bytecod3/Project-Shadow-Flight/payload/README.md

## References 
- https://stm32-base.org/boards/STM32F407VGT6-STM32F4XX-M.html
- https://blog.shirtec.com/2019/12/ov5640-with-stm32f427.html
