bytecod3/Project-Shadow-Flight/documentation/plant-uml-diagrams/README.md

## To generate UML diagram 
Go to downloads folder, then run:
``` java -jar plantuml.jar -gui```

It will open a GUI with a button to change directory:
CLick and open this directory. 

Now if you make any change to a uml.md file, a corresponding png file will be generated
