bytecod3/Project-Shadow-Flight/documentation/Project Shadow Flight Technical Report .docx

## Project Shadow Flight - A 1U Amateur CubeSat Built from the Ground Up

## Technical Report

## Edwin Mwiti

Table of Contents

Executive Summary

Introduction

1.1. Mission Statement & Objectives

1.2. Project Motivation

1.3. System Overview

Mission Architecture

3.1. Mission Design

3.2. Payload Requirements & Specifications

3.3. Operational Concept

System Design

4.1. Onboard Computer (OBC)

4.1.1. Functional Requirements

4.1.2. Hardware Architecture

4.1.3. Software Architecture

4.2. Sensor System

4.2.1. Sensor Requirements

4.2.2. Communication Protocol

4.2.3. PC/104 ISA Bus Interface

4.2.4. Pin Definition & Interface

4.3. Attitude Determination and Control System (ADCS)

4.4. Electrical Power System (EPS)

4.4.1. Power Generation (Solar Arrays)

4.4.2. Energy Storage (Battery System)

4.4.3. Power Distribution & Regulation

4.4.4. Mission Power Analysis

4.4.5. EPS Schematic & Design

4.4.6. System Testing & Integration

4.5. Communication System

4.5.1. CCSDS Telemetry Protocol Implementation

4.5.2. Ground Station Interface

4.5.3. Data Handling & Limitations

Integration & Testing

5.1. Component-Level Testing

5.2. System Integration

5.3. Environmental Testing

5.4. Operational Testing

Mission Operations

6.1. Command & Data Handling

6.2. Telemetry & Telecommand

6.3. Contingency Procedures

Project Documentation

7.1. Design Documentation

7.2. Visual Media & Resources

7.3. Web Documentation

Appendices

A. Component Specifications

B. Test Procedures & Results

C. Communication Protocol Details

D. Schematics & PCB Layouts

E. 3D Models & Mechanical Drawings

References

Acknowledgements

10.1. Contributors

10.2. Supporting Organizations

Onboard Computer (OBC)

Attitude Determination and Control Unit (ADCU)

Communication Board

Payload

Electrical Power Supply System (EPS)

The EPS system is responsible for supplying power to itself and all other subsystems in the cubesat. This section will describe the features of the EPS design, design decisions, design tradeoffs, strengths, and areas of improvement. Code snippets of the EPS subsystem are also provided for quick reference and explanation. The full firmware explanation is included in sections below for completeness.

Firmware Design

Architecture Diagram

Firmware requirements

OBC

COMMS

ADCU

Payload

EPS

References

1. https://ww1.microchip.com/downloads/aemDocuments/documents/OTH/ApplicationNotes/ApplicationNotes/00001521A.pdf
