bytecod3/Project-Shadow-Flight/datasheets/black-pill-pinout.png

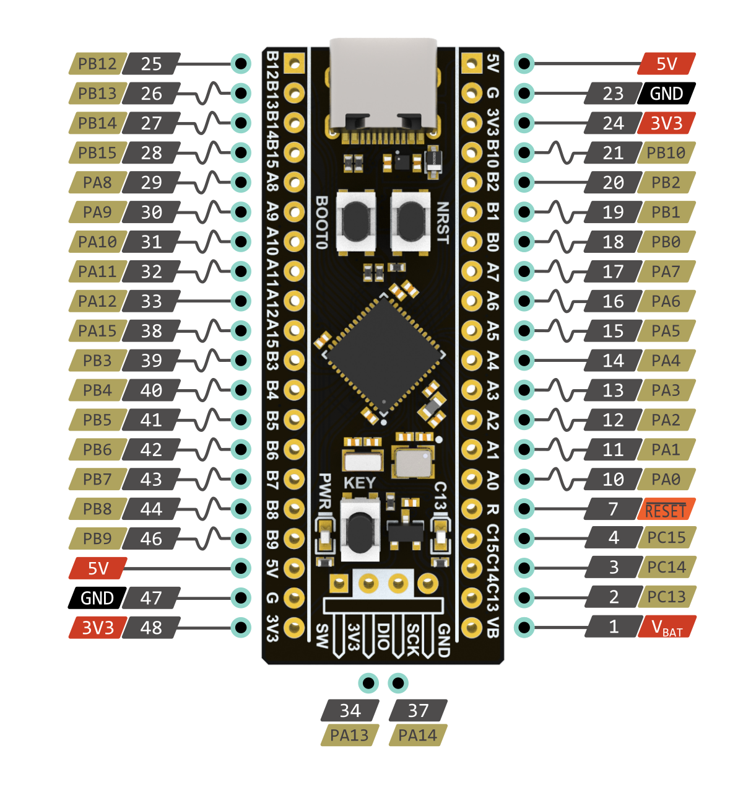
datasheets/black-pill-pinout.png
