bytecod3/Project-Shadow-Flight/datasheets/Pinout-Diagram-blackpill-nerokas.png

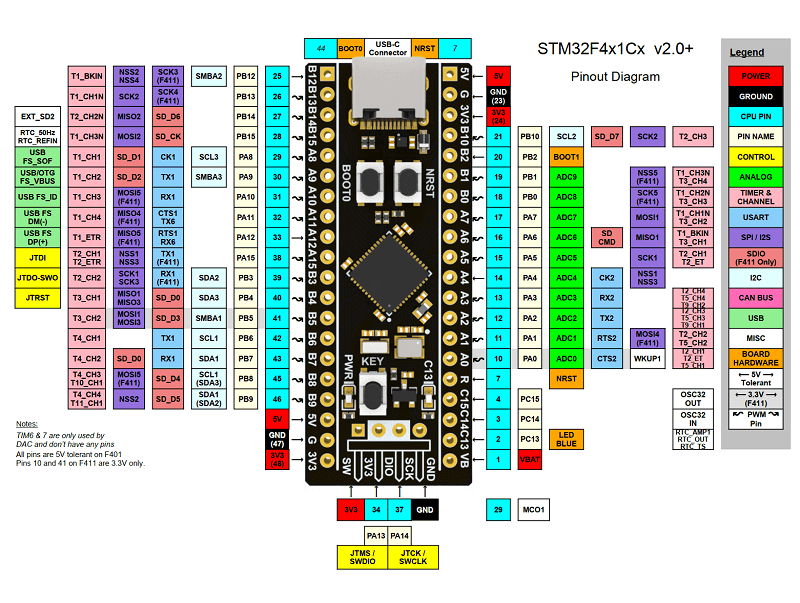
datasheets/Pinout-Diagram-blackpill-nerokas.png
