bytecod3/Project-Shadow-Flight/datasheets/STLINK-V2-JTAG-HEADER-PINOUT.png

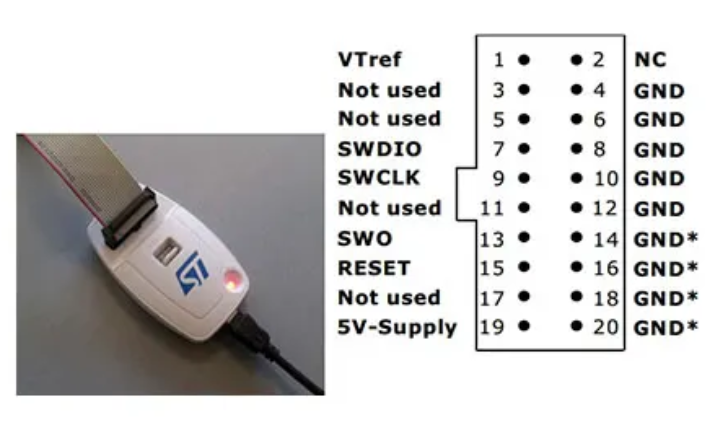
datasheets/STLINK-V2-JTAG-HEADER-PINOUT.png
