bytecod3/Project-Shadow-Flight/documentation/firmware-docs/html/user-docs/images/payload-1.png

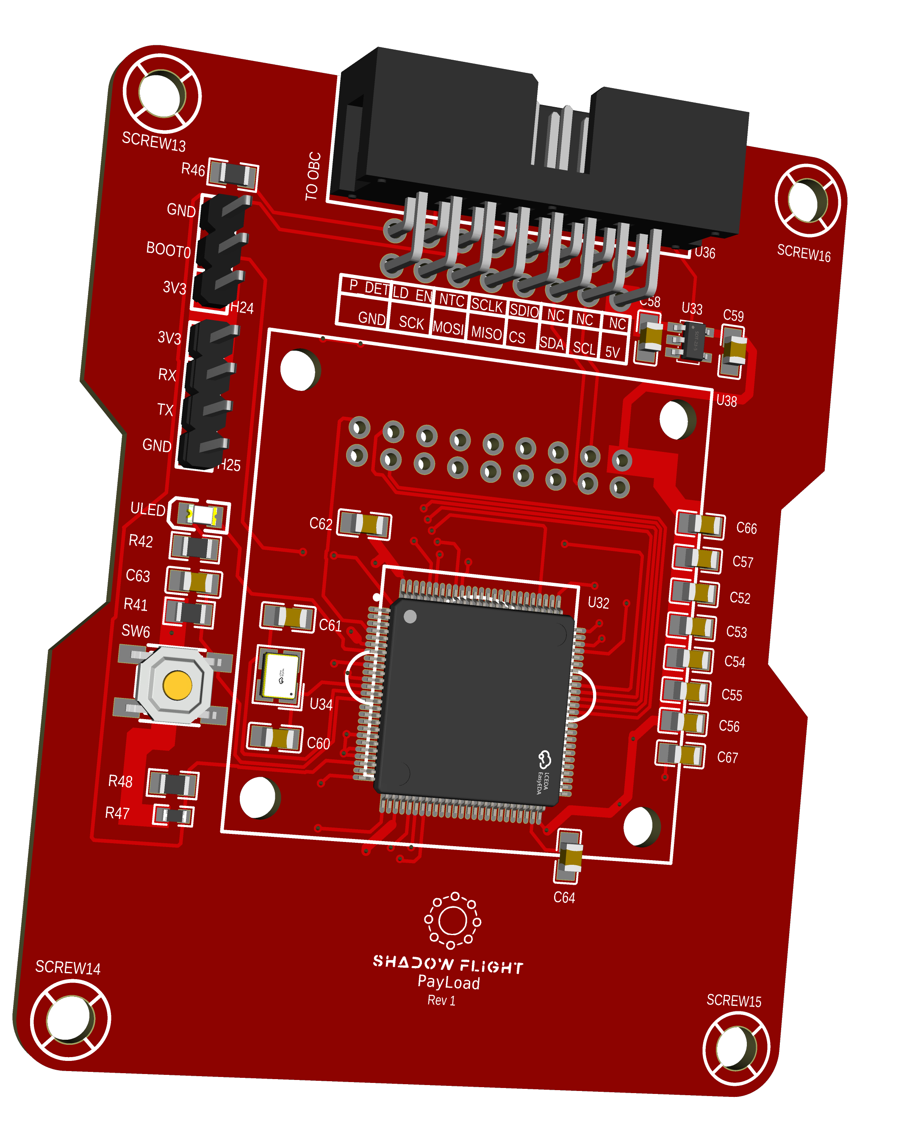
documentation/firmware-docs/html/user-docs/images/payload-1.png
