bytecod3/Project-Shadow-Flight/documentation/firmware-docs/html/user-docs/images/payload-2.png

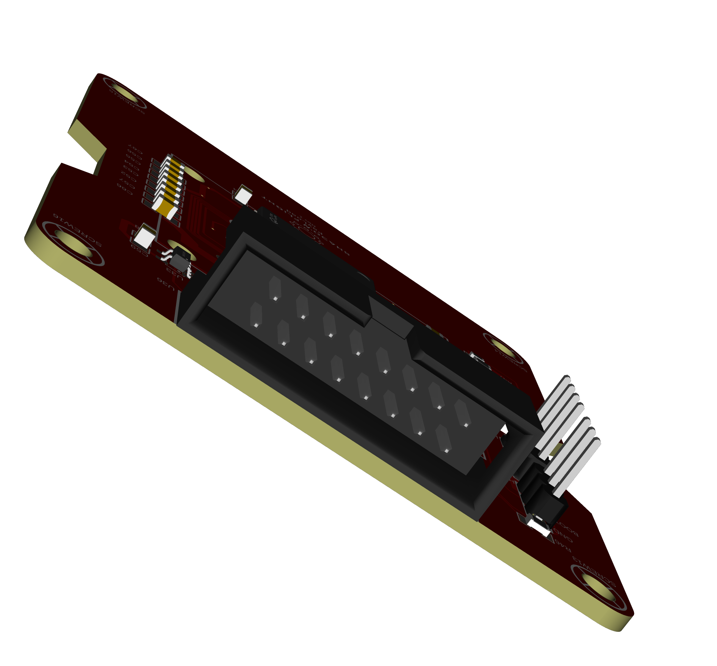
documentation/firmware-docs/html/user-docs/images/payload-2.png
