bytecod3/Project-Shadow-Flight/documentation/firmware-docs/html/user-docs/images/payload-3.png

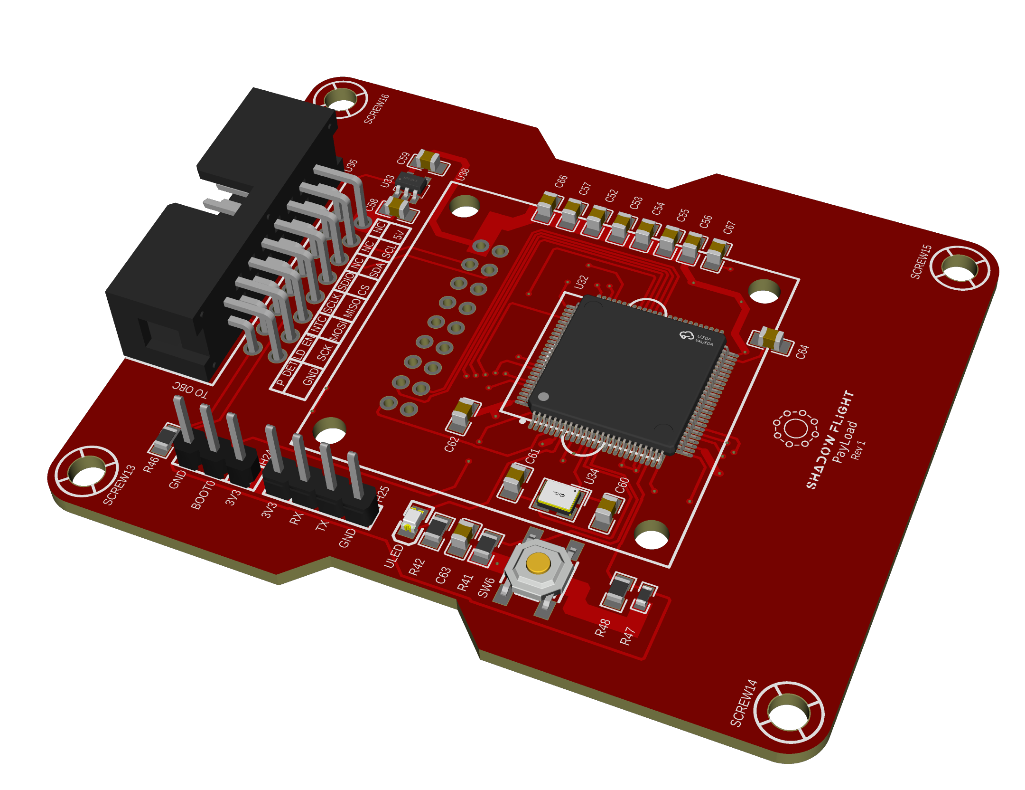
documentation/firmware-docs/html/user-docs/images/payload-3.png
