bytecod3/Project-Shadow-Flight/documentation/firmware-docs/html/user-docs/images/payload-black.png

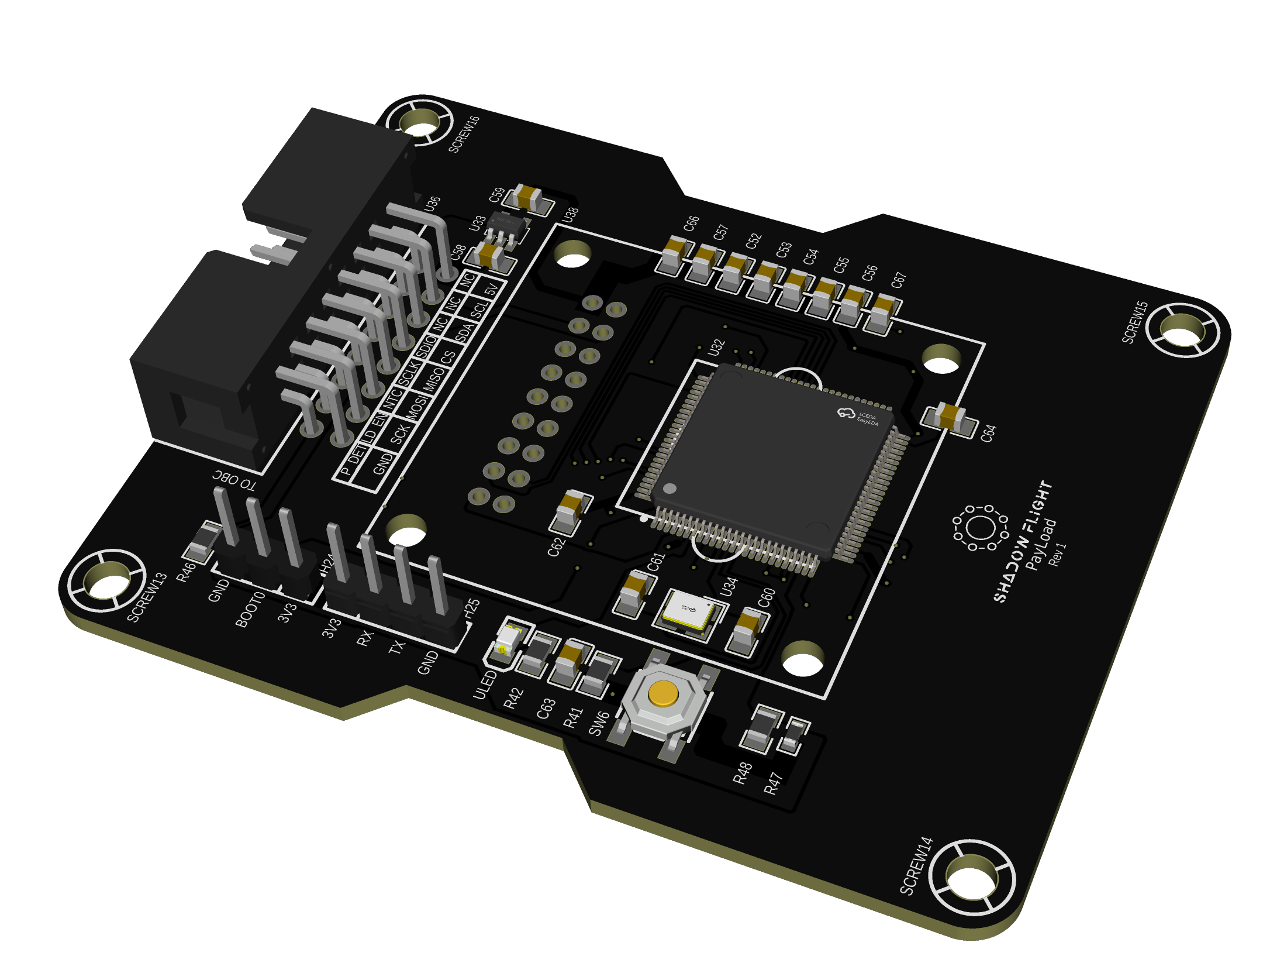
documentation/firmware-docs/html/user-docs/images/payload-black.png
