bytecod3/Project-Shadow-Flight/documentation/firmware-docs/html/user-docs/images/sensors-21-07361-g001.webp

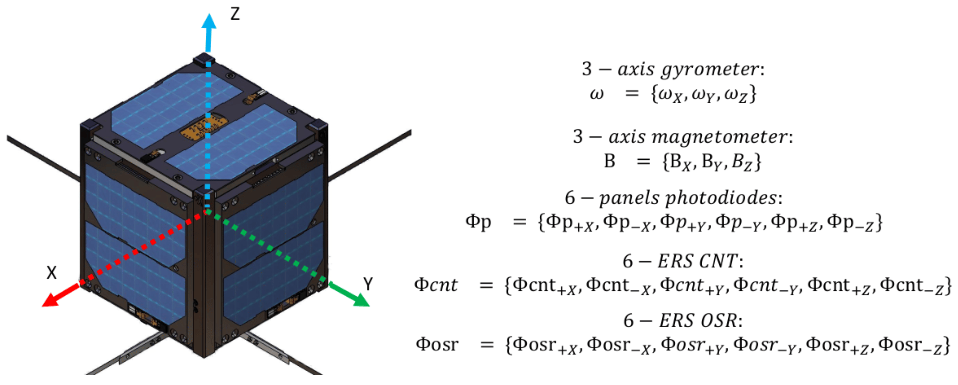
documentation/firmware-docs/html/user-docs/images/sensors-21-07361-g001.webp
