bytecod3/Project-Shadow-Flight/documentation/plant-uml-diagrams/payload-state.png

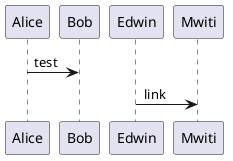
documentation/plant-uml-diagrams/payload-state.png
