bytecod3/Project-Shadow-Flight/EPS-design/references/bq25703.png

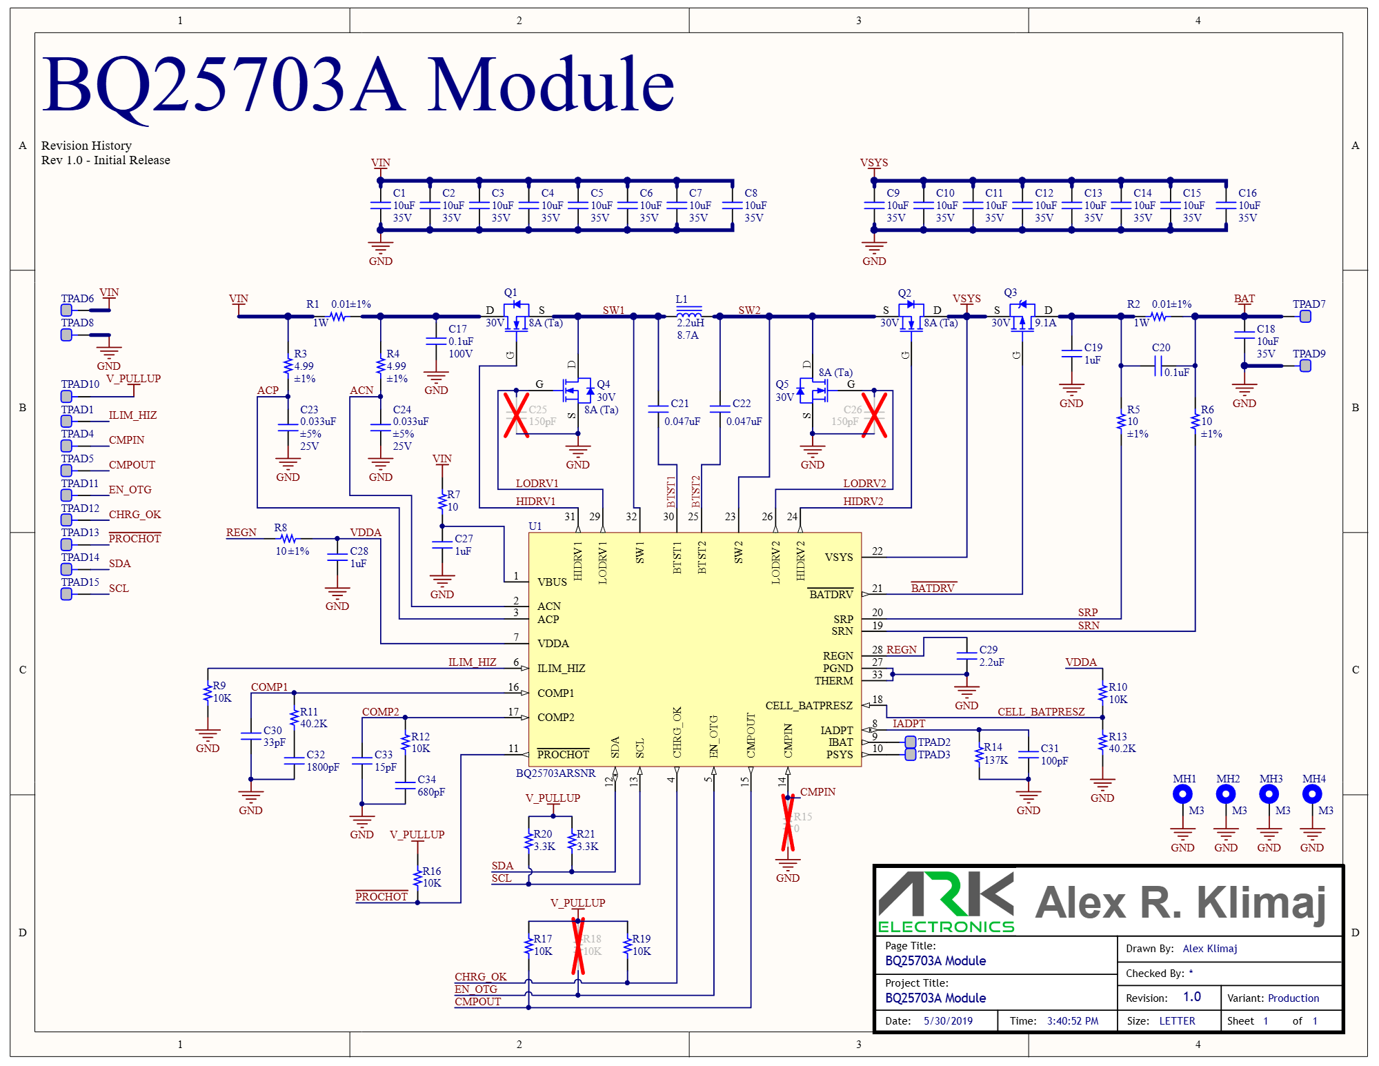
EPS-design/references/bq25703.png
