bytecod3/Project-Shadow-Flight/ground-testing/orange-pi-3/docs/Zero3-pinout.png

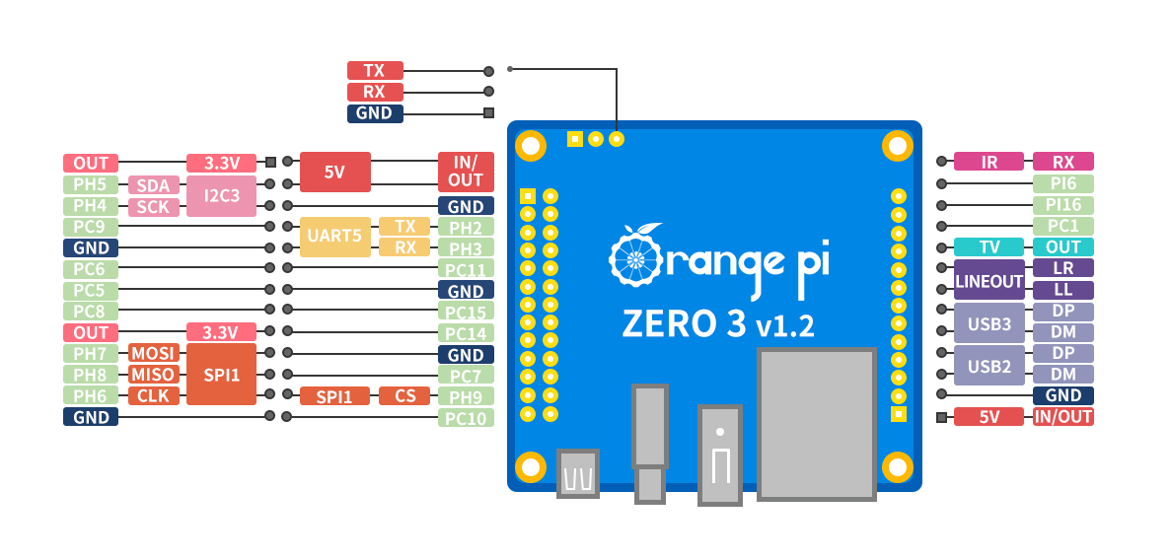
ground-testing/orange-pi-3/docs/Zero3-pinout.png
