bytecod3/Project-Shadow-Flight/payload/docs/images/clock_config.png

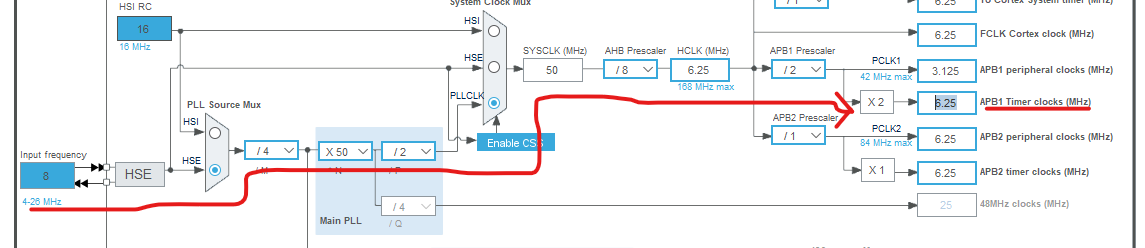
payload/docs/images/clock_config.png
