bytecod3/Project-Shadow-Flight/payload/docs/images/temp_channel_config.png

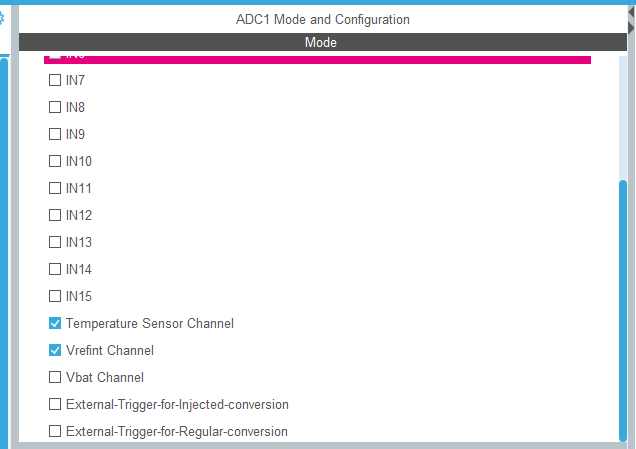
payload/docs/images/temp_channel_config.png
