bytecod3/Project-Shadow-Flight/payload/first-images/genesis_img_9192026.png

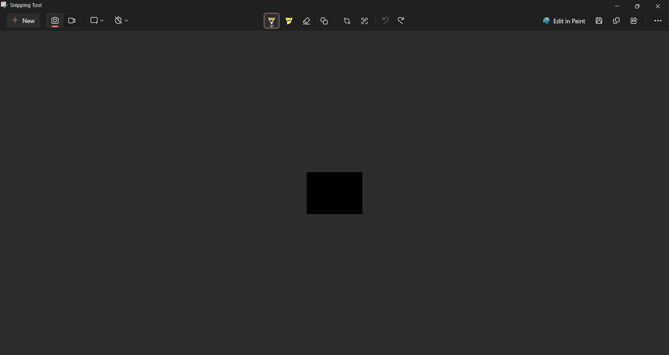
payload/first-images/genesis_img_9192026.png
