bytecod3/Project-Shadow-Flight/references/CubeSat_Design_Specification_rev._12_-_1U_dimensions_-_main.png

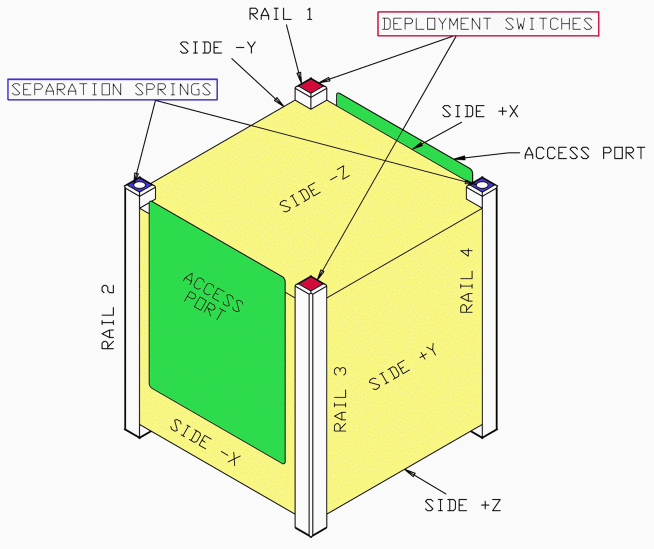
references/CubeSat_Design_Specification_rev._12_-_1U_dimensions_-_main.png
