bytecod3/Project-Shadow-Flight/references/image003.jpg

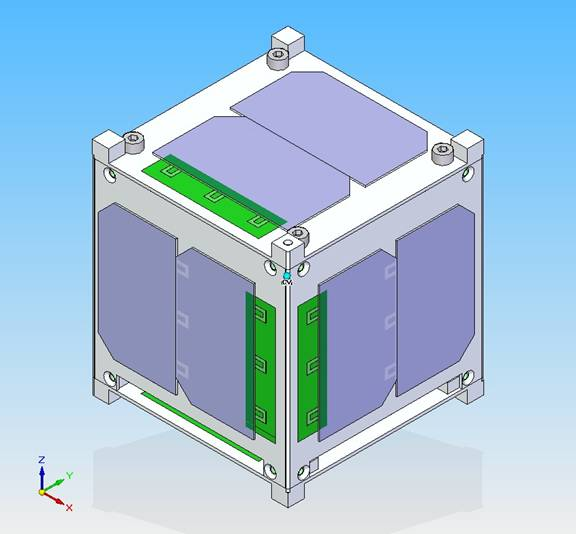
references/image003.jpg
