bytecod3/Project-Shadow-Flight/references/structure/images/corner.png

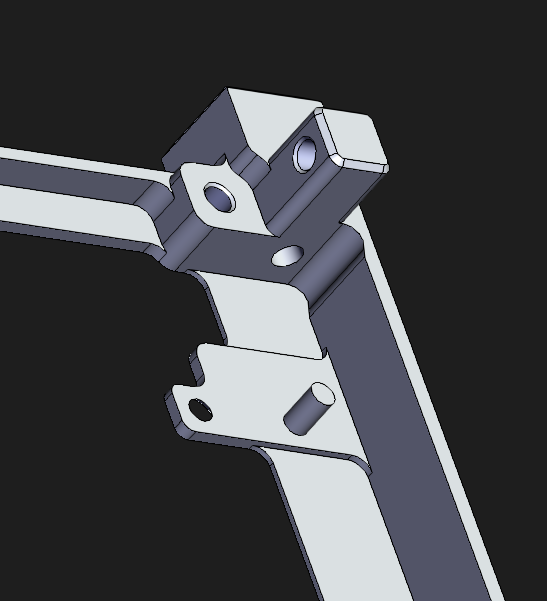
references/structure/images/corner.png
