bytecod3/Project-Shadow-Flight/references/structure/images/cubesat-image02.jpg

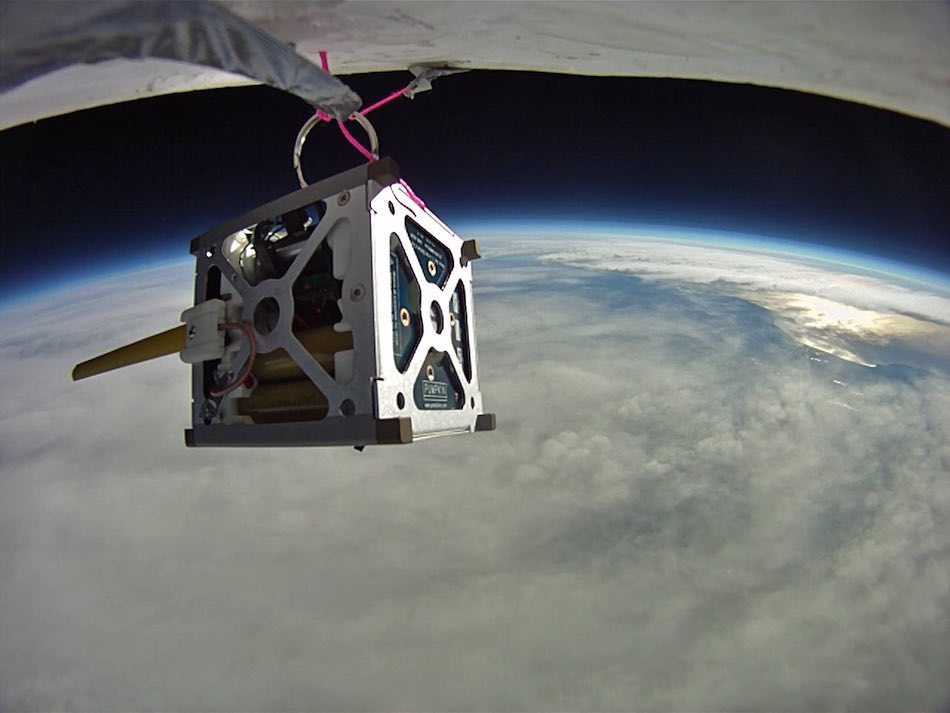
references/structure/images/cubesat-image02.jpg
