bytecod3/Project-Shadow-Flight/references/structure/images/empty-shelf-2.png

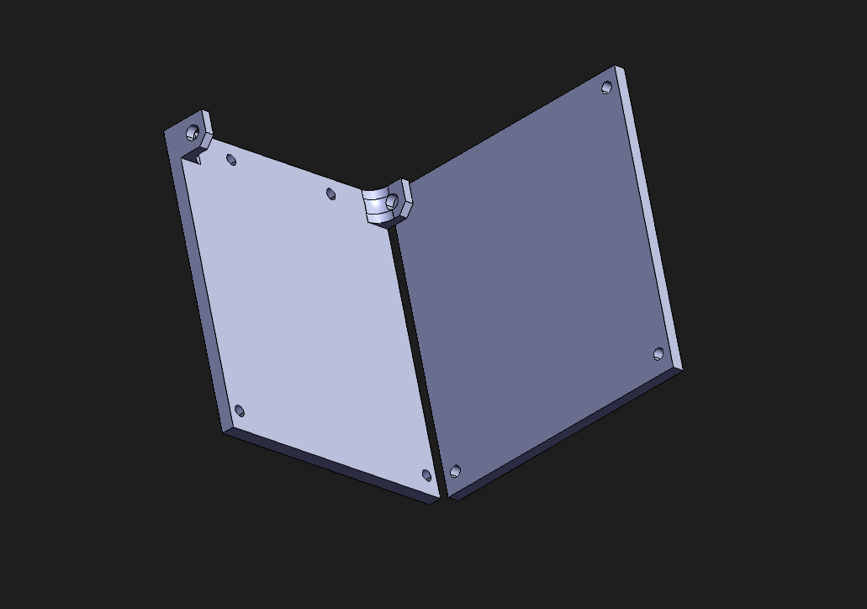
references/structure/images/empty-shelf-2.png
