bytecod3/Project-Shadow-Flight/references/structure/images/empty-shelf.png

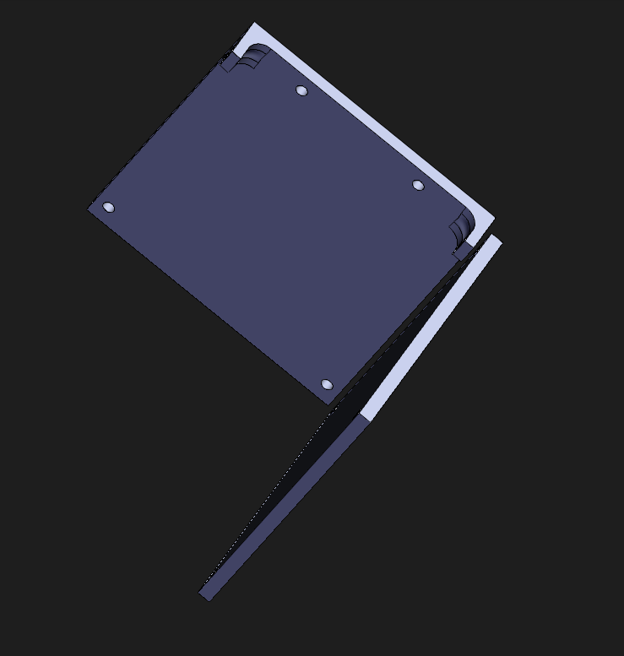
references/structure/images/empty-shelf.png
