bytecod3/Project-Shadow-Flight/references/structure/images/full-structure.png

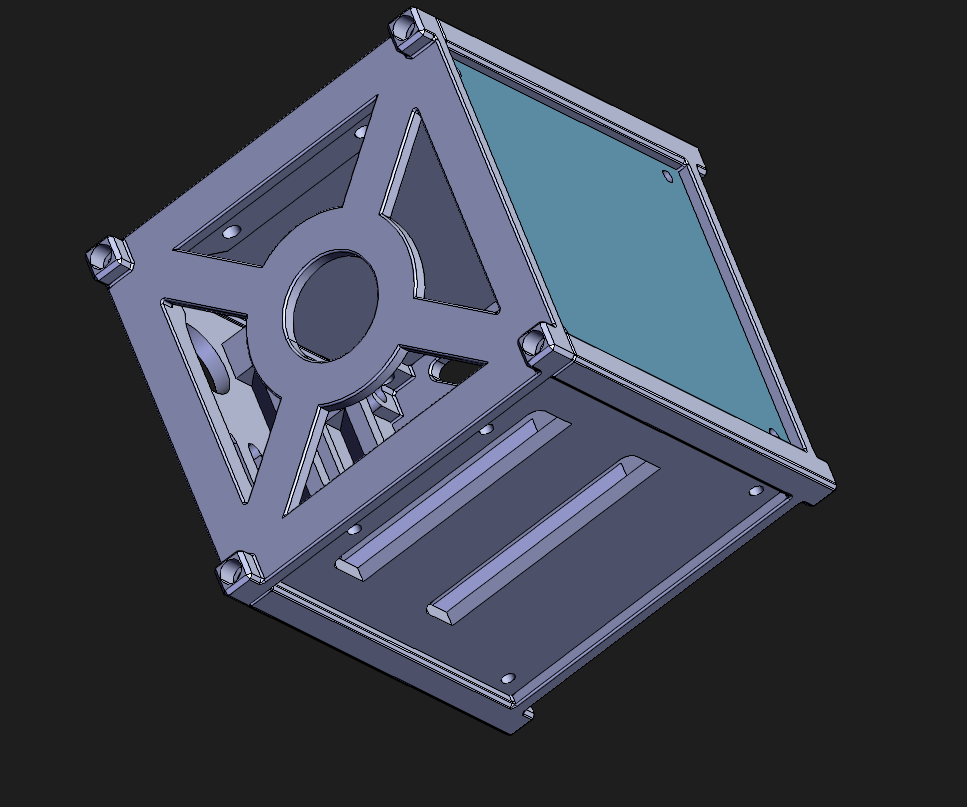
references/structure/images/full-structure.png
