bytecod3/Project-Shadow-Flight/references/structure/images/isometric.png

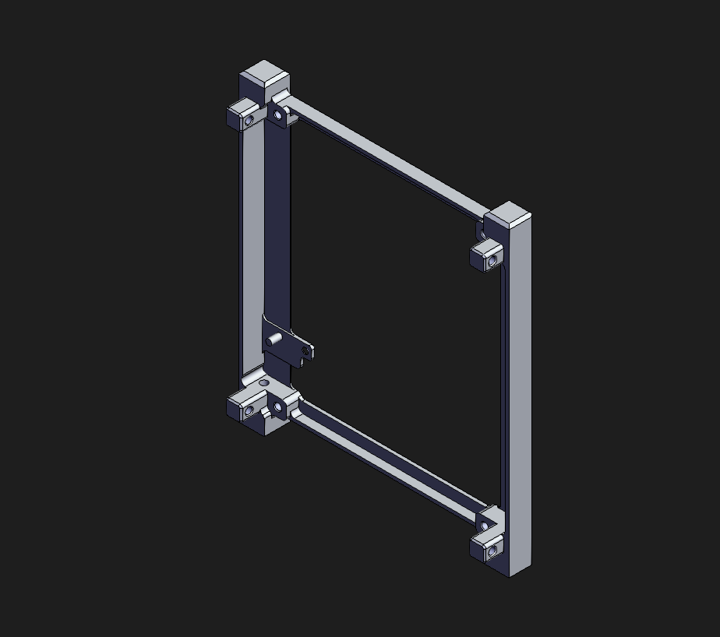
references/structure/images/isometric.png
