bytecod3/Project-Shadow-Flight/references/structure/images/large.png

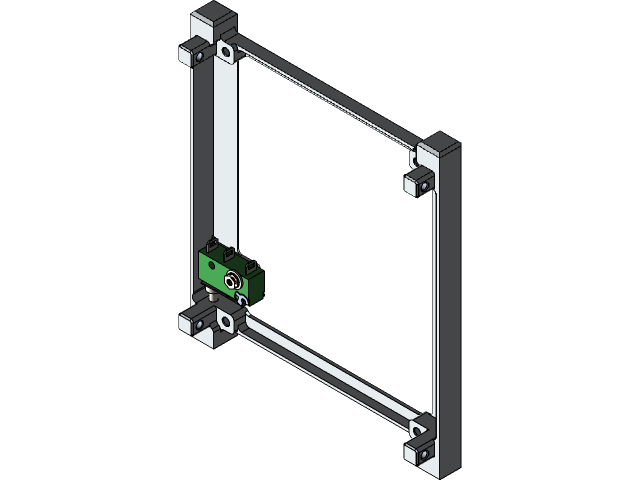
references/structure/images/large.png
