bytecod3/Project-Shadow-Flight/references/structure/images/poles+empty-shelf.png

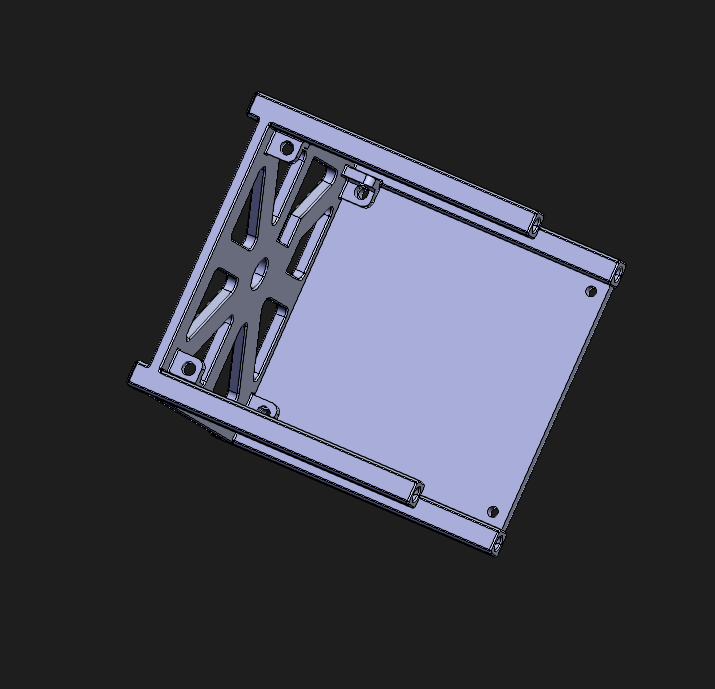
references/structure/images/poles+empty-shelf.png
