bytecod3/Project-Shadow-Flight/references/structure/images/poles+shelf+top.png

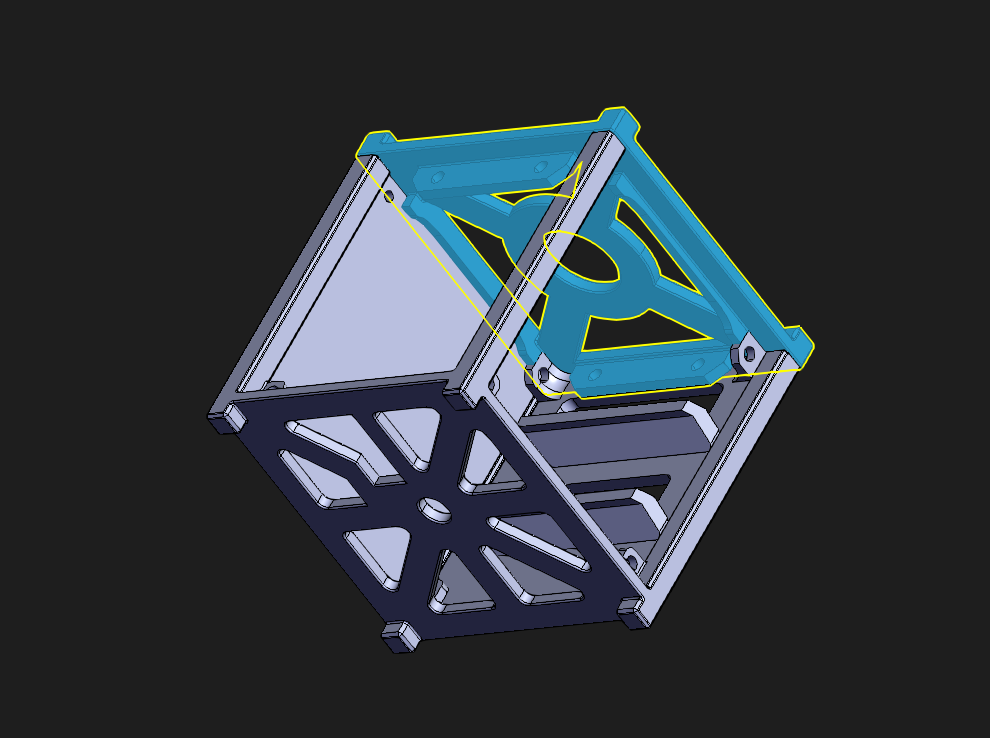
references/structure/images/poles+shelf+top.png
