bytecod3/Project-Shadow-Flight/references/structure/images/poles-bottom.png

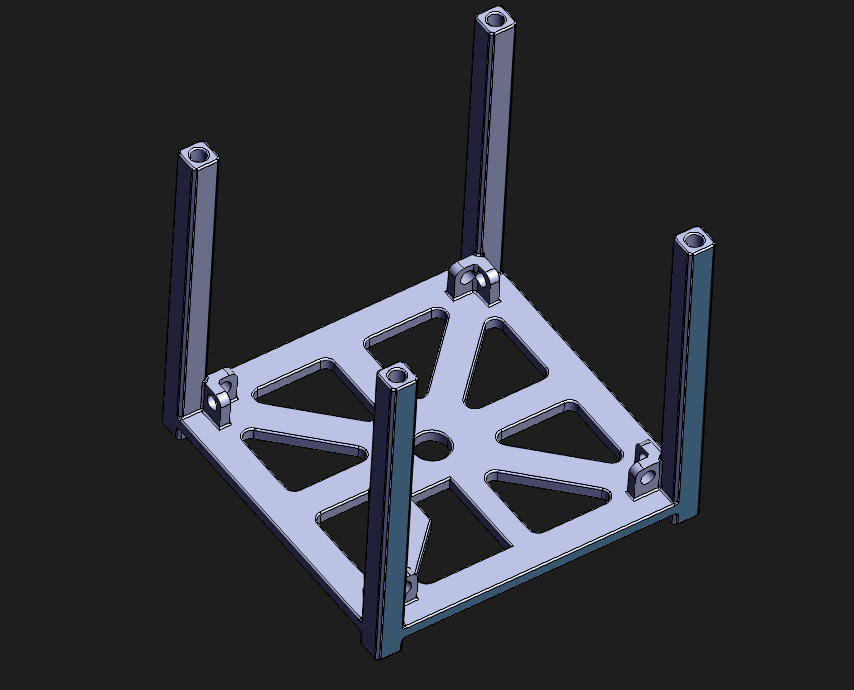
references/structure/images/poles-bottom.png
