bytecod3/Project-Shadow-Flight/references/structure/images/rbf-3.png

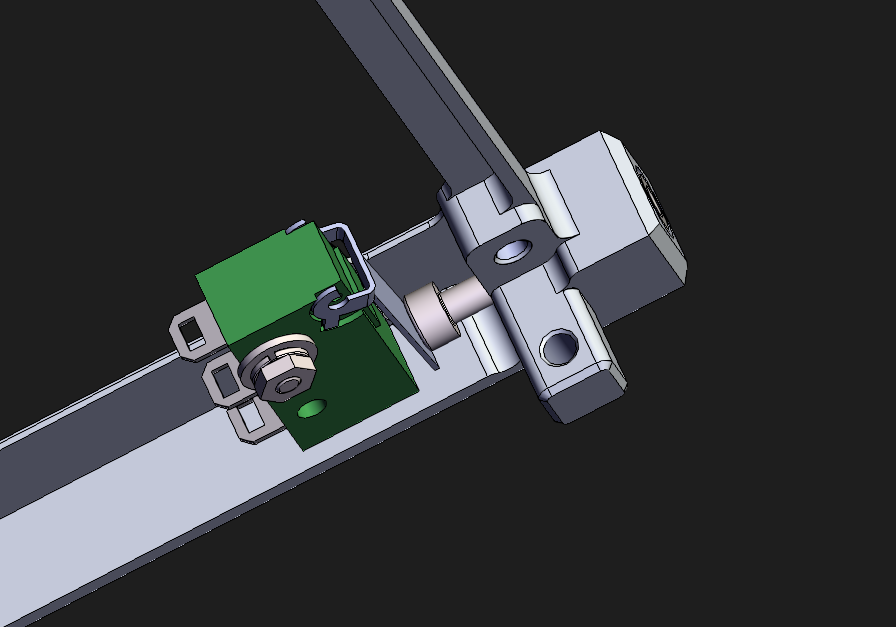
references/structure/images/rbf-3.png
