bytecod3/Project-Shadow-Flight/references/structure/images/rbf-mount-2.png

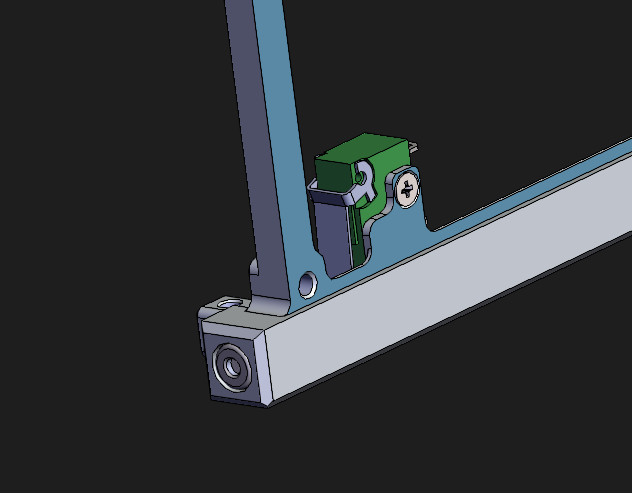
references/structure/images/rbf-mount-2.png
