bytecod3/Project-Shadow-Flight/references/structure/images/RBF-MOUNT.png

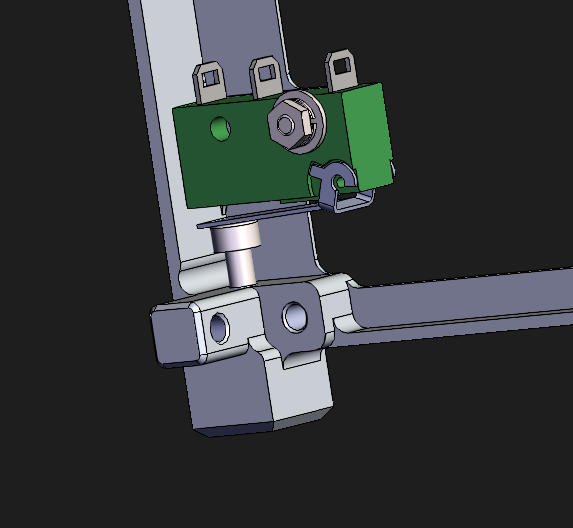
references/structure/images/RBF-MOUNT.png
