bytecod3/Project-Shadow-Flight/references/structure/images/self-side.png

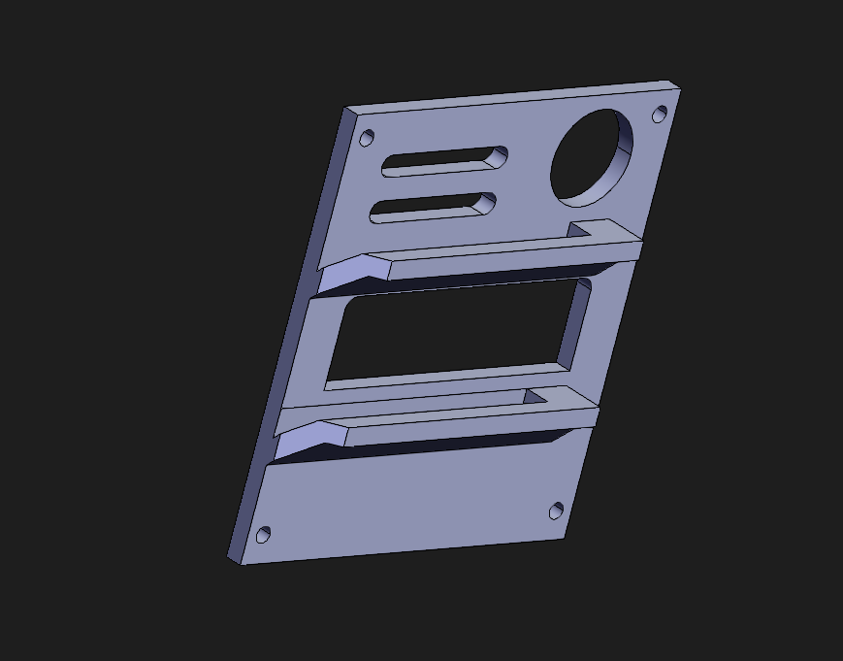
references/structure/images/self-side.png
