bytecod3/Project-Shadow-Flight/references/structure/images/shelf-front.png

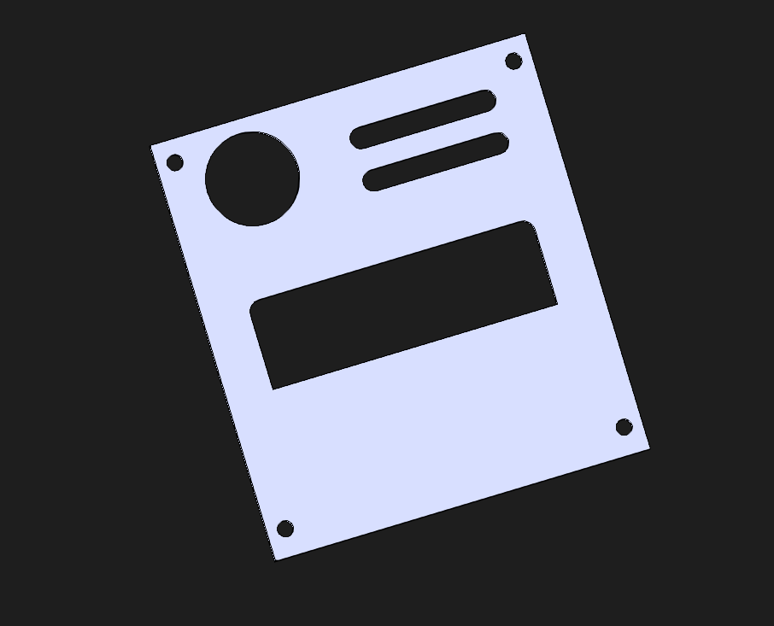
references/structure/images/shelf-front.png
