bytecod3/Project-Shadow-Flight/references/structure/images/shelf-joint.png

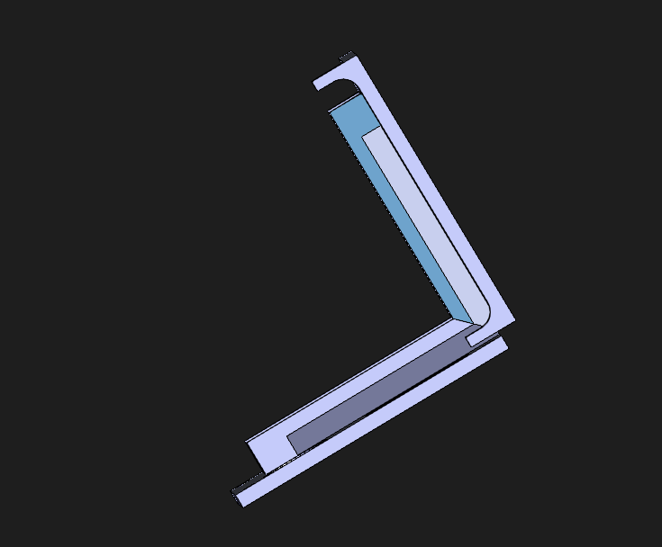
references/structure/images/shelf-joint.png
