bytecod3/Project-Shadow-Flight/references/structure/images/shelf-side-2.png

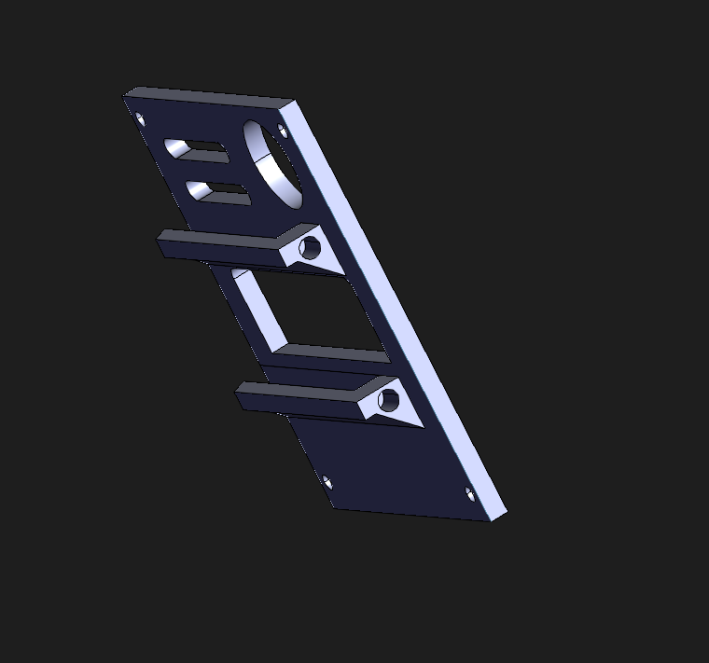
references/structure/images/shelf-side-2.png
