bytecod3/Project-Shadow-Flight/references/structure/images/side-view.png

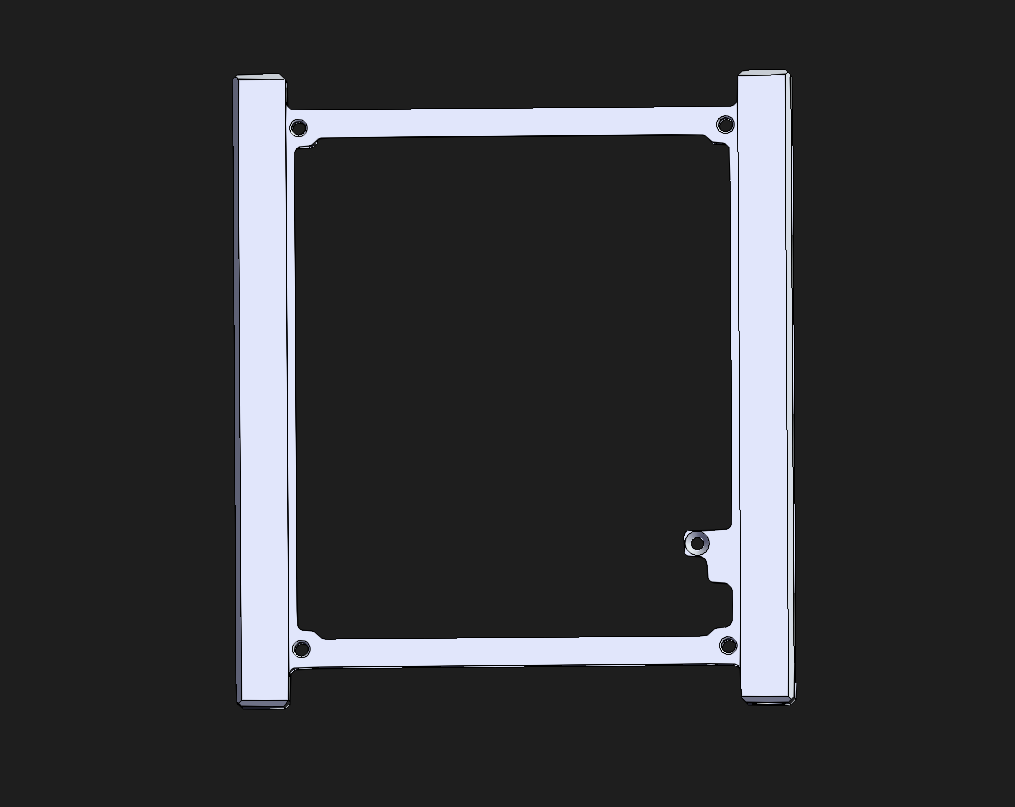
references/structure/images/side-view.png
