bytecod3/Project-Shadow-Flight/references/structure/images/top-panel.png

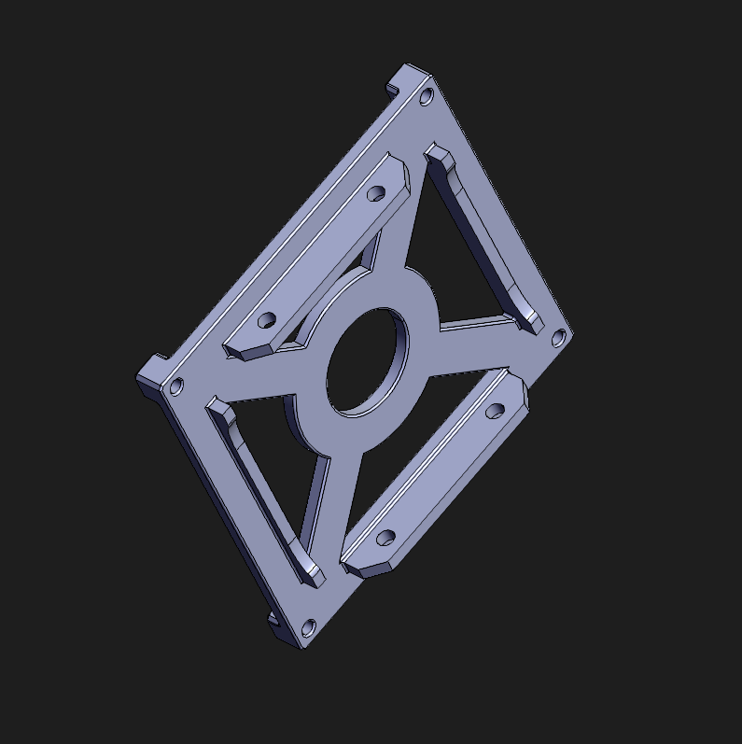
references/structure/images/top-panel.png
