bytecod3/Project-Shadow-Flight/references/structure/images/without-top.png

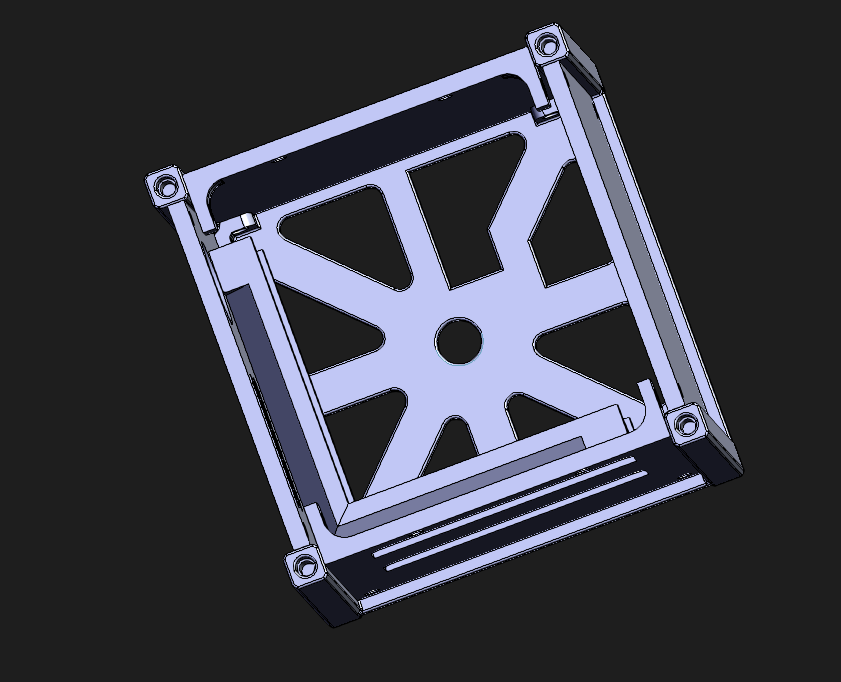
references/structure/images/without-top.png
