bytecod3/Project-Shadow-Flight/references/TEMT6000X01.png

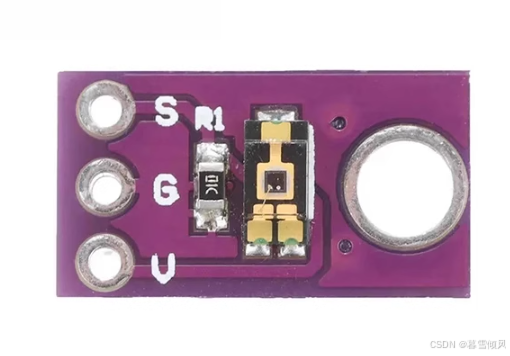
references/TEMT6000X01.png
