bytecod3/Project-Shadow-Flight/structure/structure-teaser.png

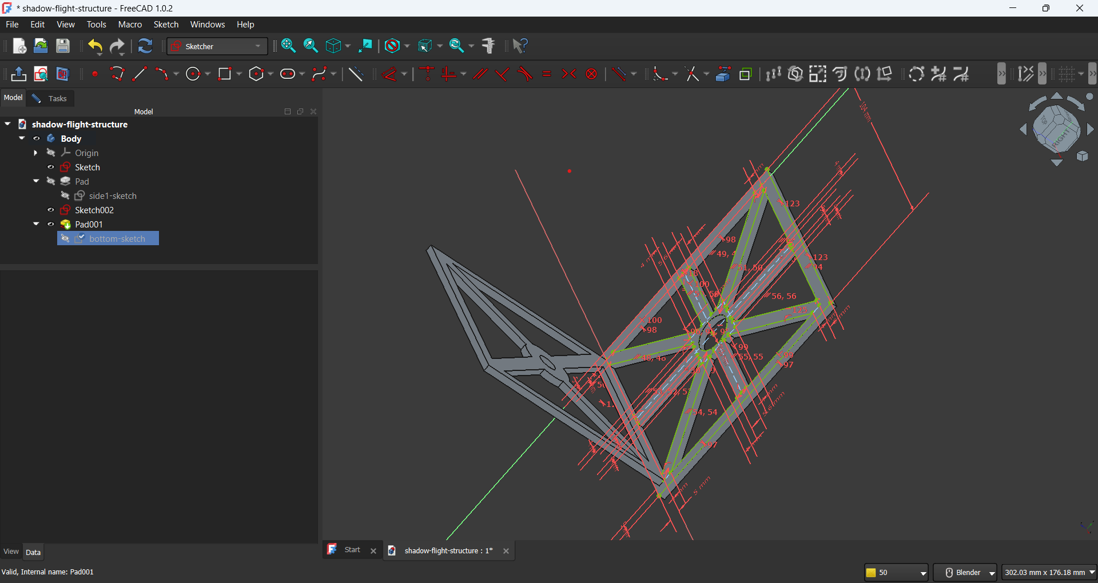
structure/structure-teaser.png
