bytecod3/Project-Shadow-Flight/user-docs/images/camera-module.png

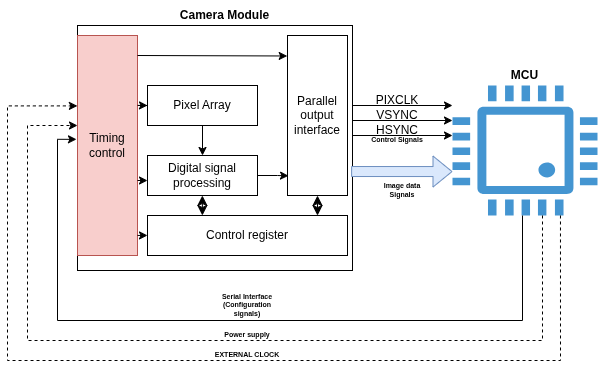
user-docs/images/camera-module.png
