bytecod3/Project-Shadow-Flight/user-docs/images/camera-ov7670.jpg

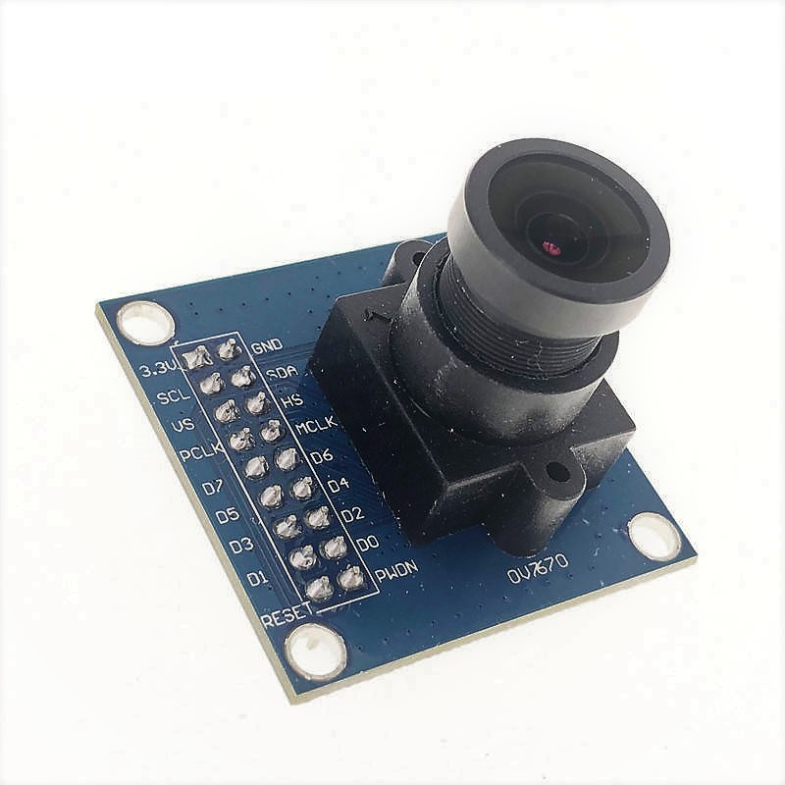
user-docs/images/camera-ov7670.jpg
