bytecod3/Project-Shadow-Flight/prod-files/v1/project_shadow_flight_BOM_Combined.xlsx

No. | Quantity | Comment | Designator | Footprint | Value | Manufacturer Part | Manufacturer | Supplier Part | Supplier | LCSC Price | JLCPCB Stock
1 | 1 | 2.7kHz | BUZZER1 | BUZ-SMD_4P-L8.5-W8.5-P8.50-BR | 2.7kHz | MLT-8530 | 华能 | C94599 | LCSC |  | 102098
2 | 49 | 100nF | C1,C2,C3,C4,C5,C9,C10,C11,C12,C13,C14,C15,C16,C17,C25,C26,C27,C28,C29,C33,C34,C35,C36,C39,C40,C42,C43,C48,C52,C53,C54,C55,C56,C63,C66,C68,C74,C75,C76,C77,C78,C80,C91,C95,C114,C116,C117,C135,C136 | C0805 | 100nF | CC0805KRX7R9BB104 | YAGEO(国巨) | C49678 | LCSC |  | 15027749
3 | 21 | 10uF | C6,C30,C57,C79,C96,C97,C98,C99,C101,C102,C103,C104,C105,C106,C107,C108,C109,C110,C111,C112,C113 | C0805 | 10uF | CL21A106KAYNNNE | SAMSUNG(三星) | C15850 | LCSC |  | 4227544
4 | 8 | 6pF | C7,C8,C31,C32,C60,C61,C81,C82 | C0805 | 6pF | 0805CG6R0C500NT | FH(风华) | C67560 | LCSC |  | 18864
5 | 18 | 1uF | C18,C19,C21,C22,C44,C45,C46,C47,C58,C59,C118,C119,C120,C122,C124,C127,C129,C130 | C0805 | 1uF | CL21B105KAFNNNE | SAMSUNG(三星) | C116352 | LCSC |  | 556965
6 | 1 | 2.2nF | C37 | C0805 | 2.2nF | ECHU1H222GX5 | PANASONIC(松下) | C569854 | LCSC |  | 2810
7 | 2 | 10nF | C38,C62 | C0805 | 10nF | GCJ21BR72E103KXJ3L | muRata(村田) | C417148 | LCSC |  | 1738
8 | 2 | 100nF | C49,C69 | C0603 | 100nF | CC0603KRX7R9BB104 | YAGEO(国巨) | C14663 | LCSC |  | 43866013
9 | 1 | 10uF | C50 | C0603 | 10uF | CL10A106KP8NNNC | SAMSUNG(三星) | C19702 | LCSC |  | 9791300
10 | 1 | 470pF | C51 | C0603 | 470pF | CC0603JRNPO9BN471 | YAGEO(国巨) | C106211 | LCSC |  | 224541
11 | 4 | 2.2uF | C64,C67,C132,C133 | C0805 | 2.2uF | CL21B225KAFNNNE | SAMSUNG(三星) | C19110 | LCSC |  | 775294
12 | 1 | 680uF | C70 | CAP-SMD_BD10.0-L10.3-W10.3-FD-LS11.0_H12.0 | 680uF | MA35V680M10X13 | JIERR(捷而瑞) | C48971043 | LCSC |  | 13414
13 | 1 | 22uF | C72 | C0805 | 22uF | CL21A226MAYNNNE | SAMSUNG(三星) | C602037 | LCSC |  | 844669
14 | 1 | 47uF | C73 | C0805 | 47uF | CL21A476MQYNNNE | SAMSUNG(三星) | C16780 | LCSC |  | 583317
15 | 3 | 1uF | C84,C85,C92 | C0805 | 1uF | CL21B105KBFNNNE | SAMSUNG(三星) | C28323 | LCSC |  | 3089579
16 | 2 | 33nF | C86,C87 | C0805 | 33nF | CC0805KRX7R9BB333 | YAGEO(国巨) | C107150 | LCSC |  | 372064
17 | 1 | 100pF | C88 | C0805 | 100pF | CL21C101JBANNNC | SAMSUNG(三星) | C1790 | LCSC |  | 1599234
18 | 1 | 15pF | C89 | C0805 | 15pF | TCC0805COG150J500BT | CCTC(三环) | C376865 | LCSC |  | 12239
19 | 1 | 680pF | C90 | C0805 | 680pF | 0805B681K500NT | FH(风华) | C1754 | LCSC |  | 35386
20 | 2 | 47nF | C93,C94 | C0805 | 47nF | CC0805KRX7R9BB473 | YAGEO(国巨) | C107154 | LCSC |  | 114765
21 | 2 | 4.7nF | C123,C128 | C0805 | 4.7nF | CC0805KRX7R9BB472 | YAGEO(国巨) | C107153 | LCSC |  | 154913
22 | 1 | 1nF | C126 | C0805 | 1nF | CC0805KRX7R9BB102 | YAGEO(国巨) | C94121 | LCSC |  | 2308830
23 | 1 | 4.7uF | C131 | C0805 | 4.7uF | CL21A475KBQNNNE | SAMSUNG(三星) | C98192 | LCSC |  | 1081605
24 | 1 | 10nF | C134 | C0805 | 10nF | CL21B103KBANNNC | SAMSUNG(三星) | C1710 | LCSC |  | 3782096
25 | 1 | DM3AT-SF-PEJM5 | CARD1 | SD-SMD_DM3AT-SF-PEJM5 |  | DM3AT-SF-PEJM5 | HRS(广濑) | C114218 | LCSC |  | 11930
26 | 1 | SS14 | D2 | SMA_L4.3-W2.6-LS5.2-RD |  | SS14 | onsemi(安森美) | C83852 | LCSC |  | 69053
27 | 9 | SS54 | D3,D5,D6,D9,D10,D11,D12,D13,D14 | SMA_L4.4-W2.8-LS5.4-R-RD |  | SS54 | MDD(辰达半导体) | C22452 | LCSC |  | 1000100
28 | 1 | DC-005-5A-2.0 | DC1 | DC-IN-TH_DC-005-5A-2.0 |  | DC-005-5A-2.0 | XKB Connection(中国星坤) | C381116 | LCSC |  | 8673
29 | 4 | HDR-M_2.54_1x4P | H1,H23,H25,H30 | HDR-TH_4P-P2.54-V-M |  |  |  |  |  | 42.7115
30 | 10 | HDR-M_2.54_1x3P | H2,H5,H9,H10,H11,H12,H13,H14,H24,H29 | HDR-TH_3P-P2.54-V-M |  |  |  |  |  | 42.7115
31 | 5 | PZ254V-11-02P | H4,H15,H16,H17,H18 | HDR-TH_2P-P2.54-V-M |  | PZ254V-11-02P | XFCN(兴飞) | C492401 | LCSC |  | 1155992
32 | 1 | PZ254V-11-04P | H6 | HDR-TH_4P-P2.54-V-M |  | PZ254V-11-04P | XFCN(兴飞) | C2691448 | LCSC |  | 1083719
33 | 4 | PC104-2*20 | H8,H21,H22,H31 | HDR-TH_40P-P2.54-V-F-R2-C20-S2.54-2 |  | PC104-2*20 | ZHOURI(洲日) | C5307344 | LCSC |  | 12
34 | 2 | HDR-F_2.54_1x3P | H27,H28 | HDR-TH_3P-P2.54-V-F |  |  |  |  |  | 42.7115
35 | 1 | EN_2P_Z_P | H32 | HDR-TH_2P-P2.54-V-M |  | EN_2P_Z_P | XFCN(兴飞) | C492401 | LCSC |  | 1155992
36 | 1 | EN_2P_Z_M | H33 | HDR-TH_2P-P2.54-V-M |  | EN_2P_Z_M | XFCN(兴飞) | C492401 | LCSC |  | 1155992
37 | 1 | EN_2P_X_P | H34 | HDR-TH_2P-P2.54-V-M |  | EN_2P_X_P | XFCN(兴飞) | C492401 | LCSC |  | 1155992
38 | 1 | EN_2P_X_M | H35 | HDR-TH_2P-P2.54-V-M |  | EN_2P_X_M | XFCN(兴飞) | C492401 | LCSC |  | 1155992
39 | 1 | U.FL-R-SMT-1(80) | JP1 | RF-SMD_FRF05002-JSS103M |  | U.FL-R-SMT-1(80) | HRS(广濑) | C88374 | LCSC |  | 254330
40 | 1 | 6.8nH | L3 | L0603 | 6.8nH | LQW18AN6N8C00D | muRata(村田) | C86136 | LCSC |  | 41766
41 | 1 | 33uH | L4 | IND-SMD_L12.3-W12.3 | 33uH | SMDRI127-330MT | SXN(顺翔诺) | C9400 | LCSC |  | 45915
42 | 1 | ULED1 | LED1 | LED0805-R-RD |  | ULED1 | TOGIALED(统佳) | C601703 | LCSC |  | 1773
43 | 4 | WS2812B-2020 | LED2,LED3,LED4,LED5 | LED-SMD_4P-L2.0-W2.0-TL_WS2812B-2020 |  | WS2812B-2020 | worldsemi | C965555 | LCSC |  | 493764
44 | 1 | LED1 | LED6 | LED0805-R-RD |  | LED1 | TOGIALED(统佳) | C601703 | LCSC |  | 1773
45 | 1 | LED2 | LED7 | LED0805-R-RD |  | LED2 | TOGIALED(统佳) | C601703 | LCSC |  | 1773
46 | 3 | LED3 | LED8,LED17,LED18 | LED0805-R-RD |  | LED3 | TOGIALED(统佳) | C601703 | LCSC |  | 1773
47 | 3 | ADCS_POW | LED9,LED11,LED13 | LED0805-R-RD |  | ADCS_POW | TOGIALED(统佳) | C601703 | LCSC |  | 1773
48 | 2 | XL-1608SURC-06 | LED10,LED12 | LED0603-RD_RED |  | XL-1608SURC-06 | XINGLIGHT(成兴光) | C965799 | LCSC |  | 6466315
49 | 1 | RED | LED14 | LED0805-RD_RED |  | RED | XINGLIGHT(成兴光) | C965812 | LCSC |  | 1704579
50 | 1 | 12V_DC_OK | LED15 | LED0805-R-RD |  | 12V_DC_OK | TOGIALED(统佳) | C601703 | LCSC |  | 1773
51 | 1 | INHIBIT_OFF | LED16 | LED0805-R-RD |  | INHIBIT_OFF | TOGIALED(统佳) | C601703 | LCSC |  | 1773
52 | 2 | 2N2222AU | Q1,Q2 | SOT-89-3_L4.5-W2.4-P1.50-LS4.0-BR |  | 2N2222AU | CBI(创基) | C21714170 | LCSC |  | 11063
53 | 1 | AO3401A | Q4 | SOT-23_L2.9-W1.3-P1.90-LS2.4-BR |  | AO3401A | AOS | C15127 | LCSC |  | 2448432
54 | 1 | NCE4435 | Q6 | SOP-8_L5.0-W4.0-P1.27-LS6.2-BL |  | NCE4435 | NCE(无锡新洁能) | C95275 | LCSC |  | 0
55 | 4 | AO4468 | Q7,Q8,Q9,Q10 | SOP-8_L4.9-W3.9-P1.27-LS6.0-BL |  | AO4468 | AOS | C87410 | LCSC |  | 9
56 | 1 | AO3404 | Q11 | SOT-23-3_L2.9-W1.3-P1.90-LS2.4-BR |  | AO3404 | Hottech(合科泰) | C192925 | LCSC |  | 47550
57 | 24 | 10kΩ | R1,R11,R12,R21,R32,R36,R40,R41,R46,R48,R58,R59,R66,R68,R69,R70,R71,R78,R79,R83,R84,R88,R89,R105 | R0805 | 10kΩ | RC0805FR-0710KL | YAGEO(国巨) | C84376 | LCSC |  | 1344084
58 | 14 | 200Ω | R2,R17,R18,R19,R30,R31,R33,R34,R35,R42,R51,R52,R56,R57 | R0805 | 200Ω | FRC0805J201 TS | FOJAN(富捷) | C2933534 | LCSC |  | 1384271
59 | 4 | 3.3kΩ | R3,R4,R5,R6 | R0805 | 3.3kΩ | RC0805FR-073K3L | YAGEO(国巨) | C114531 | LCSC |  | 130122
60 | 5 | 0Ω | R9,R10,R15,R16,R20 | R0805 | 0Ω | RC0805JR-070RL | YAGEO(国巨) | C96345 | LCSC |  | 1055619
61 | 4 | 22Ω | R22,R37,R38,R39 | R0603 | 22Ω | RC0603FR-0722RL | YAGEO(国巨) | C107701 | LCSC |  | 530426
62 | 1 | 10kΩ | R24 | R0805 | 10kΩ | 0805W8F1002T5E | UNI-ROYAL(厚声) | C17414 | LCSC |  | 15940364
63 | 5 | 4.7kΩ | R25,R49,R50,R60,R61 | R0805 | 4.7kΩ | RC0805FR-074K7L | YAGEO(国巨) | C60816 | LCSC |  | 615875
64 | 1 | NCP18XH103F03RB | R47 | R0603 |  | NCP18XH103F03RB | muRata(村田) | C13564 | LCSC |  | 398548
65 | 2 | 500Ω | R54,R55 | R0805 | 500Ω | ARG05FTC5000 | Viking(光颉) | C2828857 | LCSC |  | 53813
66 | 7 | 10Ω | R62,R63,R73,R74,R75,R110,R111 | R0805_NEW | 10Ω | 0805W8F100JT5E | UNI-ROYAL(厚声) | C17415 | LCSC |  | 3727121
67 | 2 | 4.99Ω | R64,R65 | R0805 | 4.99Ω | FRC0805F4R99TS | FOJAN(富捷) | C5121542 | LCSC |  | 49760
68 | 1 | 137kΩ | R67 | R0805 | 137kΩ | CR0805-FX-1373ELF | BOURNS | C203741 | LCSC |  | 22176
69 | 1 | 40.2kΩ | R72 | R0805 | 40.2kΩ | FRC0805F4022TS | FOJAN(富捷) | C2933438 | LCSC |  | 94859
70 | 1 | 10mΩ | R76 | R0805 | 10mΩ | ERJ6CWDR010V | PANASONIC(松下) | C236284 | LCSC |  | 8069
71 | 13 | 0Ω | R77,R80,R82,R85,R87,R90,R95,R96,R97,R98,R99,R107,R108 | R0805 | 0Ω | 0805W8F0000T5E | UNI-ROYAL(厚声) | C17477 | LCSC |  | 3654738
72 | 4 | 2mΩ | R92,R93,R94,R112 | R2512 | 2mΩ | JER2512F3R002 | JIERR(捷而瑞) | C46634447 | LCSC |  | 41006
73 | 5 | 1MΩ | R101,R102,R103,R104,R109 | R0805 | 1MΩ | RC0805FR-071ML | YAGEO(国巨) | C107700 | LCSC |  | 196167
74 | 1 | 1kΩ | R106 | R0805 | 1kΩ | RC0805FR-071KL | YAGEO(国巨) | C95781 | LCSC |  | 1328678
75 | 24 | Screw-Hole-M3 | SCREW1,SCREW2,SCREW3,SCREW4,SCREW5,SCREW6,SCREW7,SCREW8,SCREW9,SCREW10,SCREW11,SCREW12,SCREW13,SCREW14,SCREW15,SCREW16,SCREW17,SCREW18,SCREW19,SCREW20,SCREW21,SCREW22,SCREW23,SCREW24 | Screw-Hole-M3 |  |  |  |  |  | 42.7115
76 | 4 | RESET | SW1,SW3,SW6,SW7 | KEY-SMD_4P-L5.2-W5.2-P3.70-LS6.4 |  | RESET | G-Switch(品赞) | C963236 | LCSC |  | 31078
77 | 1 | KEY1 | SW2 | KEY-SMD_4P-L5.2-W5.2-P3.70-LS6.4 |  | KEY1 | G-Switch(品赞) | C963236 | LCSC |  | 31078
78 | 1 | D2F-01L | SW4 | SW-TH_D2F-01L |  | D2F-01L | OMRON(欧姆龙) | C231335 | LCSC |  | 5
79 | 1 | Test-Point | TP1 | Test-Point-0.5mm |  |  |  |  |  | 42.7115
80 | 1 | STM32F401CCU6 | U1 | UFQFPN-48_L7.0-W7.0-P0.50-BL-EP |  | STM32F401CCU6 | ST(意法半导体) | C79861 | LCSC |  | 942
81 | 4 | 16MHz | U2,U15,U34,U70 | CRYSTAL-SMD_4P-L3.2-W2.5-BL | 16MHz | S3216000081080B5 | JGHC(晶光华) | C5380505 | LCSC |  | 2273
82 | 2 | W25Q128JVSIQ | U3,U17 | SOIC-8_L5.3-W5.3-P1.27-LS8.0-BL |  | W25Q128JVSIQ | WINBOND(华邦) | C97521 | LCSC |  | 199038
83 | 1 | CAT24C256WI-GT3 | U4 | SOIC-8_L4.9-W3.9-P1.27-LS6.0-BL |  | CAT24C256WI-GT3 | onsemi(安森美) | C79987 | LCSC |  | 35880
84 | 1 | PCF8563T/5,518 | U5 | SOIC-8_L5.0-W4.0-P1.27-LS6.0-BL |  | PCF8563T/5,518 | NXP(恩智浦) | C7440 | LCSC |  | 118420
85 | 1 | 15pF | U6 | C0805 | 15pF | HGC0805G0150J500NTGJ | Chinocera(华瓷) | C5186731 | LCSC |  | 9586
86 | 1 | SN74LVC125APWR | U7 | TSSOP-14_L5.0-W4.4-P0.65-LS6.4-BL |  | SN74LVC125APWR | TI(德州仪器) | C7813 | LCSC |  | 25518
87 | 2 | APX809S-29SA-7 | U9,U18 | SOT-23-3_L2.9-W1.3-P1.90-LS2.4-BR |  | APX809S-29SA-7 | DIODES(美台) | C460664 | LCSC |  | 1359
88 | 6 | LP5907MFX-3.3/NOPB | U10,U12,U27,U28,U33,U87 | SOT-23-5_L3.0-W1.7-P0.95-LS2.8-BR |  | LP5907MFX-3.3/NOPB | TI(德州仪器) | C80670 | LCSC |  | 5786
89 | 2 | STM32F103C8T6 | U13,U69 | LQFP-48_L7.0-W7.0-P0.50-LS9.0-BL |  | STM32F103C8T6 | ST(意法半导体) | C8734 | LCSC |  | 178249
90 | 1 | E22-400M22S | U16 | WIRELM-SMD_E22-400M22S |  | E22-400M22S | EBYTE(亿佰特) | C411291 | LCSC |  | 825
91 | 1 | ADXL345BCCZ-RL | U19 | LGA-14_L5.0-W3.0-P0.80-BL-1 |  | ADXL345BCCZ-RL | ADI(亚德诺) | C579457 | LCSC |  | 734
92 | 1 | DS18B20 | U20 | TO-92-3_L4.9-W3.7-P1.27-L |  | DS18B20 | MSKSEMI(美森科) | C5379069 | LCSC |  | 17210
93 | 1 | MPU-6050 | U21 | QFN-24_L4.0-W4.0-P0.50-BL-EP2.7 |  | MPU-6050 | TDK InvenSense(应美盛) | C24112 | LCSC |  | 13841
94 | 1 | MLX90393ELW-ABA-011-RE | U22 | QFN-16_L3.0-W3.0-P0.50-TR-EP1.7 |  | MLX90393ELW-ABA-011-RE | Melexis(比利时迈来芯) | C2654971 | LCSC |  | 759
95 | 3 | ADS1015IDGSR | U25,U26,U94 | VSSOP-10_L3.0-W3.0-P0.50-LS4.9-BL |  | ADS1015IDGSR | TI(德州仪器) | C193969 | LCSC |  | 0
96 | 1 | ATGM336H-5N31 | U29 | GPSM-SMD_ATGM336H-TR |  | ATGM336H-5N31 | 杭州中科微 | C90770 | LCSC |  | 5249
97 | 1 | TPAP2112K-3.0TRG1 | U30 | SOT-23-5_L2.9-W1.6-P0.95-LS2.8-BR |  | TPAP2112K-3.0TRG1 | TECH PUBLIC(台舟) | C23380903 | LCSC |  | 5470
98 | 1 | AT2659 | U31 | DFN-6_L1.6-W1.0-P0.55-BL |  | AT2659 | 杭州中科微 | C92450 | LCSC |  | 239
99 | 1 | STM32F407VGT6 | U32 | LQFP-100_L14.0-W14.0-P0.50-LS16.0-BL |  | STM32F407VGT6 | ST(意法半导体) | C12345 | LCSC |  | 4378
100 | 1 | ZX-IDC2.54-2-8PWZ | U36 | IDC-TH_16P-P2.54_300R-16P |  | ZX-IDC2.54-2-8PWZ | Megastar(兆星) | C7501252 | LCSC |  | 1312
101 | 1 | OV7670-SYMBOL | U38 | 0v7670-camera |  |  |  |  |  | 42.7115
102 | 1 | STWD100YNYWY3F | U40 | SOT-23-5_L3.0-W1.7-P0.95-LS2.8-BR |  | STWD100YNYWY3F | ST(意法半导体) | C155551 | LCSC |  | 860
103 | 19 | mouse-bite | U41,U42,U43,U44,U45,U47,U48,U49,U50,U51,U52,U53,U54,U55,U56,U57,U58,U59,U60 | mouse-bite |  |  |  |  |  | 42.7115
104 | 1 | Inhibit switch 1 connection | U61 | HDR-TH_2P-P2.54-V-M-3 |  | Inhibit switch 1 connection | hanxia(韩下) | C32713268 | LCSC |  | 71313
105 | 1 | DC EN | U62 | HDR-TH_2P-P2.54-V-M-3 |  | DC EN | hanxia(韩下) | C32713268 | LCSC |  | 71313
106 | 1 | LM2596SX-5.0/NOPB | U64 | TO-263-5_L10.2-W8.9-P1.70-TL |  | LM2596SX-5.0/NOPB | TI(德州仪器) | C10002 | LCSC |  | 10134
107 | 1 | 220uF | U65 | CAP-SMD_BD6.3-L6.6-W6.6-FD | 220uF | VT220UF25V167RV160 | KNSCHA(科尼盛) | C5250961 | LCSC |  | 5236
108 | 1 | AMS1117-3.3 | U66 | SOT-223-3_L6.5-W3.4-P2.30-LS7.0-BR |  | AMS1117-3.3 | AMS | C6186 | LCSC |  | 1305634
109 | 1 | BATT EN | U67 | HDR-TH_2P-P2.54-V-M-3 |  | BATT EN | hanxia(韩下) | C32713268 | LCSC |  | 71313
110 | 1 | BQ25703ARSNR | U68 | VQFN-32_L4.0-W4.0-P0.40-TL-EP |  | BQ25703ARSNR | TI(德州仪器) | C188229 | LCSC |  | 5338
111 | 2 | TP-黄色测试点 | U71,U72 | TESTPOINT-TH_BD1.0 |  | TP-黄色测试点 |  | C9900007422 | LCSC |  | 0
112 | 1 | 10mΩ | U73 | R1206 | 10mΩ | FRM121WFR010TM | FOJAN(富捷) | C7467248 | LCSC |  | 379418
113 | 1 | 2.2uH | U74 | IND-SMD_L7.0-W6.6_MCW-0650-220 | 2.2uH | APH0630T2R2M | APV(爱普微) | C5349701 | LCSC |  | 29270
114 | 1 | BATTERY CONNECTOR | U75 | CONN-TH_XY308-2.54-2P |  | BATTERY CONNECTOR | XINLAIYA(新莱亚) | C557685 | LCSC |  | 4864
115 | 3 | INA226AIDGSR | U76,U77,U78 | MSOP-10_L3.0-W3.0-P0.50-LS5.0-BL |  | INA226AIDGSR | TI(德州仪器) | C49851 | LCSC |  | 6046
116 | 3 | TPS22810DBVR | U81,U82,U83 | SOT-23-6_L2.9-W1.6-P0.95-LS2.8-BL |  | TPS22810DBVR | TI(德州仪器) | C205990 | LCSC |  | 2841
117 | 1 | 74AUP1G08SE-7 | U84 | SOT-353_L2.0-W1.2-P0.65-LS2.1-BL |  | 74AUP1G08SE-7 | DIODES(美台) | C526331 | LCSC |  | 1185
118 | 1 | 3V3_TP | U85 | TEST-TH_BD2.54-P1.4_RED |  | 3V3_TP | 荣和 | C5277086 | LCSC |  | 167168
119 | 1 | 5V_TP | U86 | TEST-TH_BD2.54-P1.4_RED |  | 5V_TP | 荣和 | C5277086 | LCSC |  | 167168
120 | 1 | 12V_JACK__TP | U88 | TEST-TH_BD2.54-P1.4_RED |  | 12V_JACK__TP | 荣和 | C5277086 | LCSC |  | 167168
121 | 1 | 5V_EPS_TP | U89 | TEST-TH_BD2.54-P1.4_RED |  | 5V_EPS_TP | 荣和 | C5277086 | LCSC |  | 167168
122 | 1 | 3V3_EPS_TP | U90 | TEST-TH_BD2.54-P1.4_RED |  | 3V3_EPS_TP | 荣和 | C5277086 | LCSC |  | 167168
123 | 1 | 7.4V_BATT_TP | U91 | TEST-TH_BD2.54-P1.4_RED |  | 7.4V_BATT_TP | 荣和 | C5277086 | LCSC |  | 167168
124 | 1 | TPS60150DRVR | U92 | QFN-6_L2.0-W2.0-P0.65-TL-EP |  | TPS60150DRVR | TI(德州仪器) | C182429 | LCSC |  | 7075
125 | 1 | INA219AIDR | U93 | SOIC-8_L4.9-W3.9-P1.27-LS6.0-BL |  | INA219AIDR | TI(德州仪器) | C138706 | LCSC |  | 4885
126 | 1 | 6GHz | U95 | IPEX-SMD_BWIPX-1-001E | 6GHz | BWU.FL-IPEX1 | BAT WIRELESS(蝙蝠无线) | C5137195 | LCSC |  | 152918
127 | 2 | USER_LED_GREEN | ULED1,ULED2 | LED0805-R-RD |  | USER_LED_GREEN | TOGIALED(统佳) | C601703 | LCSC |  | 1773
128 | 1 | 32.768kHz | X1 | FC-135R_L3.2-W1.5 | 32.768kHz | Q13FC13500004 | EPSON(爱普生) | C32346 | LCSC |  | 570308
