bytecod3/Project-Shadow-Flight/ground-testing/test-jig/hardware/production-files/test_jig_bom.xlsx

No. | Quantity | Comment | Designator | Footprint | Value | Manufacturer Part | Manufacturer | Supplier Part | Supplier | LCSC Price | JLCPCB Stock
1 | 1 | 2.7kHz | BUZZER1 | BUZ-SMD_4P-L7.5-W7.5-P7.59-TL | 2.7kHz | MLT-7525 | 华能 | C95299 | LCSC |  | 46446
2 | 1 | 220uF | C9 | CAP-SMD_BD8.0-L8.3-W8.3-LS9.3-FD | 220uF | RVT220UF35V67RV0024 | KNSCHA(科尼盛) | C2836441 | LCSC |  | 26352
3 | 1 | 470uF | C10 | CAP-SMD_BD10.0-L10.3-W10.3-LS11.0-R-RD | 470uF | VZH471M1ETR-1010 | Lelon(立隆) | C249933 | LCSC |  | 28416
4 | 2 | 1uF | C11,C12 | C0805 | 1uF | CL21B105KBFNNNE | SAMSUNG(三星) | C28323 | LCSC |  | 1985316
5 | 1 | SS34A | D1 | SMA_L4.4-W2.6-LS5.1-RD |  | SS34A | Hottech(合科泰) | C2886580 | LCSC |  | 96381
6 | 1 | PSBD1DF40V2L | D2 | SOD-123FL_L2.8-W1.8-LS3.8-RD |  | PSBD1DF40V2L | TECH PUBLIC(台舟) | C23380879 | LCSC |  | 1199
7 | 1 | PTVS24VS1UTR,115 | D3 | SOD-123_L2.6-W1.7-LS3.5-RD |  | PTVS24VS1UTR,115 | Nexperia(安世) | C553399 | LCSC |  | 48
8 | 1 | HDGCPH254-PZ02-10 | H1 | HDR-TH_HDGCPH254-PZ02-10 |  | HDGCPH254-PZ02-10 | HDGC(华德共创) | C20607069 | LCSC |  | 57
9 | 1 | 68uH | L1 | IND-SMD_L11.5-W10.0_104CDMCCDS | 68uH | FXL1040-680-M | cjiang(长江微电) | C475920 | LCSC |  | 34567
10 | 8 | NCD0805G1 | LED1,LED2,LED3,LED4,LED5,LED6,LED7,LED8 | LED0805-R-RD |  | NCD0805G1 | 国星光电 | C84260 | LCSC |  | 683911
11 | 1 | 24V Supply | P1 | CONN-TH_2P-P5.00_WJ500V-5.08-2P |  | 24V Supply | KANGNEX(康奈克斯电气) | C8465 | LCSC |  | 143550
12 | 2 | AO3404 | Q1,Q2 | SOT-23-3_L2.9-W1.3-P1.90-LS2.4-BR |  | AO3404 | Hottech(合科泰) | C192925 | LCSC |  | 46876
13 | 1 | AMS1117-3.3V | Q3 | SOT-89-3_L4.5-W2.5-P1.50-LS4.2-BR |  | AMS1117-3.3V | MSKSEMI(美森科) | C5120796 | LCSC |  | 226618
14 | 8 | 1kΩ | R1,R2,R3,R4,R5,R6,R7,R8 | R0805 | 1kΩ | RC0805FR-071KL | YAGEO(国巨) | C95781 | LCSC |  | 999837
15 | 3 | 10kΩ | R10,R11,R12 | R0805 | 10kΩ | RC0805FR-0710KL | YAGEO(国巨) | C84376 | LCSC |  | 37497
16 | 2 | 200Ω | R14,R15 | R0805 | 200Ω | 0805W8F2000T5E | UNI-ROYAL(厚声) | C17540 | LCSC |  | 926534
17 | 3 | GPIO MUX | SW1,SW4,SW5 | SW-SMD_8P-L10.2-W6.2-P2.54-LS9.4 |  | GPIO MUX | SHOU HAN(首韩) | C6331176 | LCSC |  | 22114
18 | 1 | ON/OFF | SW2 | SW-TH_KCD11-BL |  | ON/OFF | hanxia(韩下) | C6917329 | LCSC |  | 3757
19 | 1 | 2.54-4P TPGT | SW3 | SW-SMD_8P-L10.2-W6.2-P2.54-LS9.4 |  | 2.54-4P TPGT | SHOU HAN(首韩) | C6331176 | LCSC |  | 22114
20 | 1 | MCP23017T-E/ML | U1 | QFN-28_L6.0-W6.0-P0.65-BL-EP3.7 |  | MCP23017T-E/ML | MICROCHIP(美国微芯) | C629439 | LCSC |  | 8637
21 | 18 | 2.54-3P | U3,U4,U5,U6,U7,U8,U9,U10,U12,U13,U14,U15,U16,U17,U18,U19,U21,U22 | CONN-TH_2.54-3P |  | 2.54-3P | BOOMELE(博穆精密) | C68305 | LCSC |  | 2807
22 | 1 | LM2596SX-5.0/NOPB | U11 | TO-263-5_L10.2-W8.9-P1.70-TL |  | LM2596SX-5.0/NOPB | TI(德州仪器) | C10002 | LCSC |  | 12632
23 | 1 | HDGCPH254-PZ02-05 | U20 | HDR-TH_10P-P2.54-V-M-R2-C5-S2.54 |  | HDGCPH254-PZ02-05 | HDGC(华德共创) | C20607068 | LCSC |  | 330
24 | 1 | 902-131A1011D10100 | USB1 | USB-A-TH__USB-AF-90 |  | 902-131A1011D10100 | 精拓金 | C2345 | LCSC |  | 33725
