bytecod3/Project-Shadow-Flight/references/structure/images/Installing a kill switch with additional parts #1.SLDASM

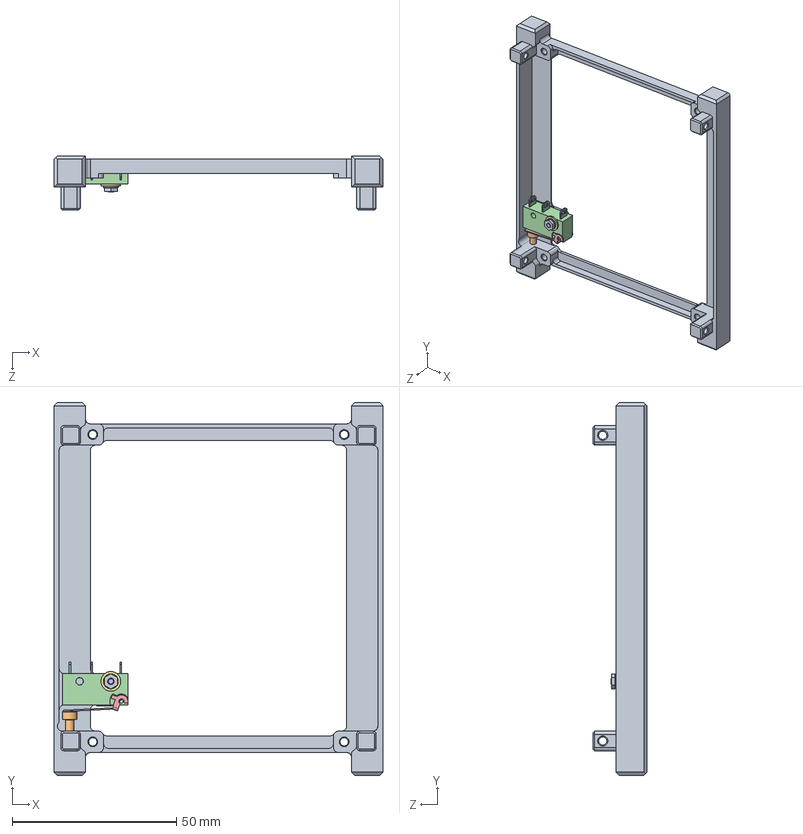
[picture p65: CAD file, 2025-08-25]
references/structure/images/Installing a kill switch with additional parts #1.SLDASM
100.0 x 113.5 x 16.5 mm
Structure frame (spring kill switch)
Pusher
Spring
Frame kill switch XCF3
Lever XCF3-J1Z1
countersunk flat head cross recess screw_din
plain washer 6902 type abc_din
spring lock washer 2_din
hex thin nut gradeb_din
socket head cap screw 4762_din
