bytecod3/Project-Shadow-Flight/structure/production-files-version-1/positive-x.stl

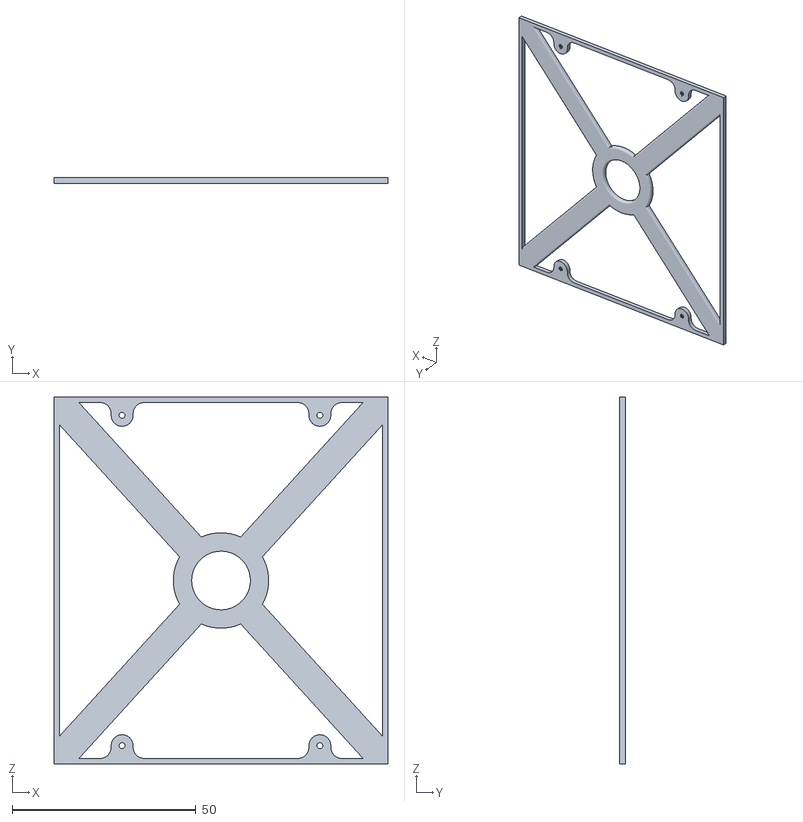
[picture p66: CAD file, 2026-01-05]
structure/production-files-version-1/positive-x.stl
91.0 x 1.50 x 100.0
