bytecod3/Project-Shadow-Flight/structure/shadow-flight-structure.FCStd

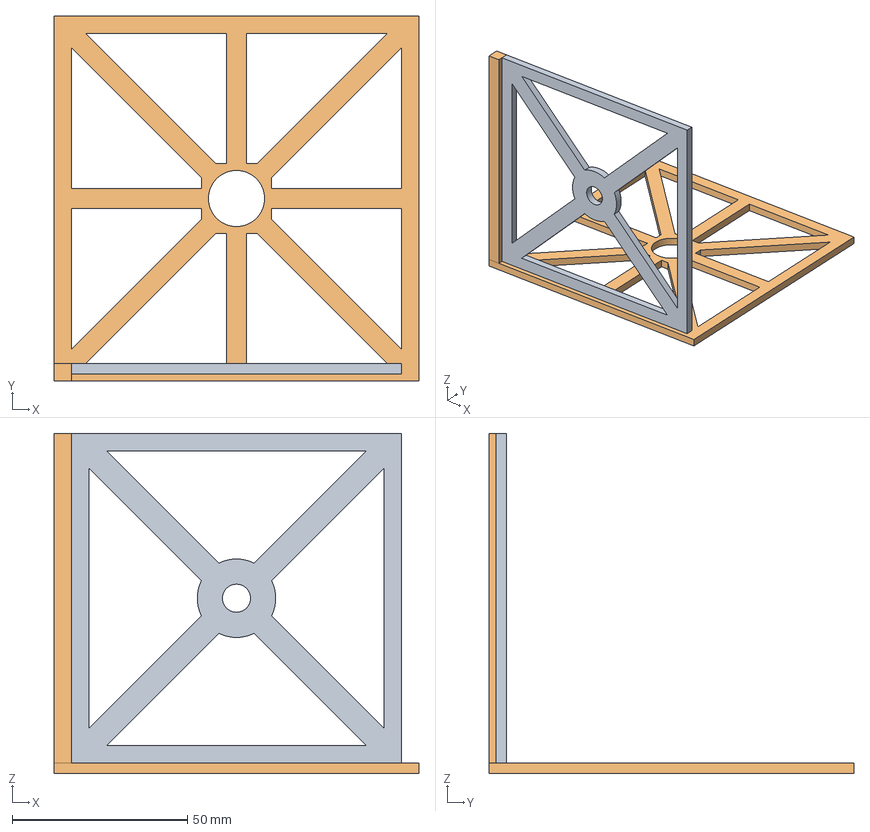
[picture p67: CAD file, 2026-01-01]
structure/shadow-flight-structure.FCStd
104.0 x 104.0 x 97.0 mm
front-side-cover
bottom-chassis
