bytecod3/Project-Shadow-Flight/structure/production-files-version-1/top-cover.stl

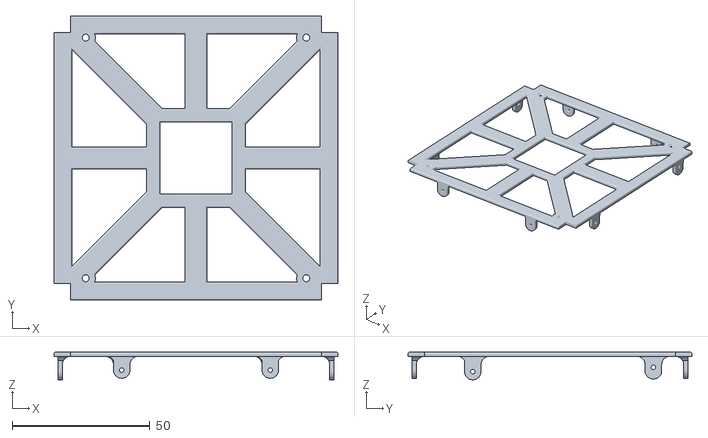
[picture p68: CAD file, 2026-01-05]
structure/production-files-version-1/top-cover.stl
103.0 x 103.0 x 10.0
