bytecod3/Project-Shadow-Flight/structure/production-files-version-1/negative-z.stl

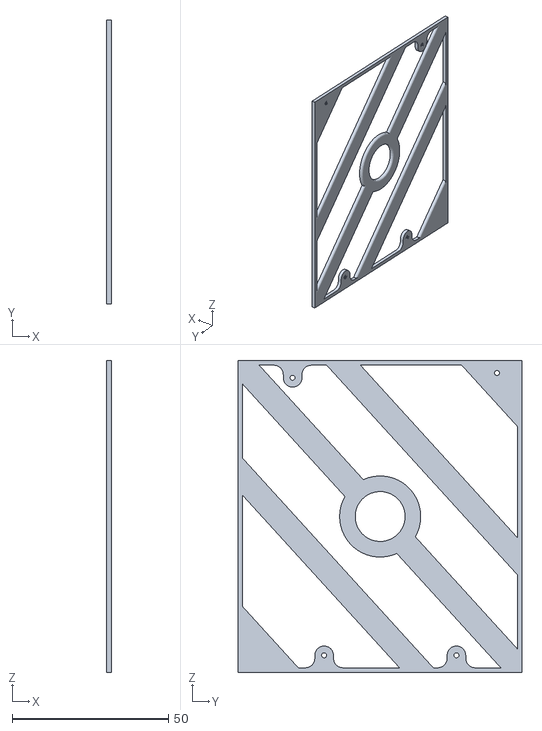
[picture p69: CAD file, 2026-01-05]
structure/production-files-version-1/negative-z.stl
1.50 x 91.0 x 100.0
