bytecod3/Project-Shadow-Flight/structure/production-files-version-1/bottom-chassis.stl

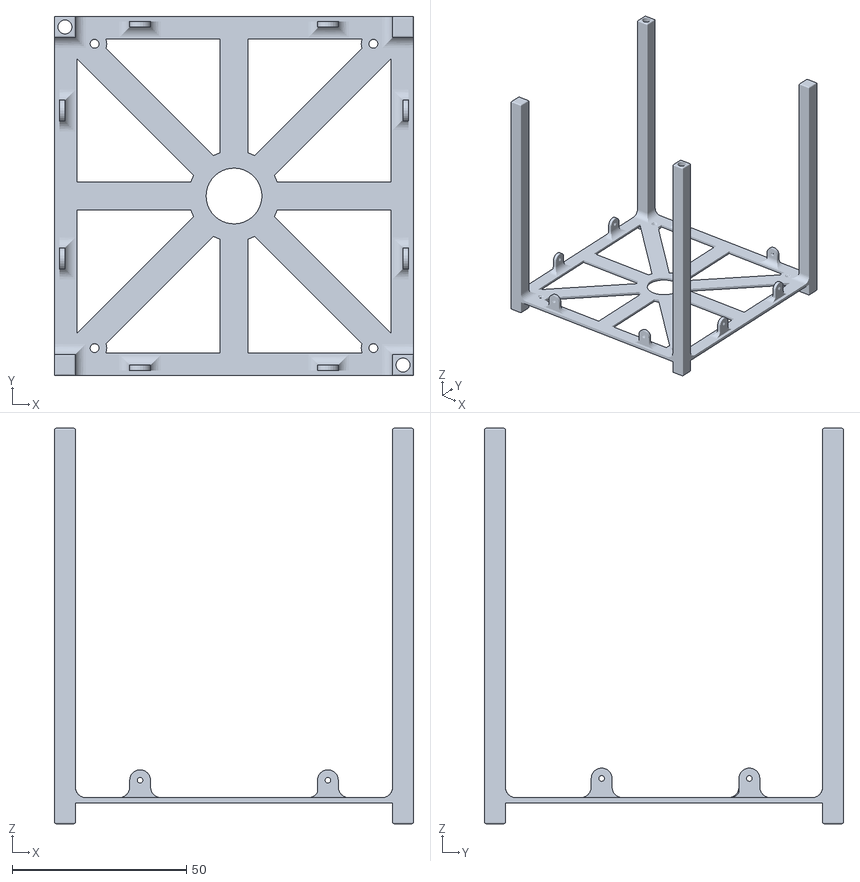
[picture p70: CAD file, 2026-01-05]
structure/production-files-version-1/bottom-chassis.stl
103.0 x 103.0 x 113.5
