bytecod3/Project-Shadow-Flight/(list of files, cad)

Other CAD files:
structure/production-files-version-1/positive-z.stl
structure/production-files-version-1/negative-x.stl
