bytecod3/Project-Shadow-Flight/ground-testing/test-jig/hardware/test-jig-assembly-1.png

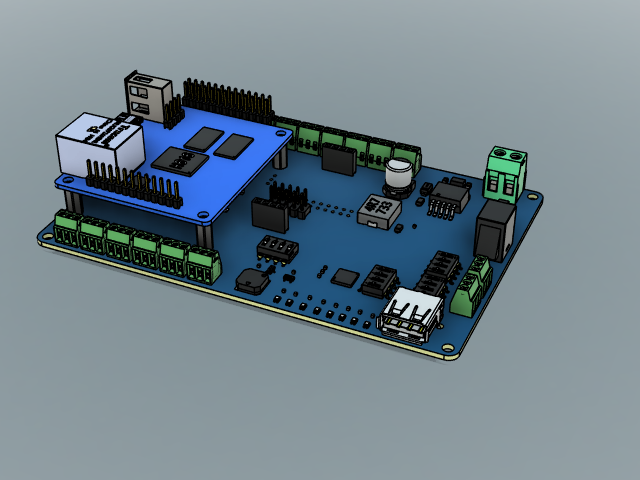
ground-testing/test-jig/hardware/test-jig-assembly-1.png
