bytecod3/Project-Shadow-Flight/structure/shadow-flight-assembly-teaser.png

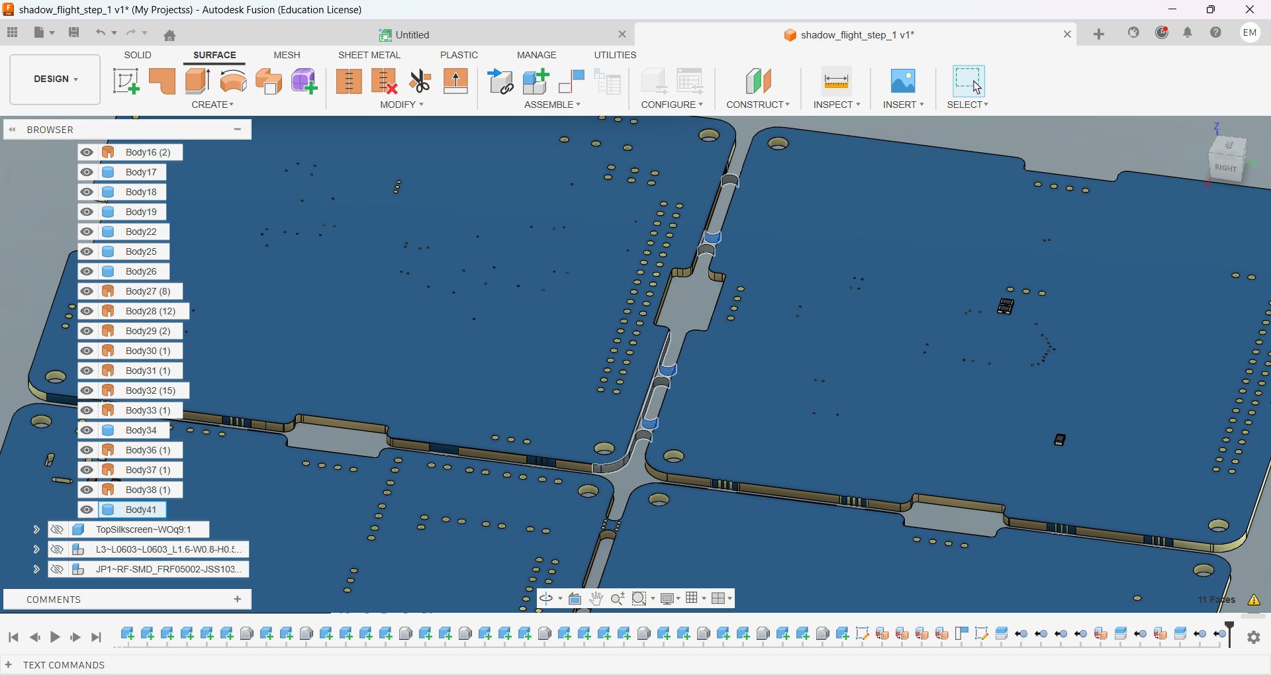
structure/shadow-flight-assembly-teaser.png
