bytecod3/Project-Shadow-Flight/ground-testing/flight_software_validator/command_list.txt

EPS RESTART
EPS MCU_RESET
COMMS RESTART 2026-01-26T14:45:00Z
EPS RESTART
EPS MCU_RESET
EPS ENTER_SAFE_MODE
EPS SET_POWER_LIMIT 8.0
EPS ENABLE_RAIL 5V
EPS DISABLE_RAIL 12V

OBC REBOOT
OBC WATCHDOG_RESET
OBC SET_MODE SAFE
OBC SET_MODE NOMINAL
OBC TIME_SYNC 2026-01-26T14:45:00Z

COMMS RESTART 2026-01-26T14:53:23Z
COMMS SET_BAUDRATE 9600
COMMS SET_MODE BEACON
COMMS SET_MODE PACKET
COMMS ANT_DEPLOY
COMMS TX_TEST
COMMS RX_TEST

ADCU INIT
ADCU CALIBRATE_GYRO
ADCU CALIBRATE_MAG
ADCU SET_MODE DETUMBLE
ADCU SET_MODE SUN_POINTING 2026-01-26T15:02:10Z
ADCU SET_MODE NADIR_POINTING

PAYLOAD POWER_ON
PAYLOAD POWER_OFF
PAYLOAD RESET
PAYLOAD SET_MODE IDLE
PAYLOAD SET_MODE ACQUIRE 2026-01-26T15:10:45Z
PAYLOAD DATA_DUMP

SYS STATUS_REQUEST
SYS HEARTBEAT
SYS TIME_BROADCAST 2026-01-26T15:20:00Z
