bytecod3/Project-Shadow-Flight/ground-testing/orange-pi-3/README.md

## Setting up headless connection on Orange Pi

## Setting
