bytecod3/Project-Shadow-Flight/ground-testing/test-jig/hardware/psf-test-jig-pinout.png

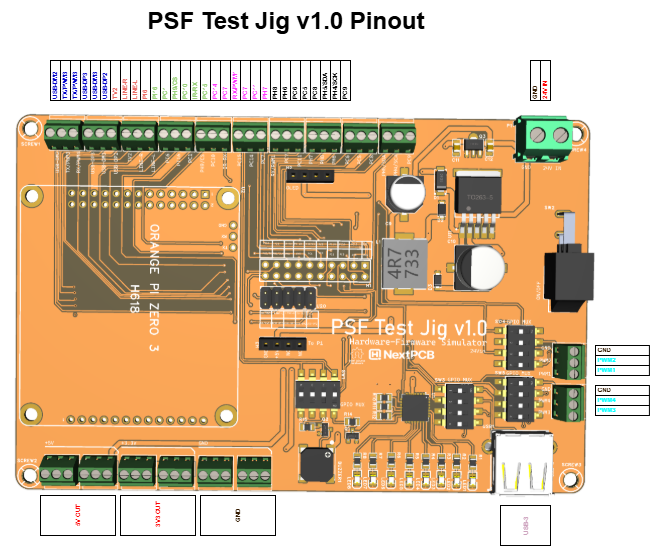
ground-testing/test-jig/hardware/psf-test-jig-pinout.png
