bytecod3/Project-Shadow-Flight/ground-testing/test-jig/hardware/test-jig-3d-flat.png

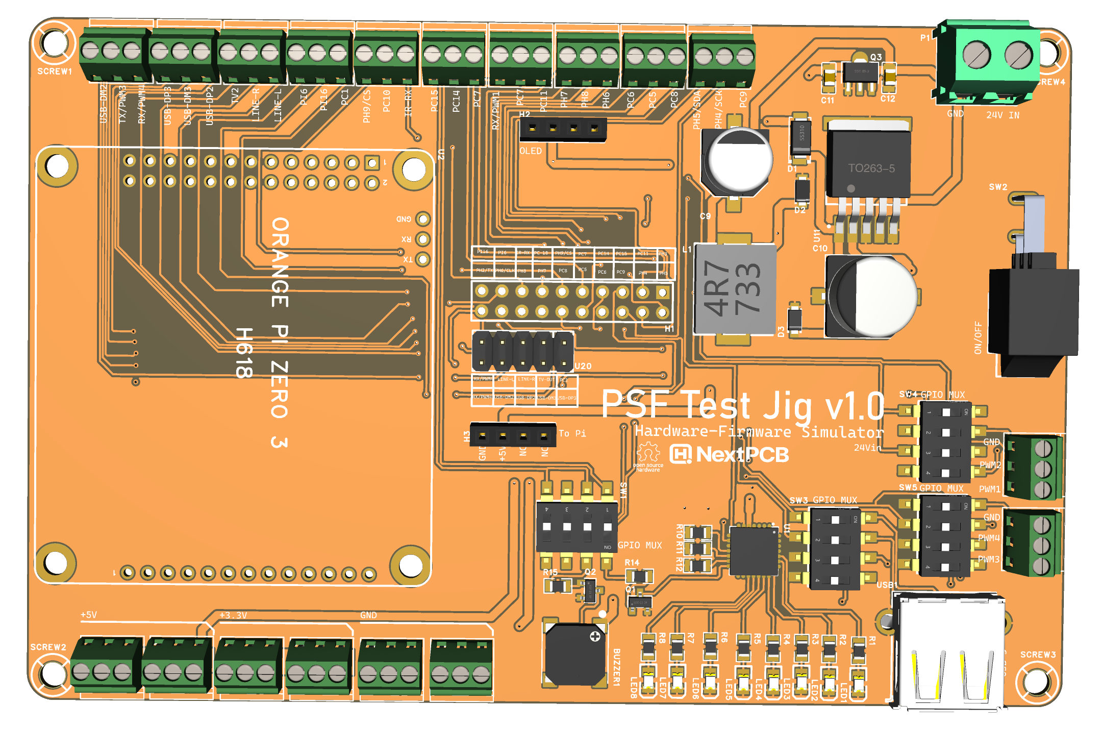
ground-testing/test-jig/hardware/test-jig-3d-flat.png
