bytecod3/Project-Shadow-Flight/ground-testing/test-jig/hardware/test-jig-pcb3d-image.png

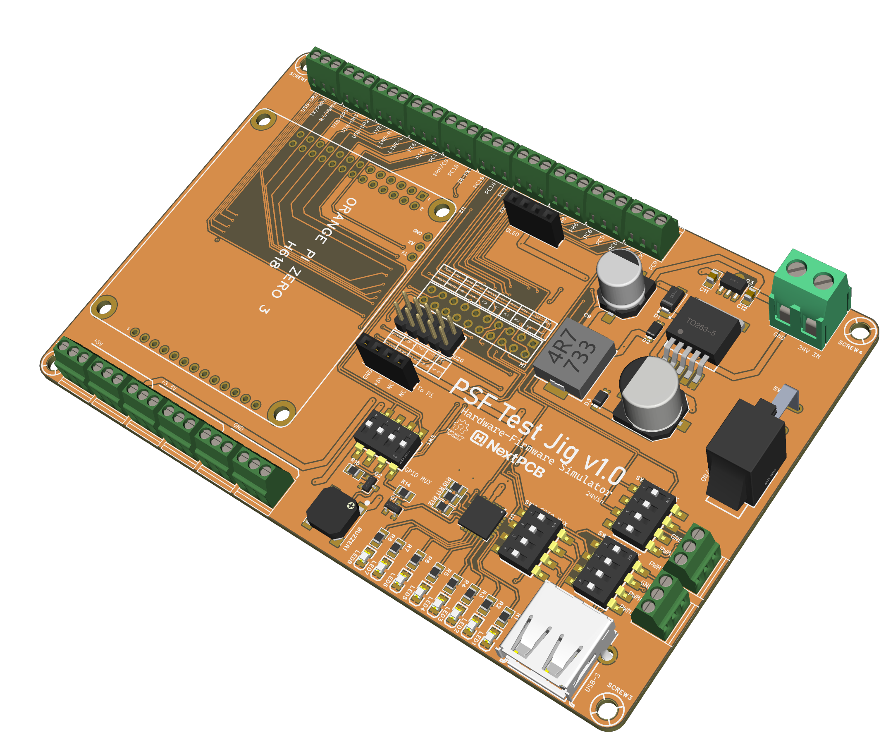
ground-testing/test-jig/hardware/test-jig-pcb3d-image.png
