bytecod3/Project-Shadow-Flight/ground-testing/test-jig/hardware/test-jig-schematic-v1.0.pdf

# GND 4 SH¹ SH²

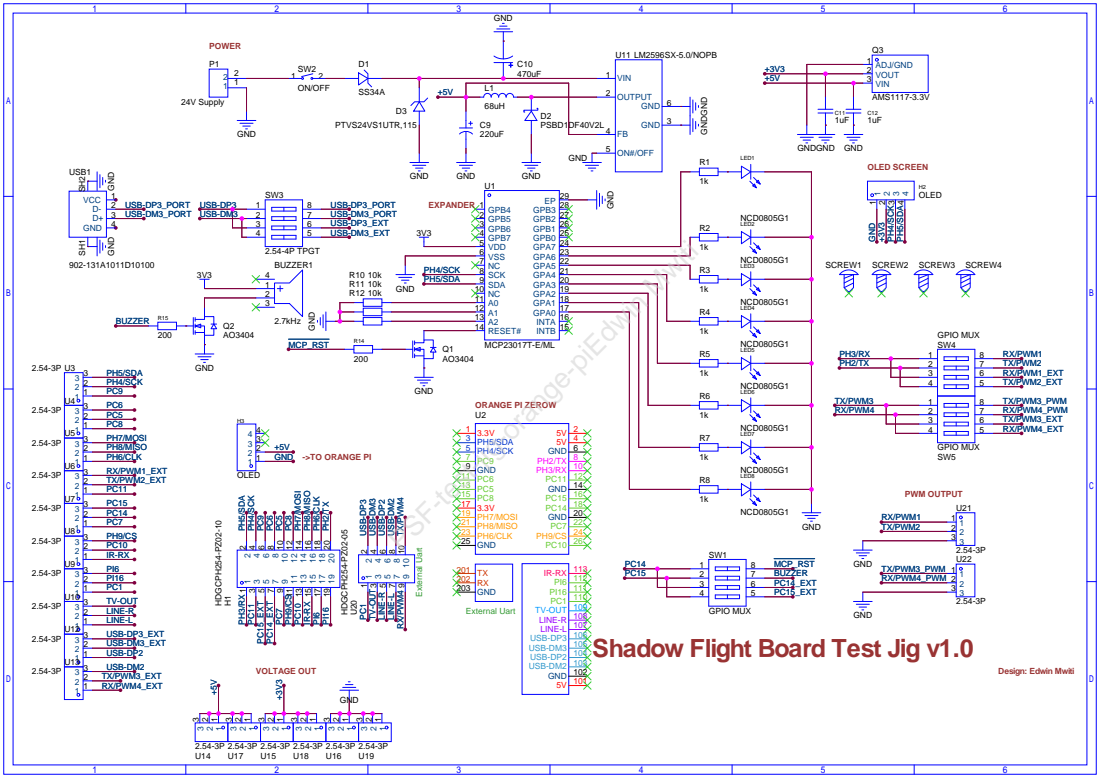
[picture p76: page 1]

SCK 8
INTB 15 RESET# 14 A2 13 A1 12 A0 11 NC 10 SDA 9
