bytecod3/Project-Shadow-Flight/documentation/SCH_CombinedSchematiC_2026-01-01.pdf

## MCU POWER

# GNDGND

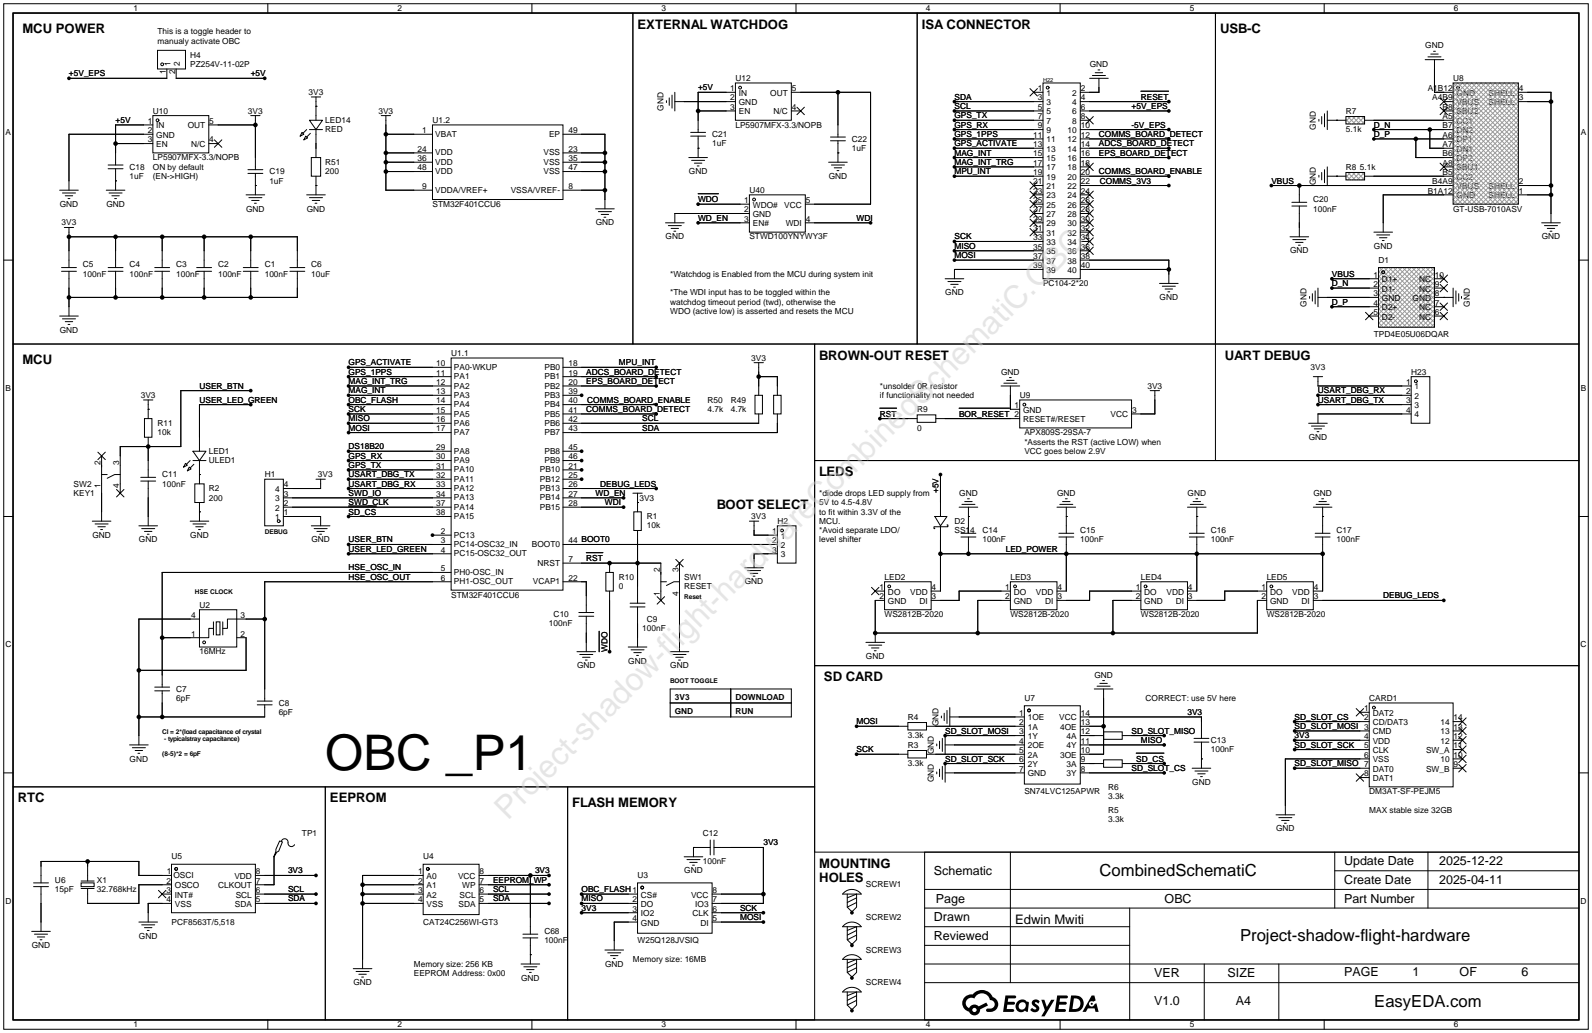
[picture p77: page 1]

This is a toggle header to
manualy activate OBC

VBAT 1
VSS 23 VDD 24
VSS 35 VDD 36
VSS 47 VDD 48
VSSA/VREF- 8 VDDA/VREF+ 9
STM32F401CCU6
CORRECT: use 5V here Project-shadow⁻flight-hardwareCombinedSchematiC.OBC

*Watchdog is Enabled from the MCU during system init
*The WDI input has to be toggled within the
watchdog timeout period (twd), otherwise the
WDO (active low) is asserted and resets the MCU

*unsolder 0R resistor
if functionality not needed

APX809S-29SA-7
*Asserts the RST (active LOW) when
VCC goes below 2.9V

*diode drops LED supply from
to fit within 3.3V of the
MCU.
*Avoid separate LDO/
level shifter

3V3 | DOWNLOAD
GND | RUN

Cl = 2*(load capacitance of crystal
- typicalstray capacitance)
GND

Project-shadow-flight-hardware

## INERTIAL MEASUREMENT UNIT MAGNETOMETER

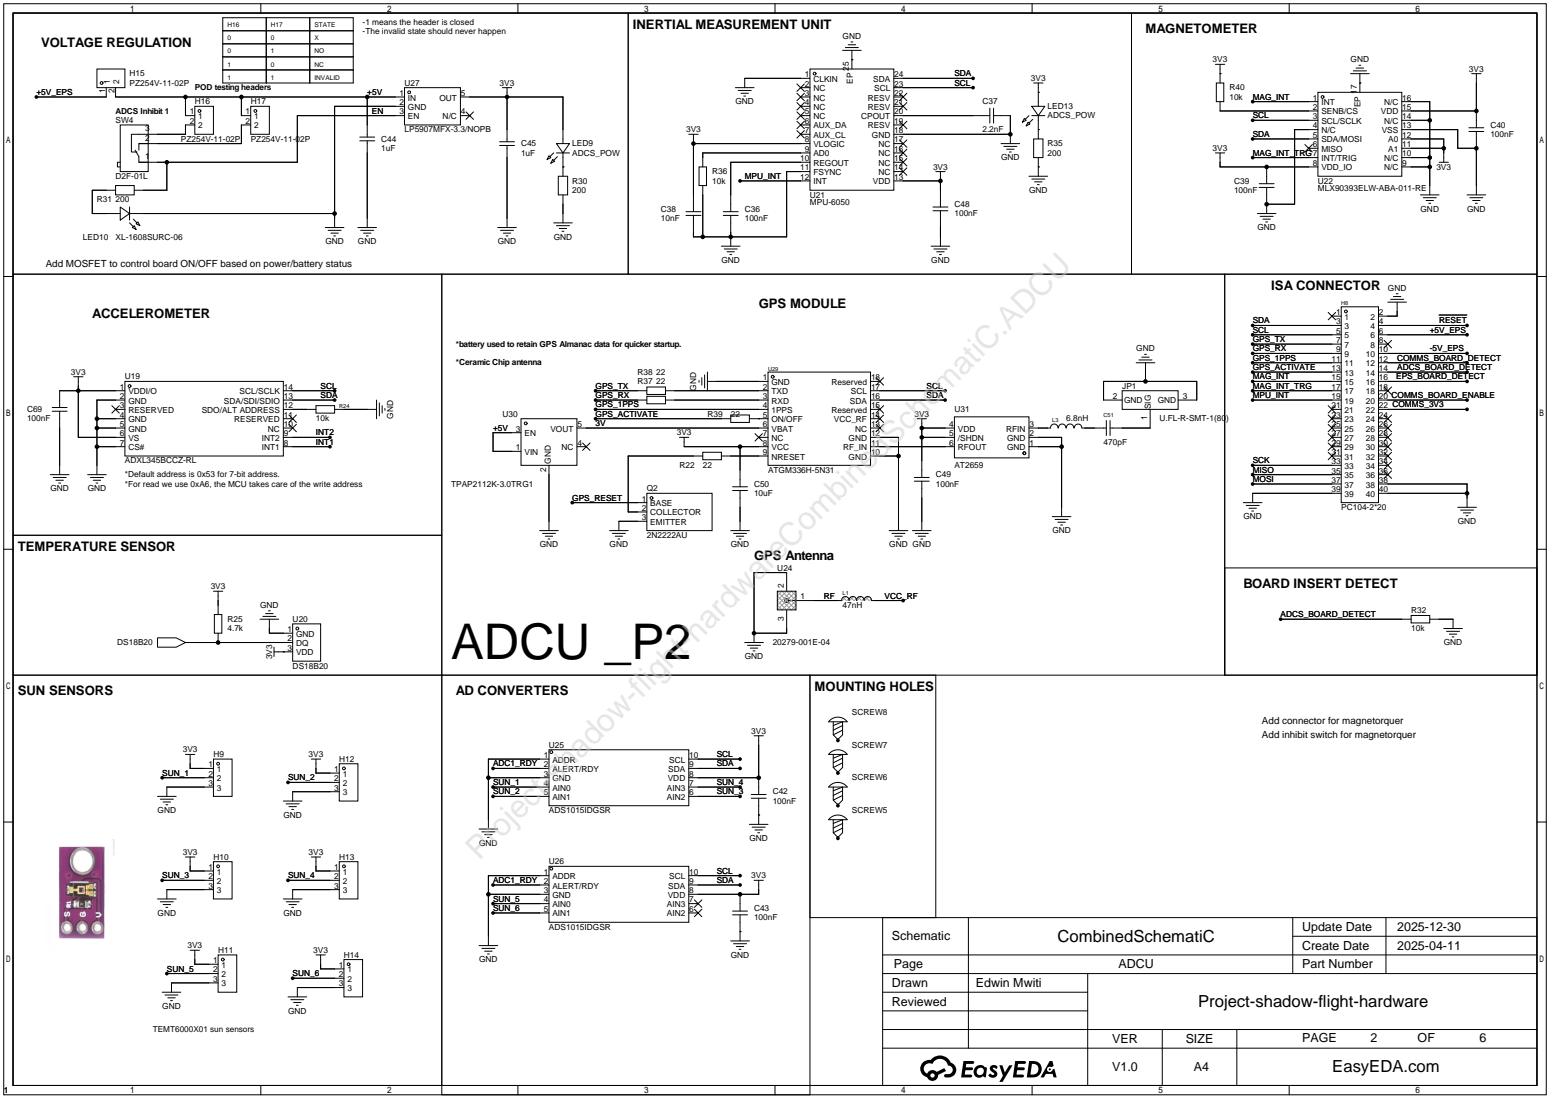
[picture p78: page 2]

H16 | H17 | STATE
0 | 1 | NO
1 | 0 | NC
1 | 1 | INVALID

-1 means the header is closed
-The invalid state should never happen

Project-shadow-flight-hardwareCombinedSchematiC.ADCU

Add MOSFET to control board ON/OFF based on power/battery status

*battery used to retain GPS Almanac data for quicker startup.
*Ceramic Chip antenna

VDDI/O 1
GND 2
RESERVED 3
GND 4
GND 5
ADXL345BCCZ-RL
*Default address is 0x53 for 7-bit address.
*For read we use 0xA6, the MCU takes care of the write address

Add connector for magnetorquer
Add inhibit switch for magnetorquer

Project-shadow-flight-hardware

## 16MB FLASH MEMORY

## VOLTAGE REGULATION

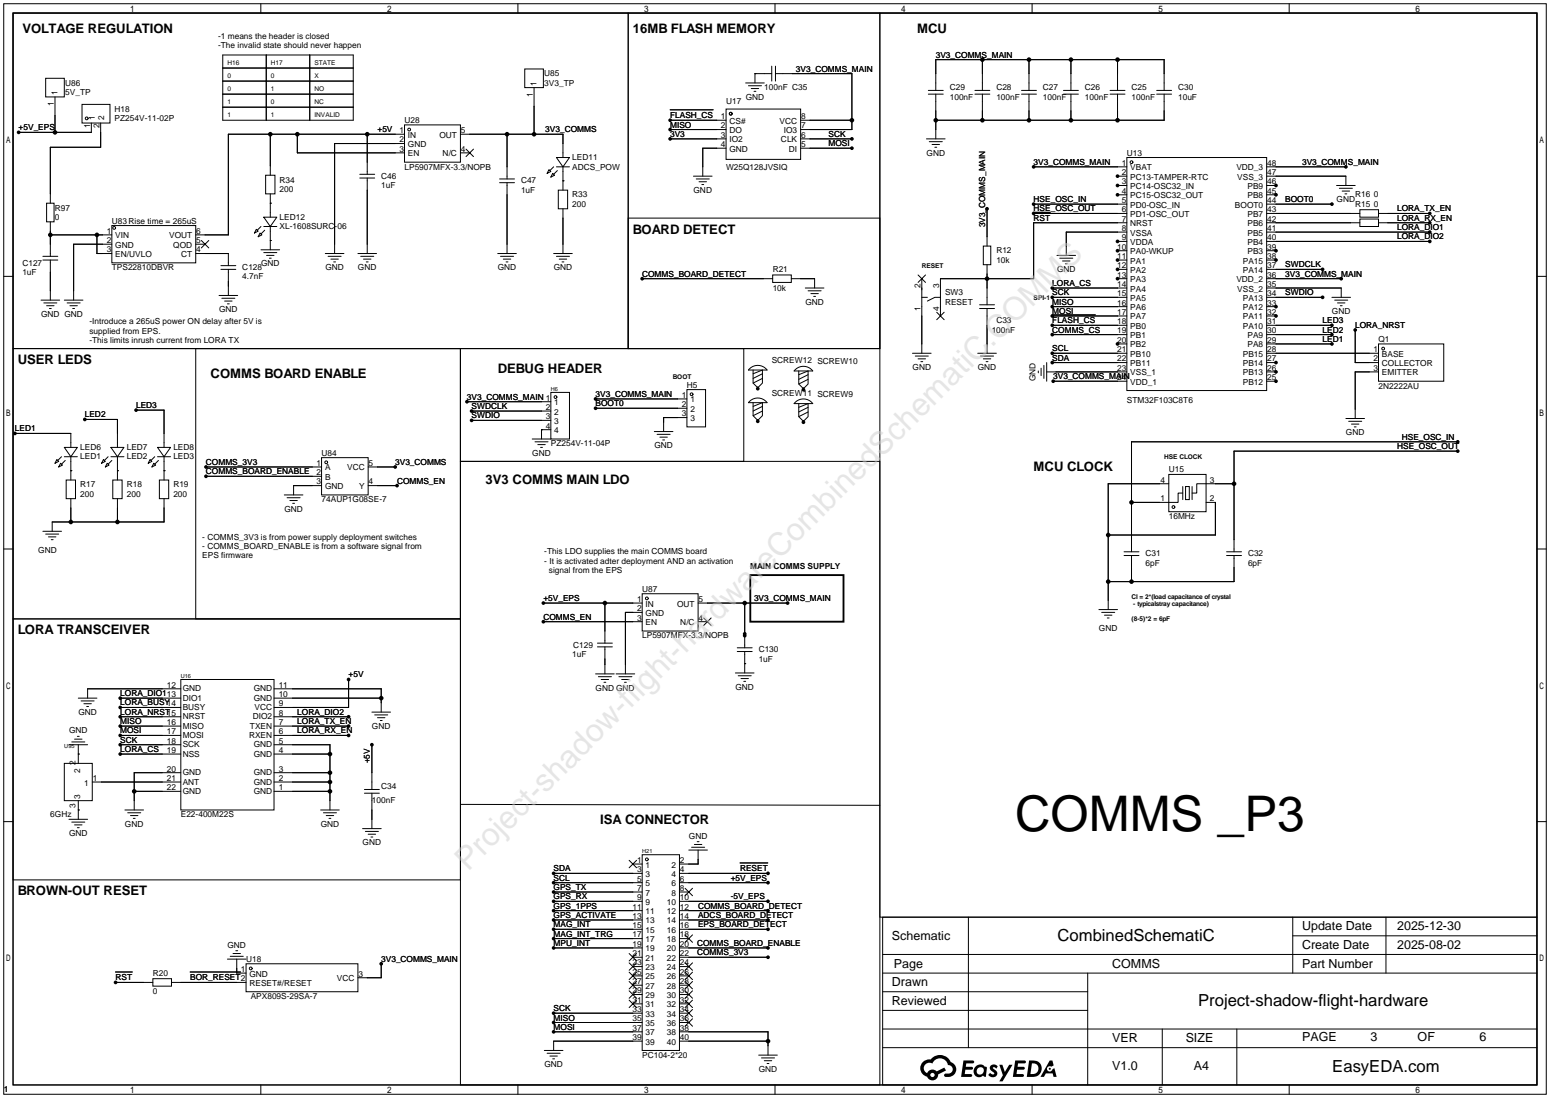
[picture p79: page 3]

-1 means the header is closed
-The invalid state should never happen

H16 | H17 | STATE
0 | 1 | NO
1 | 0 | NC
1 | 1 | INVALID

-Introduce a 265uS power ON delay after 5V is
supplied from EPS.
-This limits inrush current from LORA TX

DEBUG HEADER USER LEDS

- COMMS_3V3 is from power supply deployment switches
- COMMS_BOARD_ENABLE is from a software signal from
EPS firmware

-This LDO supplies the main COMMS board
- It is activated adter deployment AND an activation

Cl = 2*(load capacitance of crystal
- typicalstray capacitance)
GND

Project-shadow-flight-hardware

## CAMERA MODULE POWER SUPPLY

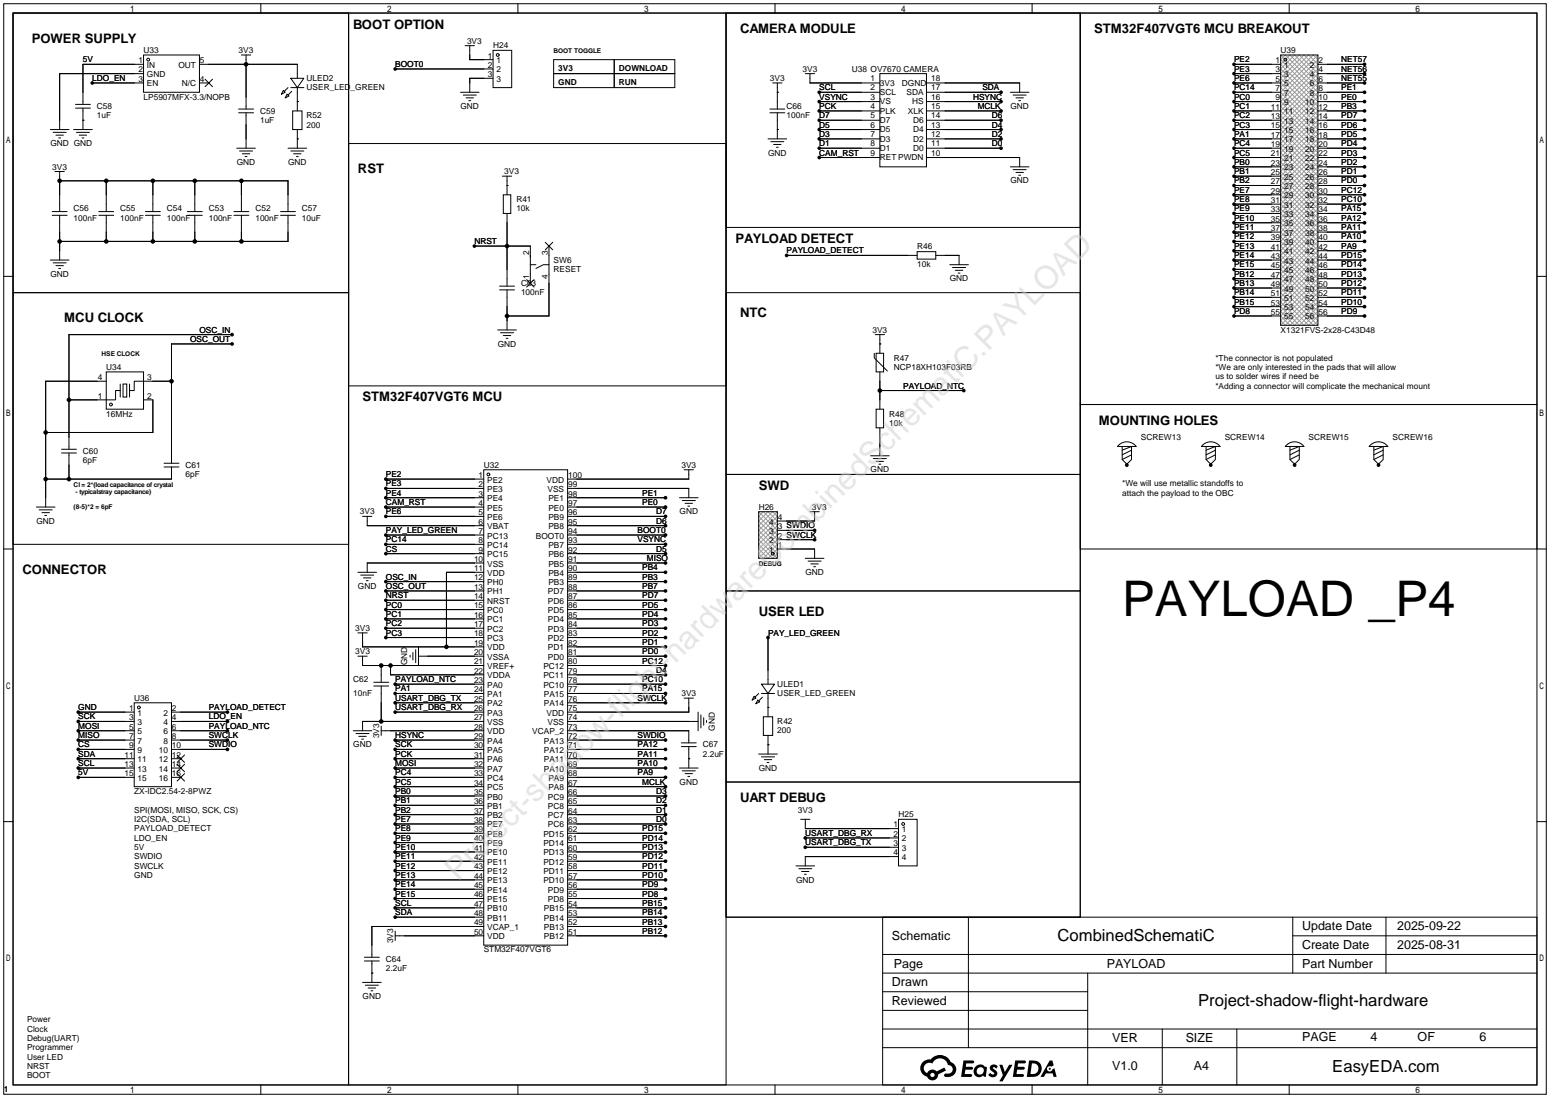
[picture p80: page 4]

3V3 | DOWNLOAD
GND | RUN

PWDN 10 D0 11 D2 12 D4 13 D6 14 XLK 15 HS 16 SDA 17 DGND 18

Project-shadow-flight-hardwareCombinedSchematiC.PAYLOAD

*The connector is not populated
*We are only interested in the pads that will allow
us to solder wires if need be
*Adding a connector will complicate the mechanical mount

Cl = 2*(load capacitance of crystal
- typicalstray capacitance)

*We will use metallic standoffs to
attach the payload to the OBC
PAYLOAD _P4

Project-shadow-flight-hardware

## EPS MCU LOAD SWITCHES

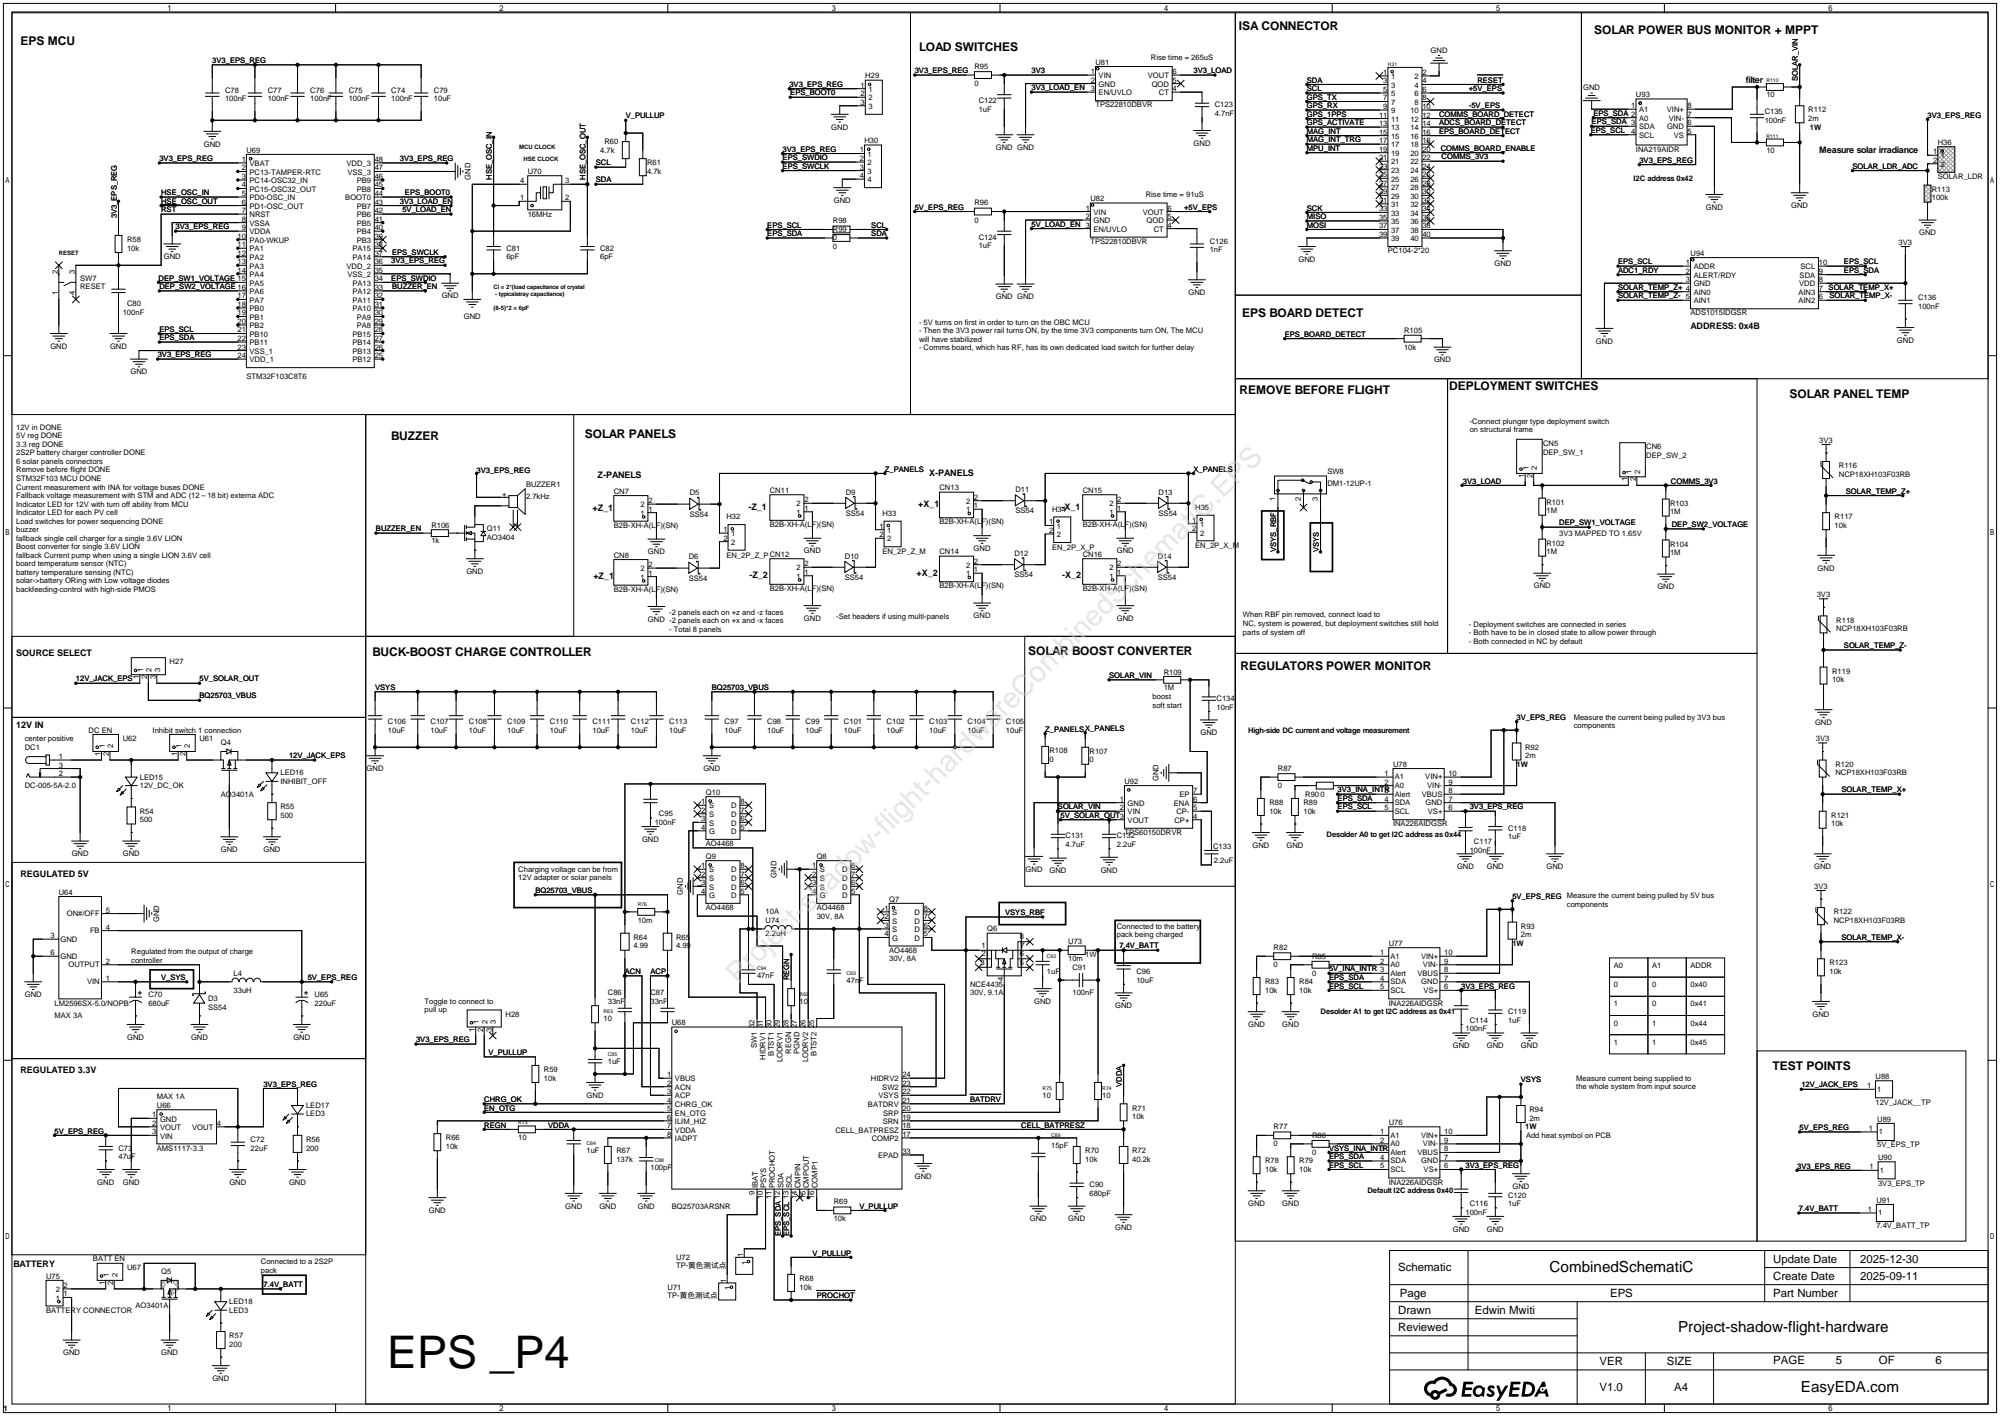
[picture p81: page 5]

SOLAR POWER BUS MONITOR + MPPT

Cl = 2*(load capacitance of crystal
- typicalstray capacitance)
GND

- 5V turns on first in order to turn on the OBC MCU
- Then the 3V3 power rail turns ON, by the time 3V3 components turn ON, The MCU
will have stabilized
- Comms board, which has RF, has its own dedicated load switch for further delay

-Connect plunger type deployment switch
on structural frame

12V in DONE
5V reg DONE
3.3 reg DONE
2S2P battery charger controller DONE
6 solar panels connectors
Remove before flight DONE
STM32F103 MCU DONE
Current measurement with INA for voltage buses DONE

Project-shadow-flight-hardwareCombinedSchematiC.EPS

Fallback voltage measurement with STM and ADC (12 18 bit) externa ADC
Indicator LED for 12V with turn off ability from MCU
Indicator LED for each PV cell
Load switches for power sequencing DONE
buzzer
fallback single cell charger for a single 3.6V LION
Boost converter for single 3.6V LION

fallback Current pump when using a single LION 3.6V cell
board temperature sensor (NTC)
battery temperature sensing (NTC)
solar->battery ORing with Low voltage diodes
backfeeding-control with high-side PMOS

-2 panels each on +z and -z faces
-2 panels each on +x and -x faces
- Total 8 panels

When RBF pin removed, connect load to
NC, system is powered, but deployment switches still hold
parts of system off

-Set headers if using multi-panels

- Deployment switches are connected in series
- Both have to be in closed state to allow power through
- Both connected in NC by default

BUCK-BOOST CHARGE CONTROLLER

Measure the current being pulled by 3V3 bus
components

High-side DC current and voltage measurement

Desolder A0 to get I2C address as 0x44

Charging voltage can be from
12V adapter or solar panels
BQ25703_VBUS

Measure the current being pulled by 5V bus

Connected to the battery
pack being charged

Toggle to connect to
pull up

Desolder A1 to get I2C address as 0x41

COMP2 17 CELL_BATPRESZ 18 SRN 19 SRP 20 BATDRV 21 VSYS 22 SW2 23 HIDRV2 24

the whole system from input source

Project-shadow-flight-hardware

# U60 Project-shadow⁻flight-hardwareCombinedSchematiC.MOUSE⁻BITES

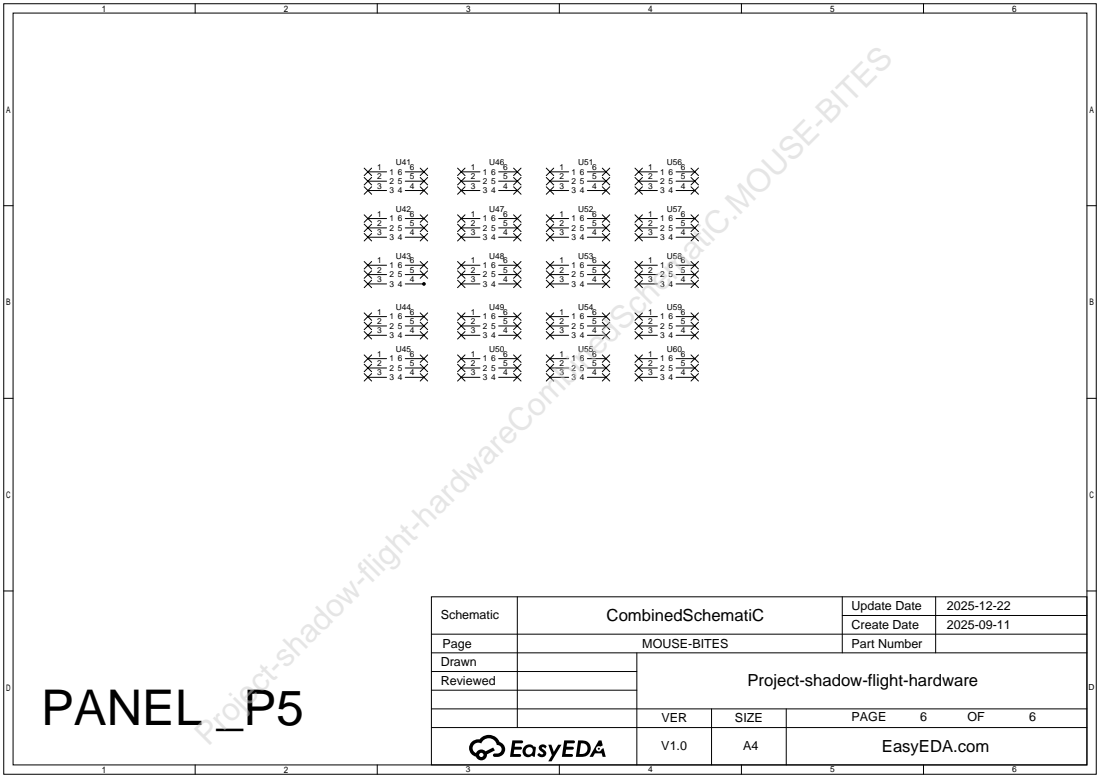
[picture p82: page 6]
