bytecod3/Project-Shadow-Flight/payload/firmware/shadow-flight-payload/Core/Src/main.c

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
/* Includes ------------------------------------------------------------------*/
#include "main.h"
#include "cmsis_os.h"
#include "fatfs.h"
#include "libjpeg.h"

/* USER CODE BEGIN Includes */
#include <stdio.h>
#include <string.h>
#include <stdarg.h>    // for va_list and va_arg functions
#include "task.h"
#include "utils.h"
#include "data_types.h"
#include "state_machine.h"

/* USER CODE END Includes */

/* USER CODE BEGIN PTD */

PAYLOAD_rtos_memory_stats_type_t paylod_mem_stats;
PAYLOAD_sensor_data_t payload_sensor_data;

/* USER CODE END PTD */

/* USER CODE BEGIN PD */

#define LOG_QUEUE_SENDS  (0)   /* whether to log success queue sends */

/* internal board temperature defines */
#define AVG_SLOPE   (2.5F)
#define V_AT_25C	(0.76F)
#define V_REF_INT   (1.21F)

uint8_t update_event = 0;
uint16_t AD_RES[2];
float core_temperature;
float v_sense;
float v_ref;
char tx_buffer[30];

/* USER CODE END PD */

ADC_HandleTypeDef hadc1;
ADC_HandleTypeDef hadc3;
DMA_HandleTypeDef hdma_adc1;

DCMI_HandleTypeDef hdcmi;
DMA_HandleTypeDef hdma_dcmi;

I2C_HandleTypeDef hi2c2;

SPI_HandleTypeDef hspi2;

TIM_HandleTypeDef htim3;

UART_HandleTypeDef huart1;
UART_HandleTypeDef huart2;

osThreadId defaultTaskHandle;
/* USER CODE BEGIN PV */

TaskHandle_t get_payload_rtos_memory_task_handle;
TaskHandle_t get_payload_sensor_data_task_handle;
TaskHandle_t message_dispatcher_task_handle;
TaskHandle_t payload_data_consumer_task_handle;
TaskHandle_t led_active_task_handle;
TaskHandle_t capture_control_task_handle;

/* USER CODE END PV */

void SystemClock_Config(void);
static void MX_GPIO_Init(void);
static void MX_DMA_Init(void);
static void MX_I2C2_Init(void);
static void MX_USART2_UART_Init(void);
static void MX_ADC3_Init(void);
static void MX_DCMI_Init(void);
static void MX_SPI2_Init(void);
static void MX_ADC1_Init(void);
static void MX_TIM3_Init(void);
static void MX_USART1_UART_Init(void);
void StartDefaultTask(void const * argument);

/* USER CODE BEGIN PFP */

/**
 * @brief Task to collect payload statistics
 */
void get_payload_rtos_memory_task(void* argument);

/**
 * @brief get the payload board sensor data
 */
void get_payload_sensor_data_task(void* argument);

/**
 * @brief Get the core temperature for IC
 */
float get_core_temperature(void);

/**
 * @brief receive the core temperature data
 */
void payload_data_consumer(void* argument);

/**
 * @brief task to print messages from the tasks
 */
void message_dispatcher_task(void* argument);

/**
 * @brief blink on-board LED to signal system active. Can be configured OFF to save power
 */
void led_active_task(void* argument);

/**
 * @brief capture control task
 */
extern void capture_control_task(void* argument);


/**
 * @brief custom print function
 */
void myprintf(const char* fmt, ...);


/* define Mutex handle  */
SemaphoreHandle_t printf_mutex;
#define PRINTF_MUTEX_WAIT_TIME   (1000)

/* define Queue handles */
QueueHandle_t payload_memory_stats_queue_handle;
QueueHandle_t payload_sensor_data_queue_handle;
QueueHandle_t message_dispatcher_queue_handle;
QueueHandle_t combined_payload_data_queue_handle;

/* USER CODE END PFP */

/**
  * @brief  The application entry point.
  * @retval int
  */
int main(void)
{

  /* MCU Configuration--------------------------------------------------------*/

  /* Reset of all peripherals, Initializes the Flash interface and the Systick. */
  HAL_Init();

  /* Configure the system clock */
  SystemClock_Config();

  /* Initialize all configured peripherals */
  MX_GPIO_Init();
  MX_DMA_Init();
  MX_I2C2_Init();
  MX_USART2_UART_Init();
  MX_ADC3_Init();
  MX_DCMI_Init();
  MX_SPI2_Init();
  MX_FATFS_Init();
  MX_ADC1_Init();
  MX_TIM3_Init();
  MX_USART1_UART_Init();
  MX_LIBJPEG_Init();
  /* USER CODE BEGIN 2 */

  char board_id_msg[200];

  char* version = "Version: v1.0\r\n";
  char* dev = "Developer: Edwin Mwiti\r\n";
  char* subsys = "Subsystem: PAYLOAD\r\n";
  char* proj = "Project Shadow Flight\r\n";

  sprintf(board_id_msg,
		  "===================================\r\n%s%s%s%s===================================\r\n\n",
		  proj,
		  subsys,
		  dev,
		  version);

  HAL_UART_Transmit(&huart1, (uint8_t*)board_id_msg, strlen(board_id_msg), 100);		/* scheduler has not started yet here */
  HAL_Delay(1000);

  /* core temperature measurement ADC start settings */
  HAL_TIM_Base_Start(&htim3);						/* start timer 3 */
  //HAL_ADCEx_Calibration_Start(&hadc1);				/* start ADC calibration  */
  HAL_ADC_Start_DMA(&hadc1, (uint32_t*)AD_RES, 2); /* start ADC conversion */

  /* USER CODE END 2 */

  /* USER CODE BEGIN RTOS_MUTEX */

  printf_mutex = xSemaphoreCreateMutex();
  if(printf_mutex != NULL) {
	  HAL_UART_Transmit(&huart1,
			  (uint8_t*)"[+] Message Queue mutex created ok\r\n",
			  strlen("[+] Message Queue mutex created ok\r\n"),
			  100
			  );
  } else {
	  HAL_UART_Transmit(&huart1,
		  (uint8_t*)"[-] Could not create message queue mutex\r\n",
		  strlen("[-] Could not create message queue mutex\r\n"),
		  100
		  );
  }

  /* USER CODE END RTOS_MUTEX */

  /* USER CODE BEGIN RTOS_SEMAPHORES */
  /* add semaphores, ... */
  /* USER CODE END RTOS_SEMAPHORES */

  /* USER CODE BEGIN RTOS_TIMERS */
  /* start timers, add new ones, ... */
  /* USER CODE END RTOS_TIMERS */

  /* USER CODE BEGIN RTOS_QUEUES */
  payload_memory_stats_queue_handle = xQueueCreate(PAYLOAD_MEMORY_QUEUE_LENGTH, sizeof(PAYLOAD_rtos_memory_stats_type_t));
  payload_sensor_data_queue_handle = xQueueCreate(PAYLOAD_SENSOR_DATA_QUEUE_LENGTH, sizeof(PAYLOAD_sensor_data_t));
  message_dispatcher_queue_handle = xQueueCreate(10, sizeof(char) * 100); // todo: optimize this -> use char pointer
  combined_payload_data_queue_handle = xQueueCreate(10, sizeof(PAYLOAD_combined_data_t));

  /* check for successful queue creation */
  if(payload_memory_stats_queue_handle != NULL) {
	  // queue create OK // TODO log to file
	  myprintf("[+] payload_memory_stats_queue_handle create OK\r\n");
	  // update system statistics byte
	  // send to messager
  } else {
	  // queue create failed
	  myprintf("[+] payload_memory_stats_queue_handle failed to create\r\n");
	  // send to message
  }

  if(payload_sensor_data_queue_handle != NULL) {
	  // queue create ok
	  myprintf("[+] payload_sensor_data_queue_handle created OK\r\n");
	  // send to messager
  } else {
	  // queue create failed
	  myprintf("[+] payload_sensor_data_queue_handle failed to create\r\n");
	  // send to messager
  }

  if(message_dispatcher_queue_handle != NULL) {
  	  // queue create ok
  	  myprintf("[+] message_dispatcher_queue_handle created OK\r\n");
  	  // send to messager
    } else {
  	  // queue create failed
  	  myprintf("[+] message_dispatcher_queue_handle failed to create\r\n");
  	  // send to messager
    }

  /* USER CODE END RTOS_QUEUES */

  /* Create the thread(s) */
  /* definition and creation of defaultTask */
  osThreadDef(defaultTask, StartDefaultTask, osPriorityNormal, 0, 128);
  defaultTaskHandle = osThreadCreate(osThread(defaultTask), NULL);

  /* USER CODE BEGIN RTOS_THREADS */
  /* add threads, ... */


  myprintf("FREE HEAP before creating tasks: %u\r\n", xPortGetFreeHeapSize());

  BaseType_t default_task = xTaskCreate(StartDefaultTask, "default", 128, NULL, 1, &defaultTaskHandle);
  BaseType_t memstats_create_status = xTaskCreate(get_payload_rtos_memory_task, "memory", 500, NULL, 1, &get_payload_rtos_memory_task_handle);
  BaseType_t payload_sensor_create_status = xTaskCreate(get_payload_sensor_data_task, "sensor_data", 500, NULL, 1, &get_payload_sensor_data_task_handle);
//  BaseType_t message_dispatcher_create_status = xTaskCreate(message_dispatcher_task, "dispatcher", 128, NULL, 1, &message_dispatcher_task_handle);
  BaseType_t payload_consumer_create_status = xTaskCreate(payload_data_consumer, "consumer", 500, NULL, 1, &payload_data_consumer_task_handle);
//  BaseType_t led_active_task_create_status = xTaskCreate(led_active_task, "led_active", 256, NULL, 1, &led_active_task_handle);
  BaseType_t capture_control_task_create_status = xTaskCreate(capture_control_task, "capture_control", 3000, NULL, 1, &capture_control_task_handle);

  /* check for successful creation */
  if(default_task == pdPASS) {
	 myprintf("[+] default_task task created OK \r\n");
  }else {
	 myprintf("[-] default_task task creation Failed \r\n");
  }

  if(memstats_create_status == pdPASS) {
	  myprintf("[+] get_payload_rtos_memory_task task created OK \r\n");
  }else {
	  myprintf("[-] get_payload_rtos_memory_task task creation Failed \r\n");
  }

  if(payload_sensor_create_status == pdPASS) {
	  myprintf("[+] get_payload_sensor_data_task task created OK \r\n");
  }else {
	  myprintf("[-] get_payload_sensor_data_task task creation Failed \r\n");
  }

//  if(message_dispatcher_create_status == pdPASS) {
//	  myprintf("[+] message_dispatcher_task task created OK \r\n");
//  }else {
//	  myprintf("[-] message_dispatcher_task task creation Failed \r\n");
//  }

  if(payload_consumer_create_status == pdPASS) {
	  myprintf("[+] payload_data_consumer_task task created OK \r\n");
  }else {
	  myprintf("[-] payload_data_consumer_task task creation Failed \r\n");
  }

//  if(led_active_task_create_status == pdPASS) {
//	  myprintf("[+] led_active_task created OK\r\n");
//  } else {
//	  myprintf("[-] led_active_task failed to create\r\n");
//  }
//
  if(capture_control_task_create_status == pdPASS) {
	  myprintf("[+] capture_control_task created OK\r\n");
  } else {
	  myprintf("[+] capture_control_task failed to create\r\n");
  }

  /* USER CODE END RTOS_THREADS */
  //myprintf("FREE HEAP before scheduler: %u\r\n", xPortGetFreeHeapSize());

  /* Start scheduler */
  osKernelStart();

  /* We should never get here as control is now taken by the scheduler */

  /* Infinite loop */
  /* USER CODE BEGIN WHILE */
  while (1)
  {
    /* USER CODE END WHILE */

    /* USER CODE BEGIN 3 */

  }
  /* USER CODE END 3 */
}

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
/* USER CODE BEGIN 4 */

/**
 * @brief Task to collect payload statistics
 */

/**
 * @brief Called on ADC conversion complete
 */
void HAL_ADC_ConvCpltCallback(ADC_HandleTypeDef *hadc)
{
  if(hadc->Instance == ADC1) {
	  HAL_GPIO_TogglePin(D2_LED_GPIO_Port, D2_LED_Pin);
	  update_event = 1;					/* update global event */
  }
}

/**
 * @brief Get the core temperature for IC
 */
float get_core_temperature(void){

	if(update_event) {
		v_ref = (float) ((V_REF_INT * 4095) / AD_RES[0]);
		v_sense = (float) (AD_RES[1] * v_ref) / 4095.0;
		core_temperature = (((V_AT_25C - v_sense) * 1000.0) / AVG_SLOPE) + 25.0;
		return core_temperature;
	}

	return core_temperature;

}

/**
 * @brief Task to collect pay-load sensor data
 */
void get_payload_sensor_data_task(void* argument) {

	PAYLOAD_sensor_data_t sensor_data = {0};
	char* stat = "";
	char buff[100];

	for(;;) {

		/* get board temperature */
		float core_temp = get_core_temperature();
		sensor_data.core_temperature = core_temp;

		BaseType_t s_status = xQueueSend(
				payload_sensor_data_queue_handle,
				&sensor_data,
				pdMS_TO_TICKS(100)
				);
		#if LOG_QUEUE_SENDS
			if(s_status != pdPASS) {
				stat = "[-] Could not send data to payload_sensor_data_queue_handle\r\n"; // todo make queue name dynamic
			} else {
				stat = "[+] Data sent to payload_sensor_data_queue_handle\r\n";

			}
		#endif


		snprintf(buff, sizeof(buff), "%s", stat);
		xQueueSend(message_dispatcher_queue_handle, buff, pdMS_TO_TICKS(10));
		update_event = 0;

		vTaskDelay(pdMS_TO_TICKS(100));
	}
}

/**
 * @brief Task to collect payload memory statistics
 */
void get_payload_rtos_memory_task(void* argument) {

	PAYLOAD_rtos_memory_stats_type_t mem_stats = {0};
	char* stat = "";
	char buff[100];

	TickType_t x_last_wake_time;
	x_last_wake_time = xTaskGetTickCount();

	for(;;) {
		float fr_hp_kb = (float)(xPortGetFreeHeapSize()) / KILOBYTE_SIZE;   /* return the number of free bytes in the heap mem */
		float min_ever_kb  = (float)(xPortGetMinimumEverFreeHeapSize()) / KILOBYTE_SIZE;				/* return number of unallocated heap mem */

		mem_stats.free_heap = fr_hp_kb;
		mem_stats.min_ever_free_heap = min_ever_kb;

		/* update queue */
		BaseType_t s_status = xQueueSend(
				payload_memory_stats_queue_handle,
				&mem_stats, pdMS_TO_TICKS(10));

		#if LOG_QUEUE_SENDS
			if(s_status != pdPASS) {
				stat = "[-]Could not send message to payload_memory_stats_queue_handle\r\n";
			} else {
				stat = "[+]message sent to payload_memory_stats_queue_handle\r\n";
			}
		#endif

		snprintf(buff, sizeof(buff), "%s", stat);

		xQueueSend(message_dispatcher_queue_handle, buff, pdMS_TO_TICKS(10));
		vTaskDelayUntil(&x_last_wake_time, pdMS_TO_TICKS(MEMORY_CHECK_FREQ));
	}
}

/**
 * @brief receive the core temperature data
 */
void payload_data_consumer(void* argument){
	PAYLOAD_combined_data_t payload_comb_data;
	PAYLOAD_rtos_memory_stats_type_t mem_data;
	PAYLOAD_sensor_data_t sens_data;

	char* stat_a = "";
	char* stat_b = "";

	char buff[100];
	char recv_data_buff[300];

	TickType_t freq = 2000;
	TickType_t now = xTaskGetTickCount();


	for(;;) {

		/* receive sensor data */
		BaseType_t s = xQueueReceive(payload_sensor_data_queue_handle, &sens_data, 0);

		#if LOG_QUEUE_SENDS
			if(s != pdPASS) {
				stat_b = "Failed to receive from payload_sensor_data_queue_handle\r\n";
			} else {
				stat_b = "Received data from payload_sensor_data_queue_handle\r\n";
			}
		#endif

		snprintf(buff, sizeof(buff), "%s", stat_b);
		xQueueSend(message_dispatcher_queue_handle, buff, pdMS_TO_TICKS(10));

		/* receive memory data */
		BaseType_t x = xQueueReceive(payload_memory_stats_queue_handle, &mem_data, 0);

		#if LOG_QUEUE_SENDS
			if(x != pdPASS) {
				stat_a = "Failed to receive from memory stats queue\r\n\r\n";
			} else {
				stat_a = "Received data from memory stats queue\r\n";
			}
		#endif

		snprintf(buff, sizeof(buff), "%s", stat_a);
		xQueueSend(message_dispatcher_queue_handle ,buff, pdMS_TO_TICKS(10));

		memset(buff, 0, sizeof(buff) );

		payload_comb_data.mem_data.free_heap = mem_data.free_heap;
		payload_comb_data.mem_data.min_ever_free_heap = mem_data.min_ever_free_heap;
		payload_comb_data.mem_data.total_heap = mem_data.total_heap;

		payload_comb_data.sensor_data.core_temperature = sens_data.core_temperature;
		payload_comb_data.sensor_data.ntc_onboard_temperature = sens_data.ntc_onboard_temperature;

		/* display data */
		snprintf(recv_data_buff,
				sizeof(recv_data_buff),
				"free heap: %.2f KB\r\nmin_ever_free_hp: %.2f KB\r\nTotal_heap:%.2f KB\r\nCore temperature: %.2f\r\nNTC_onboard_temperature:%.2f\r\n\r\n",
				payload_comb_data.mem_data.free_heap,
				payload_comb_data.mem_data.min_ever_free_heap,
				payload_comb_data.mem_data.total_heap,
				payload_comb_data.sensor_data.core_temperature,
				payload_comb_data.sensor_data.ntc_onboard_temperature
				);

		myprintf("%s", recv_data_buff);

		vTaskDelayUntil(&now, freq);
	}
}


/**
 * @brief Print messages from a shared Queue
 */
void message_dispatcher_task(void* argument) {

	char recv_buffer[100];

	for(;;){
		if(xQueueReceive(message_dispatcher_queue_handle, recv_buffer, pdMS_TO_TICKS(100)) == pdPASS) {
			myprintf("%s", recv_buffer);
		}

		vTaskDelay(pdMS_TO_TICKS(5));
	}

}

/**
 * @brief blink onboard LED to signala system active. Can be configured OFF to save power
 */
void led_active_task(void* argument) {

	TickType_t x_last_tick = xTaskGetTickCount();
	TickType_t period = 1500;
	uint8_t led_state = 0;

	for(;;) {

		led_state = !led_state;
		HAL_GPIO_WritePin(USER_LED_GPIO_Port, USER_LED_Pin, led_state);

		vTaskDelayUntil(&x_last_tick, pdMS_TO_TICKS(period));

	}
}

/* USER CODE END 4 */

/* USER CODE BEGIN Header_StartDefaultTask */
/**
  * @brief  Function implementing the defaultTask thread.
  * @param  argument: Not used
  * @retval None
  */
/* USER CODE END Header_StartDefaultTask */
void StartDefaultTask(void const * argument)
{
  /* USER CODE BEGIN 5 */
  /* Infinite loop */
  for(;;)
  {
    osDelay(1);
  }
  /* USER CODE END 5 */
}

/**
  * @brief  Period elapsed callback in non blocking mode
  * @note   This function is called  when TIM1 interrupt took place, inside
  * HAL_TIM_IRQHandler(). It makes a direct call to HAL_IncTick() to increment
  * a global variable "uwTick" used as application time base.
  * @param  htim : TIM handle
  * @retval None
  */
void HAL_TIM_PeriodElapsedCallback(TIM_HandleTypeDef *htim)
{
  if (htim->Instance == TIM1)
  {
    HAL_IncTick();
  }
}

/**
  * @brief  This function is executed in case of error occurrence.
  * @retval None
  */
void Error_Handler(void)
{
  /* USER CODE BEGIN Error_Handler_Debug */
  /* User can add his own implementation to report the HAL error return state */
  __disable_irq();
  while (1)
  {
  }
  /* USER CODE END Error_Handler_Debug */
}
#ifdef USE_FULL_ASSERT
/**
  * @brief  Reports the name of the source file and the source line number
  *         where the assert_param error has occurred.
  * @param  file: pointer to the source file name
  * @param  line: assert_param error line source number
  * @retval None
  */
void assert_failed(uint8_t *file, uint32_t line)
{
  /* USER CODE BEGIN 6 */
  /* User can add his own implementation to report the file name and line number,
     ex: printf("Wrong parameters value: file %s on line %d\r\n", file, line) */
  /* USER CODE END 6 */
}
#endif /* USE_FULL_ASSERT */
