bytecod3/Project-Shadow-Flight/payload/firmware/shadow-flight-payload/shadow-flight-payload.ioc

Mcu.UserName=STM32F407VGTx
PA0-WKUP.GPIO_Label=PAYLOAD_NTC
PA0-WKUP.Signal=ADCx_IN0
PA1.GPIO_Label=D2_LED
PA1.Signal=GPIO_Input
PA10.Signal=USART1_RX
PA13.Signal=SYS_JTMS-SWDIO
PA14.Signal=SYS_JTCK-SWCLK
PA15.GPIO_Label=SD_CARD_CS
PA15.Signal=GPIO_Output
PA2.Signal=USART2_TX
PA3.Signal=USART2_RX
PA4.Signal=DCMI_HSYNC
PA5.Signal=SPI1_SCK
PA6.Signal=DCMI_PIXCLK
PA8.GPIO_Label=CAM_MCLK
PA8.Signal=RCC_MCO_1
PA9.Signal=USART1_TX
PB10.Signal=I2C2_SCL
PB11.Signal=I2C2_SDA
PB13.Signal=SPI2_SCK
PB6.Signal=DCMI_D5
PB7.Signal=DCMI_VSYNC
PB8.Signal=DCMI_D6
PB9.Signal=DCMI_D7
PC11.Signal=DCMI_D4
PC13-ANTI_TAMP.GPIO_Label=USER_LED
PC13-ANTI_TAMP.Signal=GPIO_Output
PC14-OSC32_IN.GPIO_Label=ADC_sampling_verification_pin
PC14-OSC32_IN.Signal=GPIO_Output
PC2.Signal=SPI2_MISO
PC3.Signal=SPI2_MOSI
PC5.GPIO_Label=CAM_RESET
PC5.Signal=GPIO_Output
PC6.Signal=DCMI_D0
PC7.Signal=DCMI_D1
PC8.Signal=DCMI_D2
PC9.Signal=DCMI_D3
PH0-OSC_IN.Signal=RCC_OSC_IN
PH1-OSC_OUT.Signal=RCC_OSC_OUT
