bytecod3/Project-Shadow-Flight/firmware/OBC/Core/Inc/main.h

#define ONBOARD_LED_Pin GPIO_PIN_13
#define ONBOARD_LED_GPIO_Port GPIOC
#define USER_BTN_Pin GPIO_PIN_14
#define USER_BTN_GPIO_Port GPIOC
#define USER_LED_GREEN_Pin GPIO_PIN_15
#define USER_LED_GREEN_GPIO_Port GPIOC
#define GPS_ACTIVATE_Pin GPIO_PIN_0
#define GPS_ACTIVATE_GPIO_Port GPIOA
#define GPS_PPS_Pin GPIO_PIN_1
#define GPS_PPS_GPIO_Port GPIOA
#define MAG_INT_Pin GPIO_PIN_3
#define MAG_INT_GPIO_Port GPIOA
#define FLASH_CS_Pin GPIO_PIN_4
#define FLASH_CS_GPIO_Port GPIOA
#define MPU_INT_Pin GPIO_PIN_0
#define MPU_INT_GPIO_Port GPIOB
#define ADCS_BOARD_DETECT_Pin GPIO_PIN_1
#define ADCS_BOARD_DETECT_GPIO_Port GPIOB
#define EPS_BOARD_DETECT_Pin GPIO_PIN_2
#define EPS_BOARD_DETECT_GPIO_Port GPIOB
#define WD_EN_Pin GPIO_PIN_14
#define WD_EN_GPIO_Port GPIOB
#define WATCHDOG_INT_Pin GPIO_PIN_15
#define WATCHDOG_INT_GPIO_Port GPIOB
#define GPS_RX_Pin GPIO_PIN_9
#define GPS_RX_GPIO_Port GPIOA
#define GPS_TX_Pin GPIO_PIN_10
#define GPS_TX_GPIO_Port GPIOA
#define USART_DEBUG_TX_Pin GPIO_PIN_11
#define USART_DEBUG_TX_GPIO_Port GPIOA
#define USART_DBG_RX_Pin GPIO_PIN_12
#define USART_DBG_RX_GPIO_Port GPIOA
#define SD_CS_Pin GPIO_PIN_15
#define SD_CS_GPIO_Port GPIOA
#define COMMS_BOARD_DETECT_Pin GPIO_PIN_5
#define COMMS_BOARD_DETECT_GPIO_Port GPIOB
