bytecod3/Project-Shadow-Flight/firmware/OBC/Core/Src/main.c

/* USER CODE BEGIN Header */
/**
  ******************************************************************************
  * @file           : main.c
  * @brief          : Main program body
  ******************************************************************************
  * @attention
  *
  * Copyright (c) 2025 STMicroelectronics.
  * All rights reserved.
  *
  * This software is licensed under terms that can be found in the LICENSE file
  * in the root directory of this software component.
  * If no LICENSE file comes with this software, it is provided AS-IS.
  *
  * 496e7370697265642062792041706f6c6c6f20383a
  *
  * 496e2074686520626567696e6e696e6720476f64206372656174656420
  * 7468652068656176656e20616e64207468652065617274682ea416e642074686520
  * 65617274682077617320776974686f757420666f726d2c20616e6420766f69643b20616e6420
  * 6461726b6e657373207761732075706f6e207468652066616365206f6620
  * 74686520646565702e20416e642074686520537069726974206f6620476f6420
  * 6d6f7665642075706f6e207468652066616365206f6620
  * 746865207761746572732ea416e6420476f6420736169642c204c657420
  * 7468657265206265206c696768743a20616e6420746865726520
  * 776173206c696768742ea416e6420476f64207361772074686520
  * 6c696768742c20746861742069742077617320676f6f643a20616e6420
  * 476f64206469766964656420746865206c696768742066726f6d2074686520
  * 6461726b6e6573732e
  *
  * 416e6420476f642063616c6c656420746865206c69676874204461792c20616e6420
  * 746865206461726b6e6573732068652063616c6c6564204e696768742e20416e6420
  * 746865206576656e696e6720616e6420746865206d6f726e696e67207765726520
  * 746865206669727374206461792ea416e6420476f6420736169642c204c657420
  * 74686572652062652061206669726d616d656e7420696e20746865206d6964737420
  * 6f6620746865207761746572732c20616e64206c65742069742064697669646520
  * 746865207761746572732066726f6d20746865207761746572732ea416e6420
  * 476f64206d61646520746865206669726d616d656e742c20616e64206469766964656420
  * 74686520776174657273207768696368207765726520756e6465722074686520
  * 6669726d616d656e742066726f6d207468652077617465727320776869636820
  * 776572652061626f766520746865206669726d616d656e743a20616e6420697420
  * 77617320736f2ea416e6420476f642063616c6c65642074686520
  * 6669726d616d656e742048656176656e2e20416e642074686520
  * 6576656e696e6720616e6420746865206d6f726e696e67207765726520
  * 746865207365636f6e64206461792e
  *
  * 416e6420476f6420736169642c204c6574207468652077617465727320
  * 756e646572207468652068656176656e20626520676174686572656420
  * 746f67657468657220756e746f206f6e6520706c6163652c20616e6420
  * 6c65742074686520647279206c616e64206170706561723a20616e6420
  * 69742077617320736f2ea416e6420476f642063616c6c65642074686520
  * 647279206c616e642045617274683b20616e642074686520676174686572696e6720
  * 746f676574686572206f6620746865207761746572732063616c6c656420686520
  * 536561733a20616e6420476f642073617720746861742069742077617320676f6f642e
  *
  ******************************************************************************
  */
/* USER CODE END Header */
/* Includes ------------------------------------------------------------------*/
#include "main.h"
#include "cmsis_os.h"

/* USER CODE BEGIN Includes */
#include "FreeRTOS.h"
#include "stdio.h"
#include "string.h"
#include "stdlib.h"
#include "math.h"
#include "defines.h"
#include "filter_config.h"
#include "command_engine.h"
#include "data_types.h"
#include "logger.h"
#include "semphr.h"

/* USER CODE END Includes */

/* USER CODE BEGIN PD */

/* initialize internal logger */
Logger* internal_logger;

/* USER CODE END PD */

/* USER CODE BEGIN PM */

/**
 * QUEUE DEFINITIONS
 */
QueueHandle_t heap_stats_queue = NULL;

/* USER CODE END PM */

I2C_HandleTypeDef hi2c1;

SPI_HandleTypeDef hspi1;

UART_HandleTypeDef huart1;
UART_HandleTypeDef huart6;
DMA_HandleTypeDef hdma_usart1_rx;

osThreadId defaultTaskHandle;
/* USER CODE BEGIN PV */
osThreadId x_task_create_tasks_tsk_handle;
osThreadId x_task_dummy_data_tsk_handle;
osThreadId x_task_control_onboard_led_tsk_handle;
osThreadId x_task_control_onboard_buzzer_tsk_handle;
osThreadId x_task_get_watchdog_tsk_handle;
osThreadId x_task_core_fsm_monitor_tsk_handle;
osThreadId x_task_get_heap_memory_stats_tsk_handle;
osThreadId x_task_get_task_stats_tsk_handle;
osThreadId x_task_blink_onboard_tsk_handle;

/* USER CODE END PV */

void SystemClock_Config(void);
static void MX_GPIO_Init(void);
static void MX_DMA_Init(void);
static void MX_I2C1_Init(void);
static void MX_SPI1_Init(void);
static void MX_USART1_UART_Init(void);
static void MX_USART6_UART_Init(void);
void StartDefaultTask(void const * argument);

/* USER CODE BEGIN PFP */


/**
 * @fn void x_task_dummy_data(const void*)
 * @brief This function generates a fake dummy data values
 *
 * @param argument
 */
void x_task_dummy_data(void const* argument);

/**
 * @fn void x_task_create_tasks(const void*)
 * @brief This function creates all the tasks then self-deletes
 *
 * @param argument parameter to the task
 */
void x_task_create_tasks(void const* argument);

/**
 * @fn void x_task_control_onboard_led(const void*)
 * @brief This task controls the on-board LEDs depending on the state
 *
 * @param argument parameter to the task
 */
void x_task_control_onboard_led(void const* argument);

/**
 * @fn void x_task_control_onboard_buzzer(const void*)
 * @brief
 *
 * @param argument parameter to the task
 */
void x_task_control_onboard_buzzer(void const* argument);

/**
 * @fn void x_task_get_watchdog(void const*)
 * @brief
 *
 * @param argument
 */
void x_task_get_watchdog(void const* argument);

/**
 * @fn void x_task_core_fsm_monitor(const void*)
 * @brief This task monitors the current state of the device and calls relevant action
 *
 * @param argument
 */
void x_task_core_fsm_monitor(void const* argument);

/**
 * @fn void x_task_get_heap_memory_stats(const void*)
 * @brief This task collects the heap memory usage statistics
 *
 * @param argument parameter to the task
 */
void x_task_get_heap_memory_stats(void const* argument);

/**
 * @fn void x_task_get_task_stats(const void*)
 * @brief This task gets information about the tasks currently running
 *
 * @param argument
 */
void x_task_get_task_stats(void const* argument);

/**
 * @fn void x_task_read_acceleration(const void*)
 * @brief Thif task read the pure acceleration from the accelerometer
 *
 * @param argument parameter to the task
 */
void x_task_read_acceleration(void const* argument);

/**
 * @fn void x_task_read_imu(const void*)
 * @brief This task reads the inertial measurement unit
 *
 * @param argument
 */
void x_task_read_imu(void const* argument);

/**
 * @fn void x_task_read_magnetometer(const void*)
 * @brief This task reads the magnetometer/compass
 *
 * @param argument
 */
void x_task_read_magnetometer(void const* argument);

/**
 * @fn void x_task_read_temperature(const void*)
 * @brief This function reads the temperature from the onboard temperature sensor
 * on the OBC
 *
 * @param argument
 */
void x_task_read_temperature(void const* argument);

/**
 * @fn void x_task_sun_sensors(const void*)
 * @brief This function reads the light value from the sun sensors
 *
 * @param argument
 */
void x_task_sun_sensors(void const* argument);

/**
 * @fn void x_task_read_GPS(const void*)
 * @brief This function reads the GPS coordinates
 *
 * @param argument
 */
void x_task_read_GPS(void const* argument);

/**
 * @fn void x_task_data_dispatcher(const void*)
 * @brief This task sends the data to relevant queues
 *
 * @param argument
 */
void x_task_data_dispatcher(void const* argument);

/**
 * @fn void x_task_sensor_queue_notify(const void*)
 * @brief
 *
 * @param argument
 */
void x_task_sensor_queue_notify(void const* argument);

/**
 * @fn void x_task_kalman_filter(const void*)
 * @brief This task filters the sensor data using Kalman Filter
 *
 * @param argument
 */
void x_task_kalman_filter(void const* argument);

/**
 * @fn void x_task_median_filter(const void*)
 * @brief This function filters data using median filter
 *
 * @param argument
 */
void x_task_median_filter(void const* argument);

/**
 * @fn void x_task_moving_avg_filter(const void*)
 * @brief This task filters data using the moving average filter
 *
 * @param argument
 */
void x_task_moving_avg_filter(void const* argument);

/**
 * @fn void x_task_complementary_filter(const void*)
 * @brief This task filters data using complementary filter
 *
 * @param argument
 */
void x_task_complementary_filter(void const* argument);

/**
 * @fn void x_task_compose_telemetry_packet(const void*)
 * @brief This task arranged the telemetry data for transmission to ground
 *
 * @param argument
 */
void x_task_compose_telemetry_packet(void const* argument);

/**
 * @fn void x_task_transmit_telemetry(const void*)
 * @brief This task transmits telemetry packet to ground station
 *
 * @param argument
 */
void x_task_transmit_telemetry(void const* argument);

/**
 * @fn void x_task_check_fault(const void*)
 * @brief This task contantly monitors relevant thresholds to check for faults
 *
 * @param argument
 */
void x_task_check_fault(void const* argument);

/**
 * @fn void x_task_blink_onboard(const void*)
 * @brief This task blinks the onboard LED at intervals
 *
 * @param argument
 */
void x_task_blink_onboard(void const* argument);

/**
 * @fn void x_task_debug_to_uart(const void*)
 * @brief This task prints data to UART
 *
 * @param argument
 */
void x_task_debug_to_uart(void const* argument);

/* USER CODE END PFP */

/**
  * @brief  The application entry point.
  * @retval int
  */
int main(void)
{

  /* MCU Configuration--------------------------------------------------------*/

  /* Reset of all peripherals, Initializes the Flash interface and the Systick. */
  HAL_Init();

  /* USER CODE BEGIN Init */

  internal_logger = logger_create();


  /* USER CODE END Init */

  /* Configure the system clock */
  SystemClock_Config();

  /* Initialize all configured peripherals */
  MX_GPIO_Init();
  MX_DMA_Init();
  MX_I2C1_Init();
  MX_SPI1_Init();
  MX_USART1_UART_Init();
  MX_USART6_UART_Init();
  /* USER CODE BEGIN RTOS_MUTEX */
  /* add mutexes, ... */
  /* USER CODE END RTOS_MUTEX */

  /* USER CODE BEGIN RTOS_SEMAPHORES */
  /* add semaphores, ... */
  /* USER CODE END RTOS_SEMAPHORES */

  /* USER CODE BEGIN RTOS_TIMERS */
  /* start timers, add new ones, ... */
  /* USER CODE END RTOS_TIMERS */

  /* USER CODE BEGIN RTOS_QUEUES */
  /* create the queues */
  heap_stats_queue = xQueueCreate(HEAP_STATS_QUEUE_LENGTH, sizeof(heap_statistics_type_t));

  /* check queues created OK */
  if(heap_stats_queue == NULL) {
	  // todo: send to logger
  } else {
	  // todo: send to logger
  }

  /* USER CODE END RTOS_QUEUES */

  /* Create the thread(s) */
  /* definition and creation of defaultTask */
  osThreadDef(defaultTask, StartDefaultTask, osPriorityNormal, 0, 128);
  defaultTaskHandle = osThreadCreate(osThread(defaultTask), NULL);

  /* USER CODE BEGIN RTOS_THREADS */

  /* fetch heap memory statistics */
  /*osThreadDef(heap_stats_task, x_task_get_heap_memory_stats, osPriorityNormal, 0, 1024);
  x_task_get_heap_memory_stats_tsk_handle = osThreadCreate(osThread(heap_stats_task), NULL);*/

  /* blink on-board LED for status indication */
  osThreadDef(onboard_led_blink, x_task_blink_onboard, osPriorityLow, 0, 1000);
  x_task_control_onboard_led_tsk_handle = osThreadCreate(osThread(onboard_led_blink), NULL);

  /* initialize DMA receive command */
  HAL_UART_Transmit(&huart6, (uint8_t*)"Booting on-board computer...\r\n", strlen("Booting..\r\n"), 200);

  /* initialize the command engine */
  command_engine_start();

  /* USER CODE END RTOS_THREADS */

  /* Start scheduler */
  osKernelStart();

  /* We should never get here as control is now taken by the scheduler */

  /* Infinite loop */
  /* USER CODE BEGIN WHILE */
  while (1)
  {
    /* USER CODE END WHILE */

    /* USER CODE BEGIN 3 */
  }
  /* USER CODE END 3 */
}

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
/* USER CODE BEGIN 4 */

/**
 * @fn void x_task_blink_onboard(const void*)
 * @brief This task blinks the onboard LED at intervals
 *
 * @param argument
 */
void x_task_blink_onboard(void const* argument) {
	TickType_t x_last_wake_time = xTaskGetTickCount();
	static uint8_t led_state = 0;

	for(;;) {

		HAL_GPIO_WritePin(ONBOARD_LED_GPIO_Port, ONBOARD_LED_Pin, led_state);
		led_state = !led_state;
		vTaskDelayUntil(&x_last_wake_time, pdMS_TO_TICKS(ONBOARD_LED_BLINK_INTERVAL));

	}

}

/**
 * @fn void x_task_get_heap_memory_stats(const void*)
 * @brief This task fetches remaining heap memory from main memory heap at the time of call
 * It also fetches the minimum ever free heap size, to know how low we have ever gone to running out
 * of heap memory
 *
 * @param args
 */
void x_task_get_heap_memory_stats(const void* args) {
	TickType_t x_last_woken = xTaskGetTickCount();

	size_t free_hp;
	size_t min_ever_hp;
	heap_statistics_type_t hp_stats;
	BaseType_t q_send_status;

	for(;;) {

		free_hp = xPortGetFreeHeapSize();
		min_ever_hp = xPortGetMinimumEverFreeHeapSize();

		hp_stats.free_heap = free_hp;
		hp_stats.minimum_ever_heap = min_ever_hp;
		q_send_status = xQueueSend(heap_stats_queue, &hp_stats, 0);
		//internal_logger->_log_to_uart(internal_logger, &huart6);

		/* add heart-beat checking every defined interval */
		vTaskDelayUntil(&x_last_woken, pdMS_TO_TICKS(HEAP_CHECK_INTERVAL));

		/* check for queue send status */
		if(q_send_status == pdPASS) {
			//internal_logger->_log_to_uart_msg(internal_logger, &huart6, "Sent to queue\r\n");
		} else {
			//internal_logger->_log_to_uart_msg(internal_logger, &huart6, "Queue full\r\n");
		}
	}
}

/**
 * @fn void x_task_debug_to_uart(const void*)
 * @brief This task prints data to UART
 *
 * @param argument
 */
void x_task_debug_to_uart(void const* argument) {
	for(;;) {
	}
}

/**
 * @fn void x_task_get_watchdog(void const*)
 * @brief
 *
 * @param argument
 */
void x_task_get_watchdog(void const* argument) {

}

/*
 * callback for receiving data via UART DMA
 */

void HAL_UARTEx_RxEventCallback(UART_HandleTypeDef* huart, uint16_t Size) {

	if(huart == &huart1) {
		/* We receive commands from UART1 -> connected to a test harness */
		BaseType_t pxHigherPriorityTaskWoken = pdTRUE;
		raw_cubesat_command_t cmd;
		cmd.length = Size;

		memcpy(cmd.command, rx_dma_buffer, Size);
		cmd.command[Size] = '\0';

		if(Size > 0) { /* only send if there is actual data available */
			if(xQueueSendFromISR(raw_command_queue, &cmd, &pxHigherPriorityTaskWoken) == pdPASS) {
				// TODO: log success
			} else {
				// TODO: log error
			}
		}

		/* restart DMA receiver */
		//__HAL_UART_CLEAR_IDLEFLAG(&huart1); /* clear idle flag manually */
		HAL_UARTEx_ReceiveToIdle_DMA(&huart1, (uint8_t*)rx_dma_buffer, MAX_UART_DMA_COMMAND_LENGTH);
		__HAL_DMA_DISABLE_IT(huart->hdmarx, DMA_IT_HT);

		portYIELD_FROM_ISR(pxHigherPriorityTaskWoken);
	}
}

/* USER CODE END 4 */

/* USER CODE BEGIN Header_StartDefaultTask */
/**
  * @brief  Function implementing the defaultTask thread.
  * @param  argument: Not used
  * @retval None
  */
/* USER CODE END Header_StartDefaultTask */
void StartDefaultTask(void const * argument)
{
  /* USER CODE BEGIN 5 */
  /* Infinite loop */
  for(;;)
  {
    osDelay(1);
  }
  /* USER CODE END 5 */
}

/**
  * @brief  Period elapsed callback in non blocking mode
  * @note   This function is called  when TIM1 interrupt took place, inside
  * HAL_TIM_IRQHandler(). It makes a direct call to HAL_IncTick() to increment
  * a global variable "uwTick" used as application time base.
  * @param  htim : TIM handle
  * @retval None
  */
void HAL_TIM_PeriodElapsedCallback(TIM_HandleTypeDef *htim)
{
  if (htim->Instance == TIM1)
  {
    HAL_IncTick();
  }
}

/**
  * @brief  This function is executed in case of error occurrence.
  * @retval None
  */
void Error_Handler(void)
{
  /* USER CODE BEGIN Error_Handler_Debug */
  /* User can add his own implementation to report the HAL error return state */
  __disable_irq();
  while (1)
  {
  }
  /* USER CODE END Error_Handler_Debug */
}
#ifdef USE_FULL_ASSERT
/**
  * @brief  Reports the name of the source file and the source line number
  *         where the assert_param error has occurred.
  * @param  file: pointer to the source file name
  * @param  line: assert_param error line source number
  * @retval None
  */
void assert_failed(uint8_t *file, uint32_t line)
{
  /* USER CODE BEGIN 6 */
  /* User can add his own implementation to report the file name and line number,
     ex: printf("Wrong parameters value: file %s on line %d\r\n", file, line) */
  /* USER CODE END 6 */
}
#endif /* USE_FULL_ASSERT */
