bytecod3/Project-Shadow-Flight/payload/firmware/shadow-flight-payload/Drivers/OV7670/ov7670.c

/*
 * @file ov7670.c
 *
 * @date: Jun 5, 2026
 * @author: edwin
 */


#include <stdio.h>
#include <main.h>
#include "ov7670.h"
#include "ov7670_reg_config.h"
#include "stm32f4xx_hal.h"


static DCMI_HandleTypeDef* sp_hdcmi;
static DMA_HandleTypeDef* sp_hdma_dcmi;
static I2C_HandleTypeDef* sp_hi2c;

static uint32_t s_dest_address_continous_mode;
static void(*s_cb_hsync)(uint32_t h);
static void(*s_cb_vsync)(uint32_t h);
static uint32_t s_current_h;
static uint32_t s_current_v;

uint32_t frame_buffer[QQVGA_WIDTH * QQVGA_HEIGHT] = {};

/**
 * @brief write 8 bit data to camera module
 */
HAL_StatusTypeDef ov7670_i2c_write(uint8_t reg_addr, uint8_t data) {

	HAL_StatusTypeDef s;
	do {
		s = HAL_I2C_Mem_Write(
				sp_hi2c,
				OV7670_SLAVE_ADDRESS,
				reg_addr,
				I2C_MEMADD_SIZE_8BIT,
				&data,
				1,
				100
				);

	} while (s != HAL_OK && 0); // todo: add retry logic

	return s;
}

/**
 * @brief read 8-bit data from camera module
 */
HAL_StatusTypeDef ov7670_i2c_read(uint8_t reg_addr, uint8_t* data) {
	HAL_StatusTypeDef s;

	do {
//		s = HAL_I2C_Mem_Read(
//				sp_hi2c,
//				OV7670_SLAVE_ADDRESS,
//				reg_addr,
//				I2C_MEMADD_SIZE_8BIT,
//				data,
//				1,
//				1000
//
//		);

		s = HAL_I2C_Master_Transmit(
				sp_hi2c,
				OV7670_SLAVE_ADDRESS,
				&reg_addr,
				1,
				100
				);

		s |= HAL_I2C_Master_Receive(
				sp_hi2c,
				OV7670_SLAVE_ADDRESS,
				data,
				I2C_MEMADD_SIZE_8BIT,
				100);

	} while (s != HAL_OK && 0); // sends once todo: add definite retry logic

	return s;
}

/* function definitions */
PAYLOAD_STATUS_T ov7670_init(DCMI_HandleTypeDef* p_hdcmi, DMA_HandleTypeDef* p_hdma_dcmi, I2C_HandleTypeDef* p_hi2c) {
	myprintf("OV7670: Initialising camera...\r\n");
	sp_hdcmi = p_hdcmi;
	sp_hdma_dcmi = p_hdma_dcmi;
	sp_hi2c = p_hi2c;

	s_dest_address_continous_mode = 0;

	/* wake up the camera */
	HAL_GPIO_WritePin(CAM_RESET_GPIO_Port, CAM_RESET_Pin, GPIO_PIN_RESET);
	HAL_Delay(100);
	HAL_GPIO_WritePin(CAM_RESET_GPIO_Port, CAM_RESET_Pin, GPIO_PIN_SET);
	HAL_Delay(100);

	/* reset */
	ov7670_i2c_write(COM7_REG, RESET_COMMAND);
	HAL_Delay(30);

	/* read the device ID */
	uint8_t buffer[1];
	ov7670_i2c_read(PID_REG, buffer);

	myprintf("OV7670: Verifying camera: Product ID buffer: ");
	myprintf("0x%02X\r\n", buffer[0]);

	return PAYLOAD_STATUS_OK;
}

PAYLOAD_STATUS_T ov7670_config(uint32_t mode) {
	//ov7670_stop_capture();
	ov7670_i2c_write(0x12, 0x80);
	HAL_Delay(30);

	/* initialize register values */
	for(int i = 0; OV7670_REGS[i][0] != REG_BATT; i++ ) {
		ov7670_i2c_write(OV7670_REGS[i][0], OV7670_REGS[i][1]);
		HAL_Delay(1);
	}

	return PAYLOAD_STATUS_OK;
}

volatile int frame_ready = 0;

PAYLOAD_STATUS_T ov7670_start_capture(uint32_t cap_mode, void* dest_address) {
	//ov7670_stop_capture();
	HAL_StatusTypeDef status = 0;
	uint8_t inspect_buffer = 0;

	if(cap_mode == OV7670_CAP_CONTINUOUS) {
		/* continuous capture mode automatically invokes DCMI, but DMA needs to be started manually */
		s_dest_address_continous_mode = dest_address;
		myprintf("OV767O: Capturing in OV7670_CAP_CONTINUOUS mode\r\n");
		status = HAL_DCMI_Start_DMA(sp_hdcmi, DCMI_MODE_CONTINUOUS, (uint32_t) dest_address, QQVGA_WIDTH * QQVGA_HEIGHT / 2);
		myprintf("OV7670_CAP_CONTINUOUS - DMA call status: 0x%02X\r\n", status);

	} else if(cap_mode == OV7670_CAP_SINGLE_FRAME) {
		//s_dest_address_continous_mode = 0;
		myprintf("OV767O: Capturing in OV7670_CAP_SINGLE_FRAME mode\r\n");

		// check the handles to be non-zero
		myprintf("DEST buffer = %p\r\n", dest_address);
		myprintf("Length = %p\r\n", (QQVGA_WIDTH * QQVGA_HEIGHT / 2));

		if (HAL_DCMI_Start_DMA(sp_hdcmi, DCMI_MODE_SNAPSHOT, (uint32_t) dest_address, QQVGA_WIDTH * QQVGA_HEIGHT / 2) == HAL_OK) {
			myprintf("OK\r\n");
		} else {
			myprintf("Failed to start\r\n");
		}

		myprintf("OV7670_CAP_SINGLE_FRAME - DMA call status: 0x%02X\r\n", status);

	}

//	while(!frame_ready){
//		myprintf("Capturing...\r\n");
//	}

	// inspect the frame buffer
	if(inspect_buffer) {
		myprintf("Inspecting captured frame buffer \r\n\r\n");
		uint16_t* frame = (uint16_t*) dest_address;

		for (int i = 0; i < (QQVGA_WIDTH * QQVGA_HEIGHT); i++) {
			myprintf("0x%04X\r\n", frame[i]);
		}
	}

	return PAYLOAD_STATUS_OK;
}

PAYLOAD_STATUS_T ov7670_stop_capture() {

	HAL_StatusTypeDef  s = HAL_DCMI_Stop(sp_hdcmi);

	return PAYLOAD_STATUS_OK;
}

void ov7670_register_callback(
		void(*hsync_cb)(uint32_t h),
		void(*vsync_cb)(uint32_t h)
) {
	s_cb_hsync = hsync_cb;
	s_cb_vsync = vsync_cb;

}

/**
 *@brief Called on DCMI transfer complete
 */
void HAL_DCMI_FrameEventCallback(DCMI_HandleTypeDef* hdcmi) {
	HAL_DCMI_Stop(hdcmi);

	myprintf("OV7670: Single frame captured\r\n");
//	frame_ready = 1;
	if (s_cb_vsync) {
		s_cb_vsync(s_current_v);
	}

	if(s_dest_address_continous_mode != 0) {
		HAL_DMA_Start_IT(
				hdcmi->DMA_Handle,
				(uint32_t)&hdcmi->Instance->DR,
				s_dest_address_continous_mode,
				QQVGA_WIDTH * QQVGA_HEIGHT/2
		);
	}

	s_current_v++;
	s_current_h = 0;

}

/**
 * @brief DCMI error callback. Useful for debugging sync and DMA errors
 */
void HAL_DCMI_ErrorCallback(DCMI_HandleTypeDef* hdcmi) {
	myprintf("DCMI DMA transfer error with code: %ld\r\n", HAL_DCMI_GetError(hdcmi));
}
