bytecod3/Project-Shadow-Flight/payload/firmware/shadow-flight-payload/Drivers/OV7670/ov7670.h

/*
 * @file ov7670.h
 *
 * @date: Jun 5, 2026
 * @author: edwin
 */

#ifndef OV7670_OV7670_H_
#define OV7670_OV7670_H_

#include "stm32f4xx_hal.h"
#include "ov7670_regs.h"
#include "utils.h"

extern DCMI_HandleTypeDef hdcmi;

#define OV7670_SLAVE_ADDRESS 			(0x42)  /* 42 for write */
#define OV7670_CAP_CONTINUOUS 			(0)
#define OV7670_CAP_SINGLE_FRAME 		(1)

#define QQVGA_WIDTH 					(160) // QQVGA
#define QQVGA_HEIGHT 					(120)

extern uint32_t frame_buffer[QQVGA_WIDTH * QQVGA_HEIGHT]; // for RGB565

typedef enum{
	OV7670_STATUS_ERR = 0,
	OV7670_STATUS_OK = 1

} OV7670_STATUS;

/* settings and camera commands */
#define RESET_COMMAND (0x80)

PAYLOAD_STATUS_T ov7670_init(DCMI_HandleTypeDef* p_hdcmi, DMA_HandleTypeDef* p_hdma_dcmi, I2C_HandleTypeDef* p_hi2c);
PAYLOAD_STATUS_T ov7670_config(uint32_t mode);

PAYLOAD_STATUS_T ov7670_start_capture(uint32_t cap_mode, void* dest_address);

PAYLOAD_STATUS_T ov7670_stop_capture();

void ov7670_register_callback(void (*cb_hsync)(uint32_t h), void(*cb_vsync)(uint32_t v));

/* i2c functions */
HAL_StatusTypeDef ov7670_i2c_write(uint8_t reg_addr, uint8_t data);

HAL_StatusTypeDef ov7670_i2c_read(uint8_t reg_addr, uint8_t* data);

#endif /* OV7670_OV7670_H_ */
