bytecod3/Project-Shadow-Flight/(commit log)

2025-08-15 ADDS battery sizing spreadsheet
2025-08-17 ADDS voltage divider resolver
    [DC-voltage-measure.ioc, main.c, main.h]
2025-08-17 ADDS raw voltage measure
2025-08-17 ADDS preliminary DC voltage measurement 12V :tada:
2025-08-21 ADDS MCP23017-ESP32 :tada:
2025-08-23 UPDATES OBC STM32 pinout :art:
2025-08-23 ADDS ADXL345 driver
2025-08-24 SETS power mode ADXL
2025-08-24 ADDS ADXL345 verification with ESP32
2025-08-24 FIXES bit-shifting for ADXL345 :rocket:
    [main.cpp]
2025-08-25 ADDS structure references and credits :rocket:
    [Installing a kill switch with additional parts #1.SLDASM]
2025-09-06 adds camera
2025-09-07 FIXES missing VCAP_2 on payload :lock:
    [shadow-flight-payload.ioc]
2025-09-08 ADDS payload PCB
2025-09-08 CONFIGURES SD select pin
2025-09-09 UPDATES accelerometer struct
2025-09-17 adds PCB todo
2025-09-27 ADDS Normal DMA UART receive
2025-09-27 ADDS UART IDLE line interrupt
2025-09-27 ADDS UART IDLE LINE
2025-10-14 ADDS GPS DMA
2025-12-22 CREATES magnetorquer design
2025-12-30 ADDS structure design files
    [shadow-flight-structure.FCStd]
2026-01-01 ADDS offline project documentation
    [shadow-flight-structure.FCStd]
2026-01-05 ADDS STL structure production files
    [bottom-chassis.stl, negative-x.stl, negative-z.stl, positive-x.stl, positive-z.stl, top-cover.stl]
2026-01-25 ADDS UART command receive via DMA
2026-01-27 ADDS thread for GPIO blink
2026-02-08 ADDS logger single msg print :memo:
2026-02-14 ADDS working DMA UART receive event
2026-04-04 ADDS test jig hardware
    [project_shadow_flight_BOM_Combined.xlsx, project_shadow_flight_pick_and_place_v1.xlsx]
2026-04-06 ADDS payload core temperature sensing
2026-04-06 FIXES DMA continous conversion
    [main.c]
2026-04-15 ADDS PAYLOD sensor data struct
    [test_jig_bom.xlsx, test_jig_pick_and_place.xlsx]
2026-04-18 ADDS payload and sensor memory queues
2026-05-01 CHANGES placement of TRACE START
2026-05-28 ADDS led active payload check
2026-06-06 ADDS OV7670 camera registers
2026-06-07 ADDS camera registers
2026-06-07 ADDS ov7670 I2C init
2026-06-07 ADDS camera init function reset
    [ov7670.c, ov7670.h]
2026-07-07 ADDS capture init to camera driver
2026-07-07 ADDS camera proxy interface
2026-07-07 COMPLETES camera interface proxy
2026-07-12 ADDS SD card mount status to name translation
2026-07-24 SUCCESS captured camera PID successfully
2026-09-07 FIXES char storage in message dispatcher queue
    [main.c, ov7670.c]
2026-09-09 VERIFIES DMA and DCMI handles
2026-09-09 DCMI->DMA handle valid
2026-09-12 ADDS camera config bytes
2026-09-19 [FIXES] Local stack FATFS object for issue #91
    [main.c]
2026-09-21 ADDS confirms DMA OK
2026-09-24 adds code Profile to HAL DMA IT
